MichaelPate/ToasterFlo/README.md

# ToasterFlo
 Control a toaster oven to make PCB assemblies
