MichaelPate/ToasterFlo/mainBoard/Images/review/pcb_all_layers.png

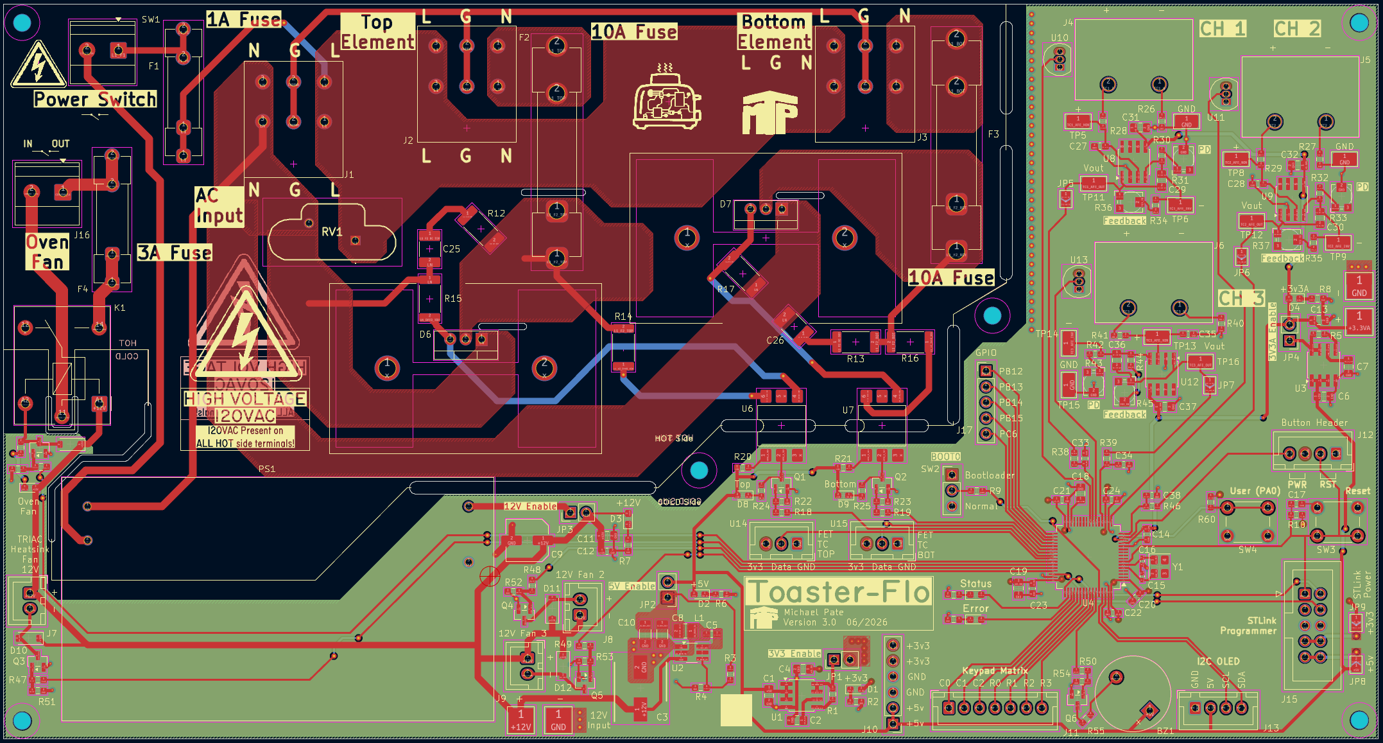
mainBoard/Images/review/pcb_all_layers.png
