MichaelPate/ToasterFlo/mainBoard/Images/review/pcb_no_silk.png

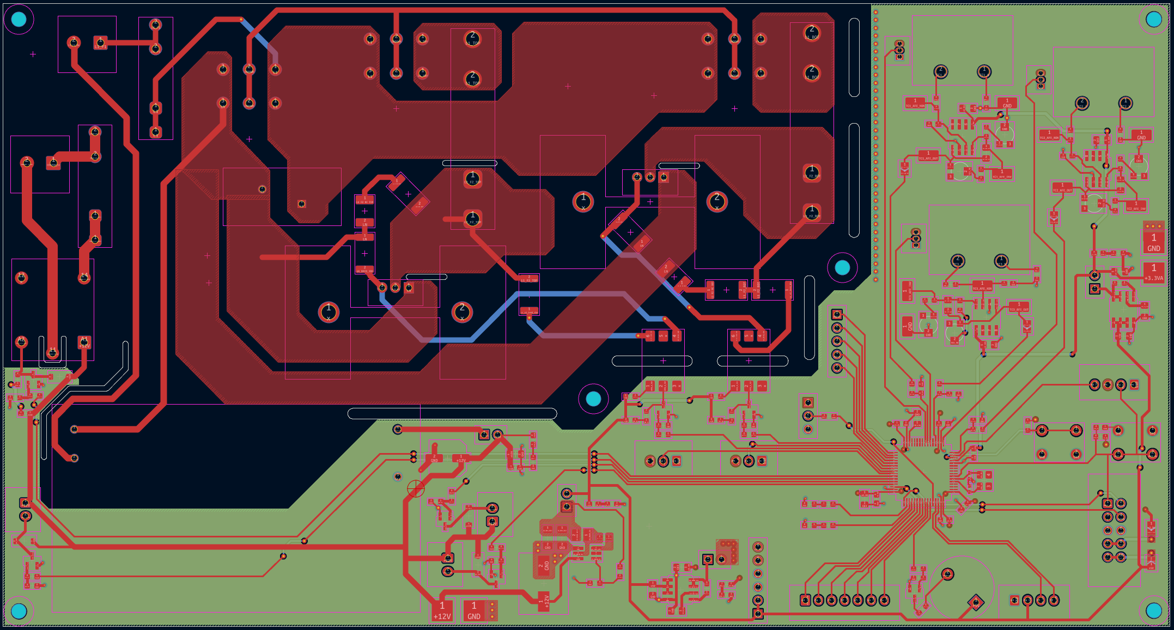
mainBoard/Images/review/pcb_no_silk.png
