MichaelPate/ToasterFlo/mainBoard/Images/review/pcb_no_zones.png

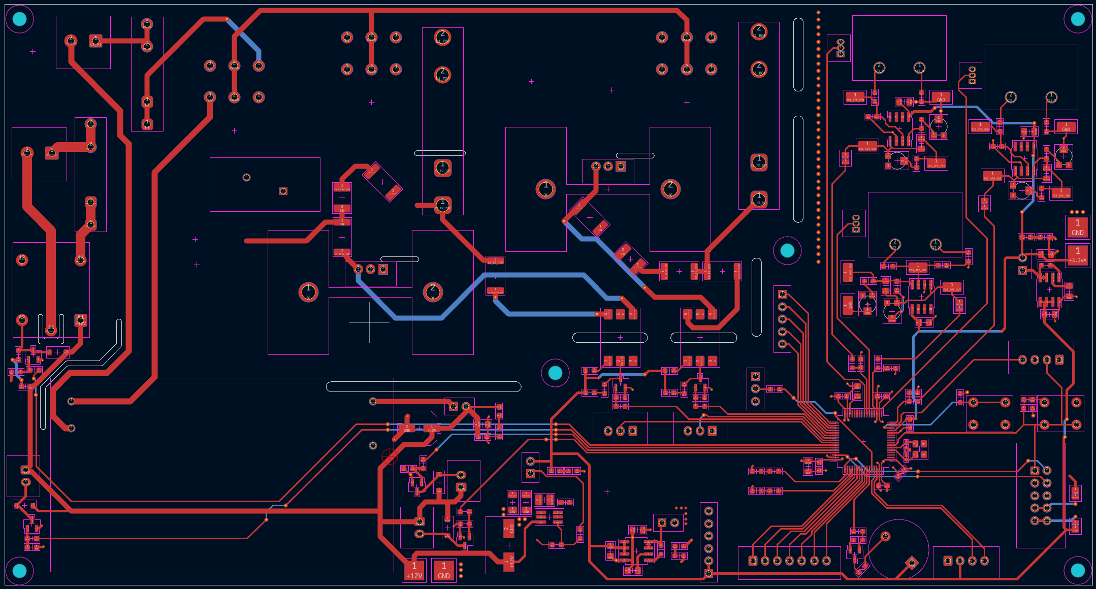
mainBoard/Images/review/pcb_no_zones.png
