MichaelPate/ToasterFlo/mainBoard/Images/review/review_07-29-2026/mainBoard-5.png

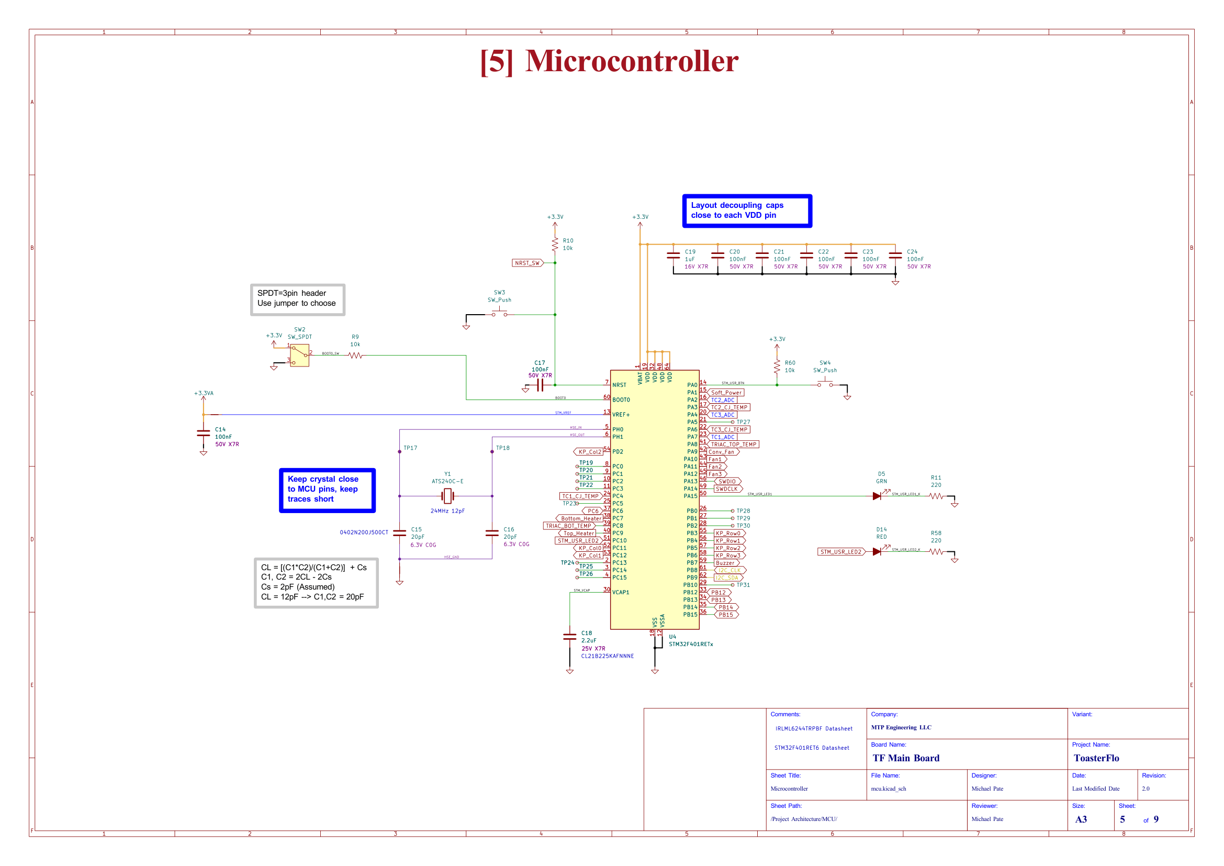
mainBoard/Images/review/review_07-29-2026/mainBoard-5.png
