MichaelPate/ToasterFlo/mainBoard/Images/review/review_07-29-2026/mainBoard-6.png

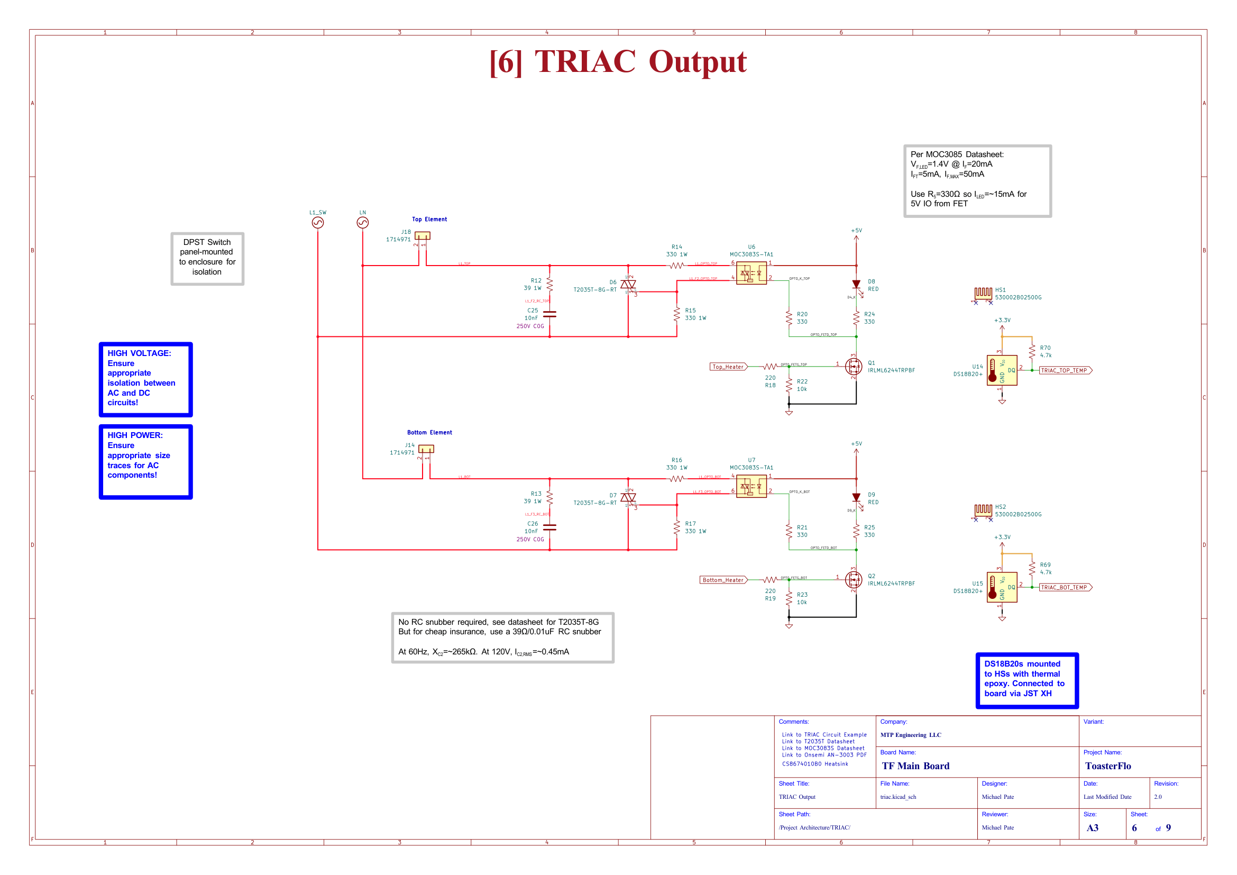
mainBoard/Images/review/review_07-29-2026/mainBoard-6.png
