MichaelPate/ToasterFlo/mainBoard/Images/review/review_07-29-2026/mainBoard-9.png

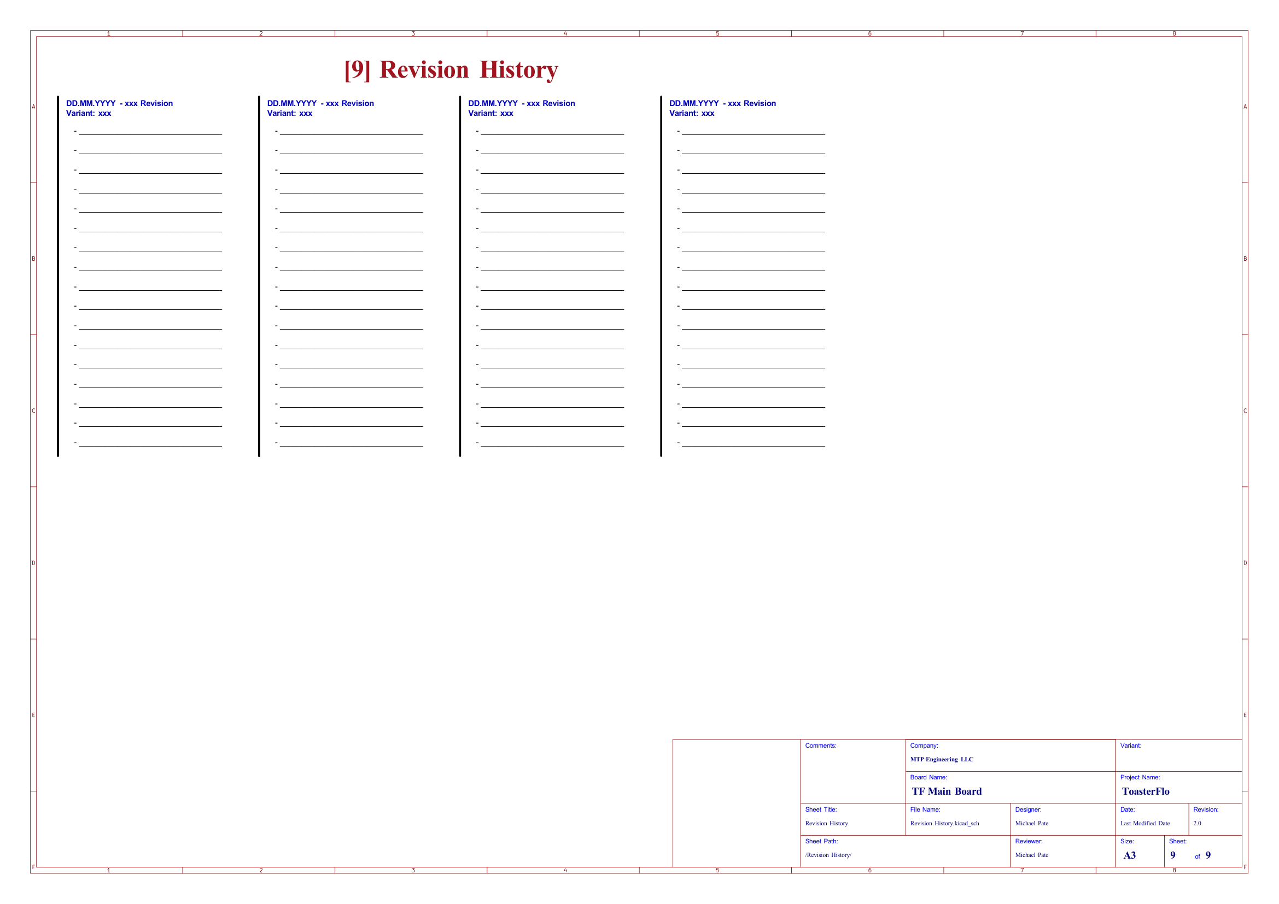
mainBoard/Images/review/review_07-29-2026/mainBoard-9.png
