MichaelPate/ToasterFlo/mainBoard/Images/review/review_07-29-2026/pcb_bottom.png

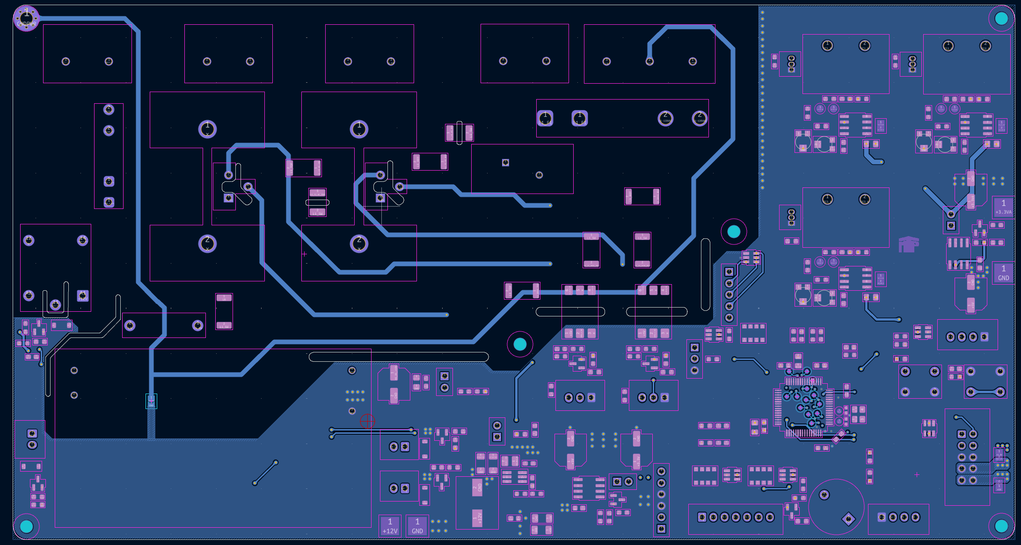
mainBoard/Images/review/review_07-29-2026/pcb_bottom.png
