MichaelPate/ToasterFlo/mainBoard/Images/review/review_07-29-2026/pcb_full.png

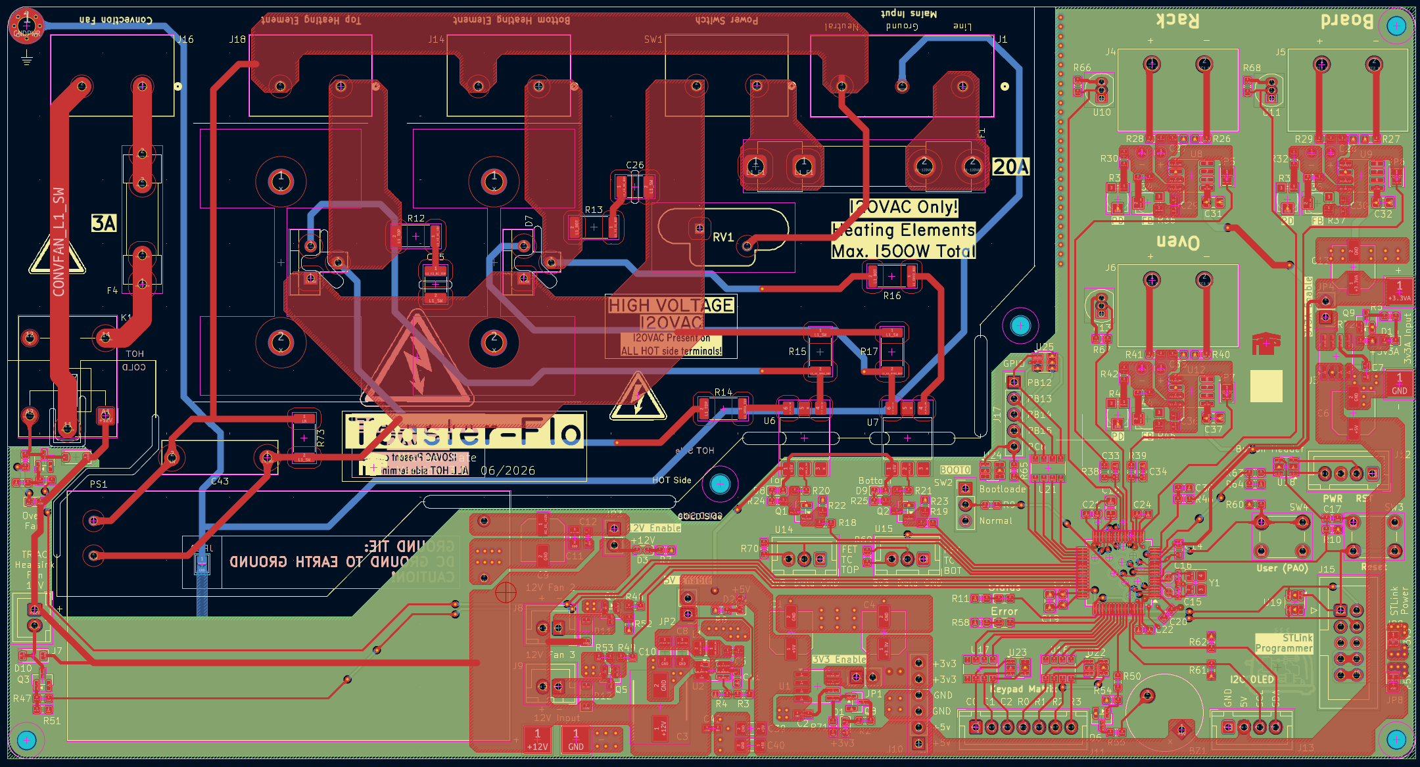
mainBoard/Images/review/review_07-29-2026/pcb_full.png
