MichaelPate/ToasterFlo/mainBoard/Images/review/review_07-29-2026/render_bottom.png

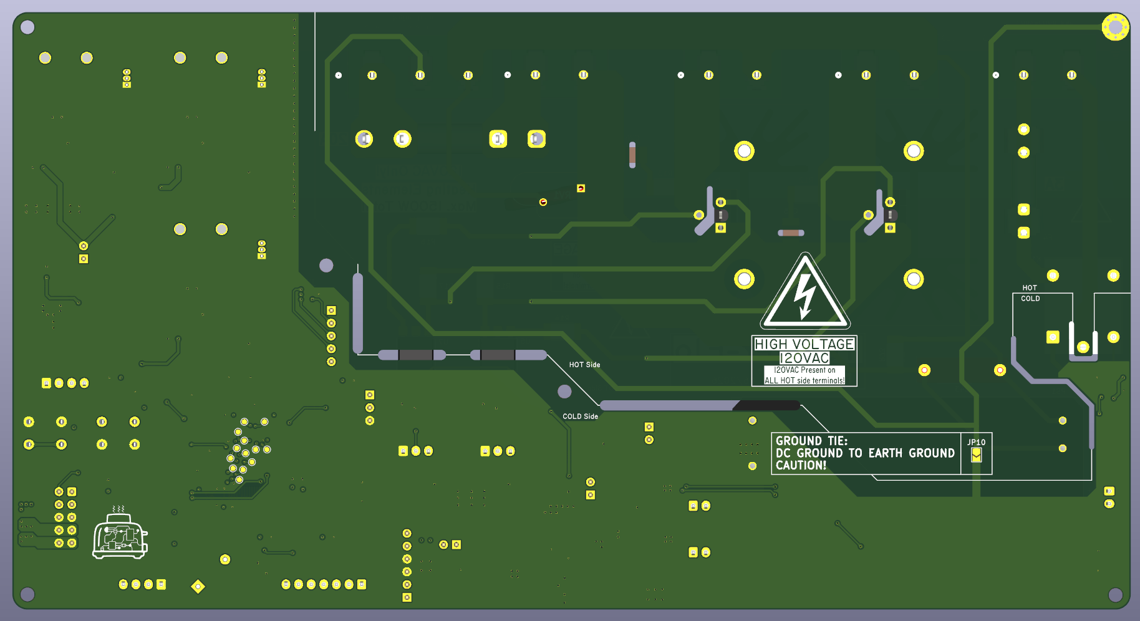
mainBoard/Images/review/review_07-29-2026/render_bottom.png
