MichaelPate/ToasterFlo/mainBoard/Images/toaster_lineart_picture.png

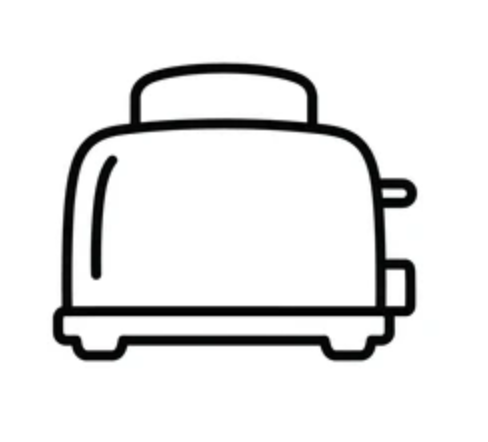
mainBoard/Images/toaster_lineart_picture.png
