MichaelPate/ToasterFlo/mainBoard/Images/toaster_lineart_picture_notoast.png

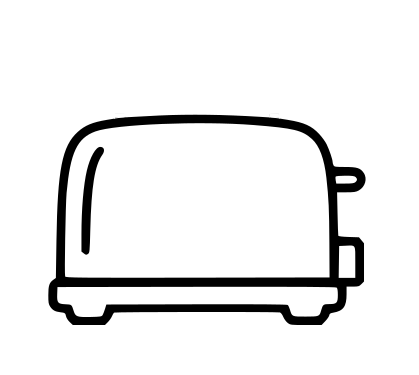
mainBoard/Images/toaster_lineart_picture_notoast.png
