MichaelPate/ToasterFlo/mainBoard/Images/toasterflo.png

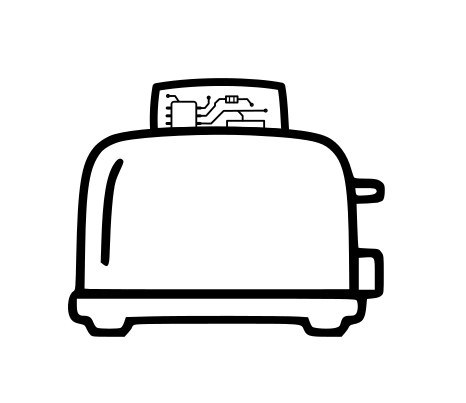
mainBoard/Images/toasterflo.png
