MichaelPate/ToasterFlo/mainBoard/Images/toasterwithcircuitsandtoast.png

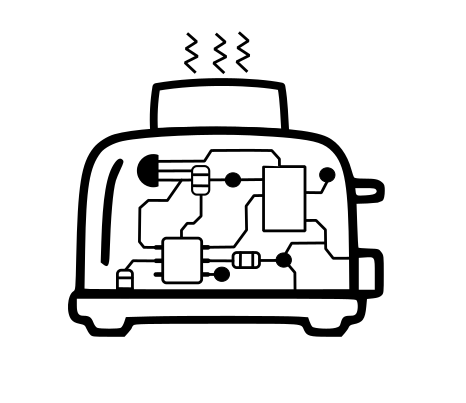
mainBoard/Images/toasterwithcircuitsandtoast.png
