MichaelPate/ToasterFlo/mainBoard/Images/yellow-triangle-warning-sign-with-black-lightning-bolt-symbol-for-high-voltage-vector.jpg

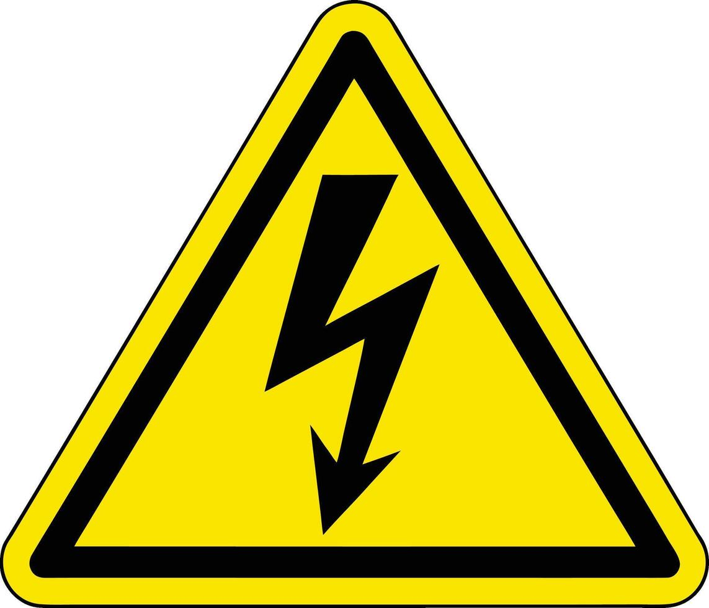
mainBoard/Images/yellow-triangle-warning-sign-with-black-lightning-bolt-symbol-for-high-voltage-vector.jpg
