MichaelPate/ToasterFlo/mainBoard/production/step export 8-12-2026/toasterflo.step

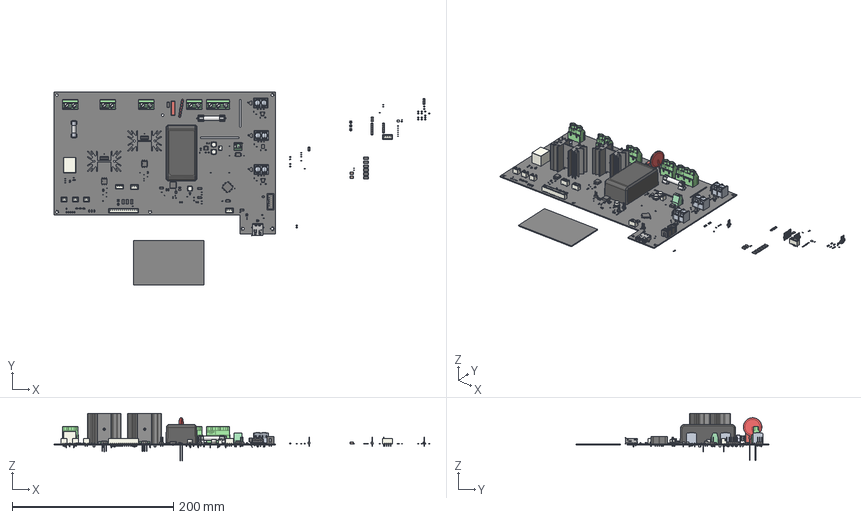
[picture p24: CAD file, 2026-08-13]
mainBoard/production/step export 8-12-2026/toasterflo.step
467.0 x 239.2 x 58.9 mm
C_0603_1608Metric x 23
SOIC-8_3.9x4.9mm_P1.27mm x 4
IRM-30
LED_0603_1608Metric x 11
C_0805_2012Metric x 18
C_0402_1005Metric x 3
SOT-23 x 6
R_0603_1608Metric x 68
TerminalBlock_Phoenix_MKDS-1,5-2-5.08_1x02_P5.08mm_Horizontal
JST_B2B_PH_K
TSSOP-8_4.4x3mm_P0.65mm
C-2-1437667-4 x 3
SOT-23-6 x 7
C_1206_3216Metric x 4
JST_B3B_XH_A x 3
R_Array_Convex_4x1206 x 4
V1000LA160BPX10
R_2512_6332Metric x 7
C_Elec_63x58 x 3
TSOT-23-8
3A Fuse
Relay_SPDT_Finder_36.11
529802B02500G x 2
C_1812_4532Metric x 2
TO-92_Inline_Narrow x 3
TO-220-3_Vertical x 2
PinHeader_1x03_P254mm_Vertical
Crystal_SMD_3225-4Pin_3.2x2.5mm
PinHeader_1x05_P254mm_Vertical
DIP-4_W7.62mm
JST_B2B_XH_A x 3
PinHeader_1x02_P254mm_Vertical x 5
C_Rect_L180mm_W50mm_P1500mm_FKS3_FKP3
D_SOD-123 x 4
JST_B14B_XH_A
PinHeader_1x06_P254mm_Vertical
L_Coilcraft_XAL7030-472
IDC_Header_2x05_P254mm_Vertical
SOT-23-5
USB_A_Molex_67643_Horizontal
JST_B4B_XH_A
LQFP-64_10x10mm_P0.5mm
SMDIP_6_W953mm x 2
REAR x 2
01020071Z Rev 1 x 2
mainBoard_PCB_1
mainBoard_PCB_2
