MichaelPate/ToasterFlo/mainBoard/Images/review/review_07-29-2026/mainBoard.pdf

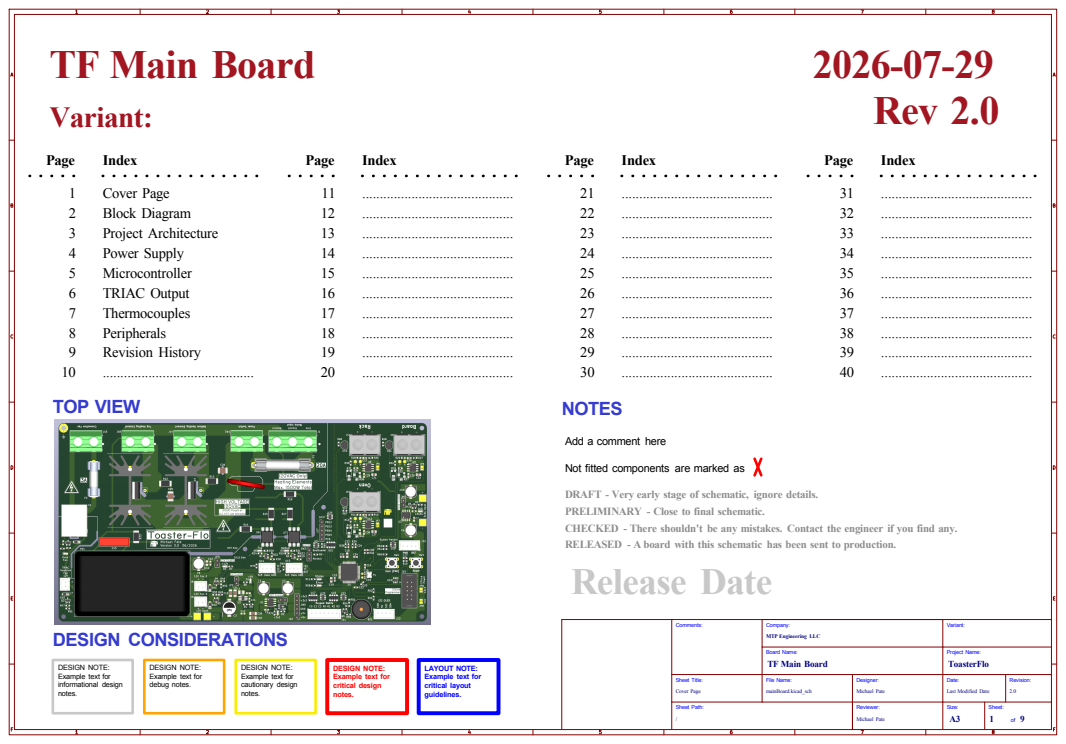
[picture p25: page 1]

........................................... CHECKED - There shouldn't be any mistakes. Contact the engineer if you find any.
NOTES

Not fitted components are marked as

DRAFT - Very early stage of schematic, ignore details.
PRELIMINARY - Close to final schematic.
Release Date

RELEASED - A board with this schematic has been sent to production.

notes. DESIGN NOTE: Example text for

File: Project Architecture.kicad_sch DESIGN NOTE: Example text for cautionary design

DESIGN NOTE: Example text for critical design

notes. Metadata can be set in File → Schematic Setup → Project → Text Variables

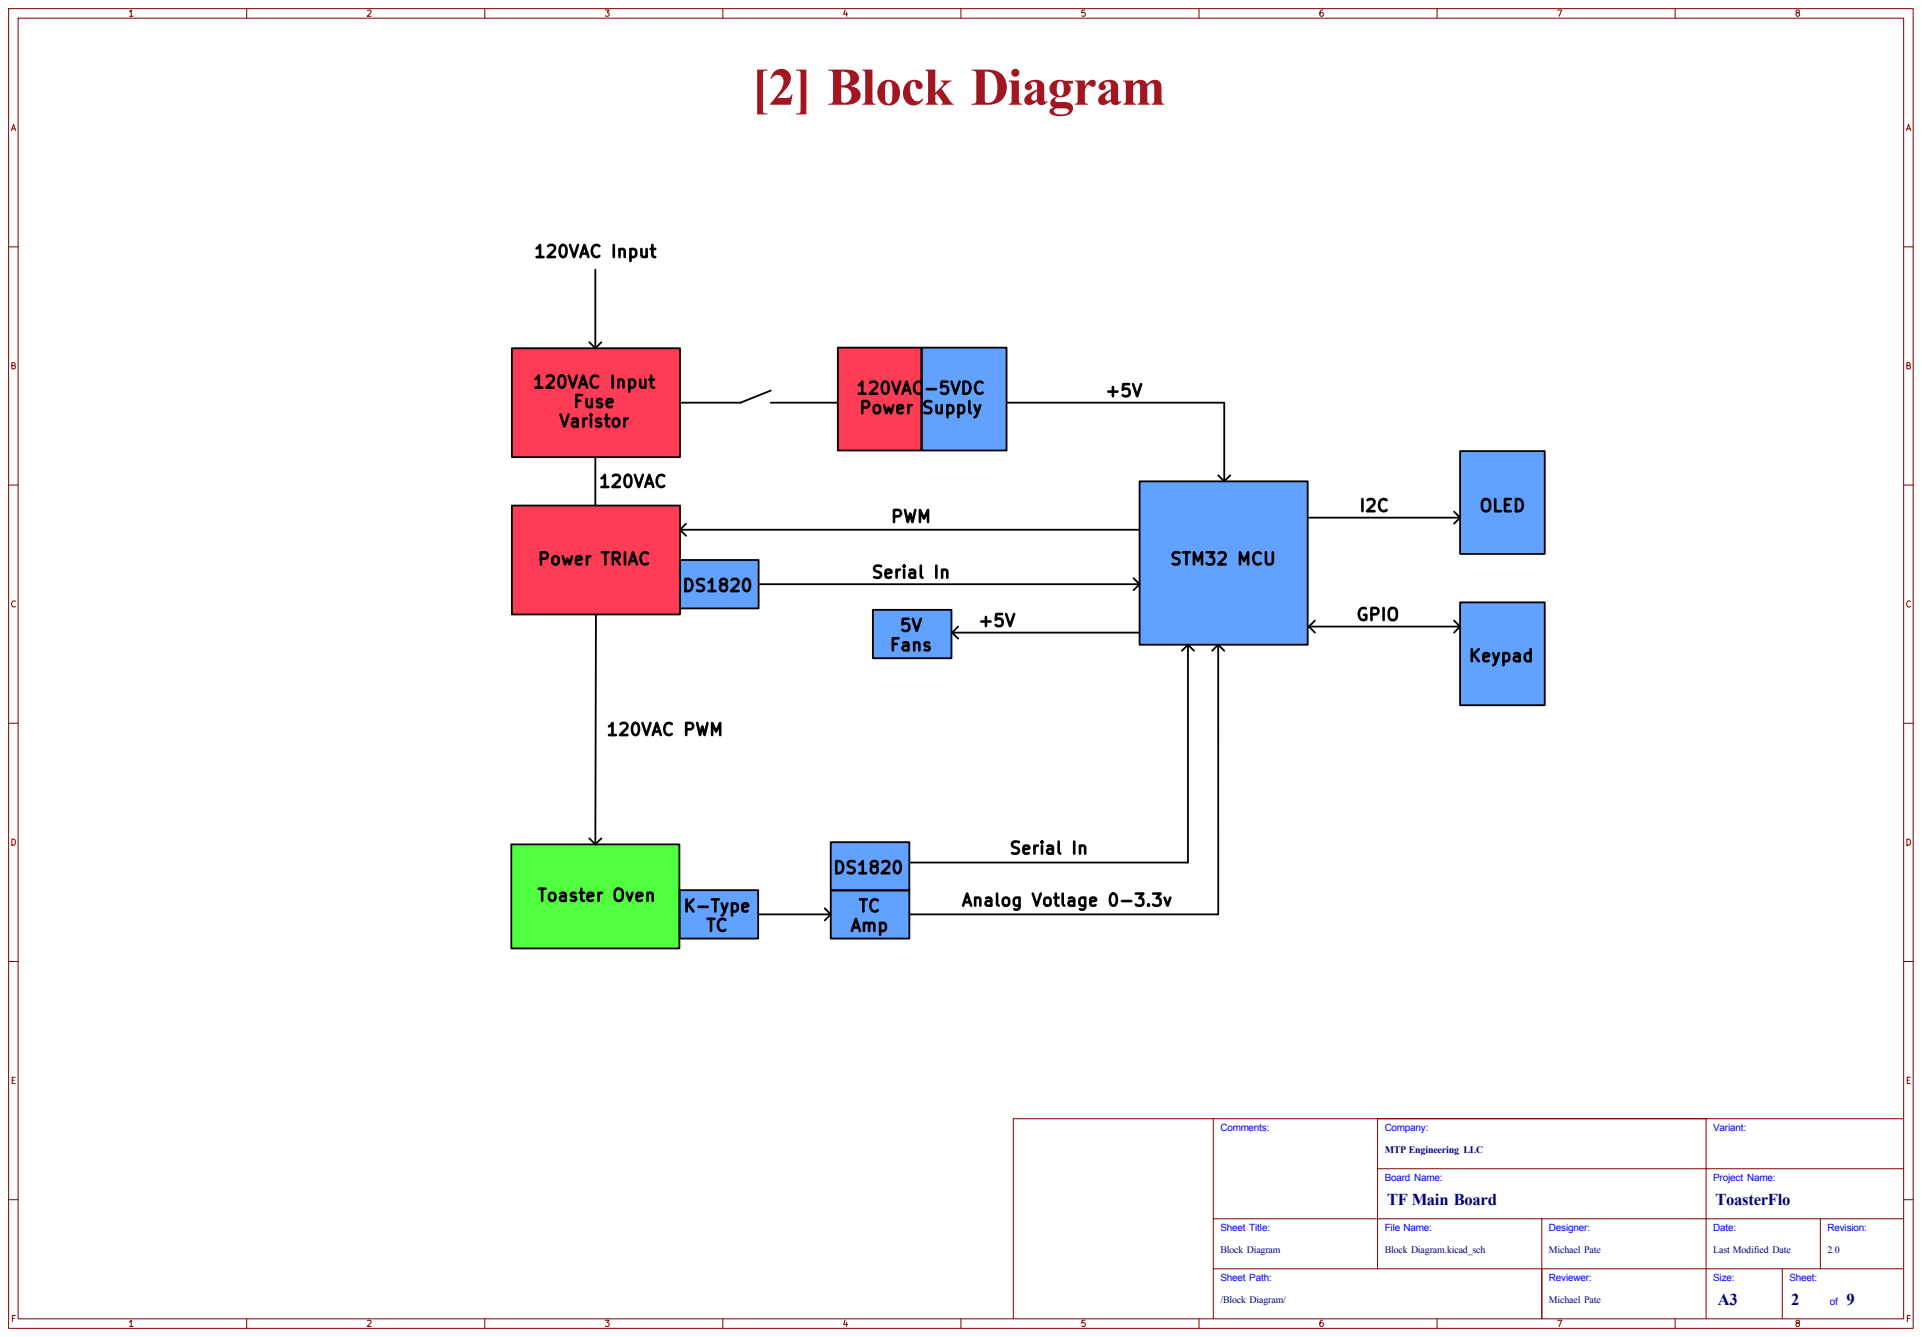
[picture p26: page 2]

/Block Diagram/ Sheet Path: Block Diagram

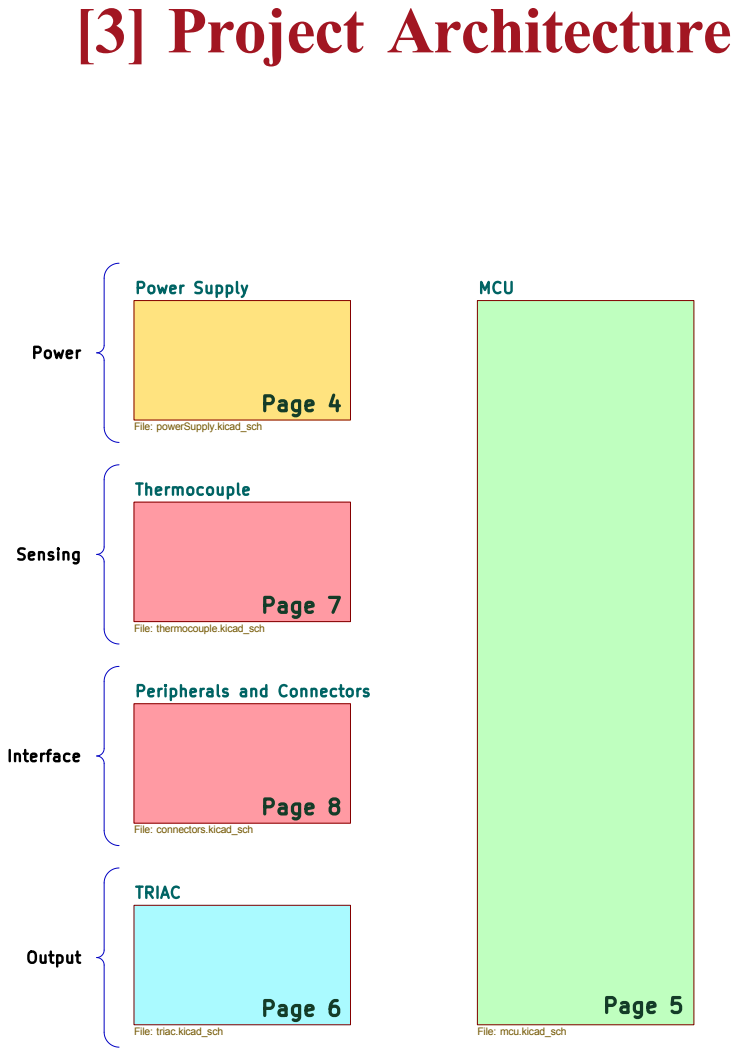
[picture p27: page 3]

File: thermocouple.kicad_sch Power Supply
File: connectors.kicad_sch Thermocouple

/Project Architecture/ Sheet Path: Project Architecture Comments: Peripherals and Connectors

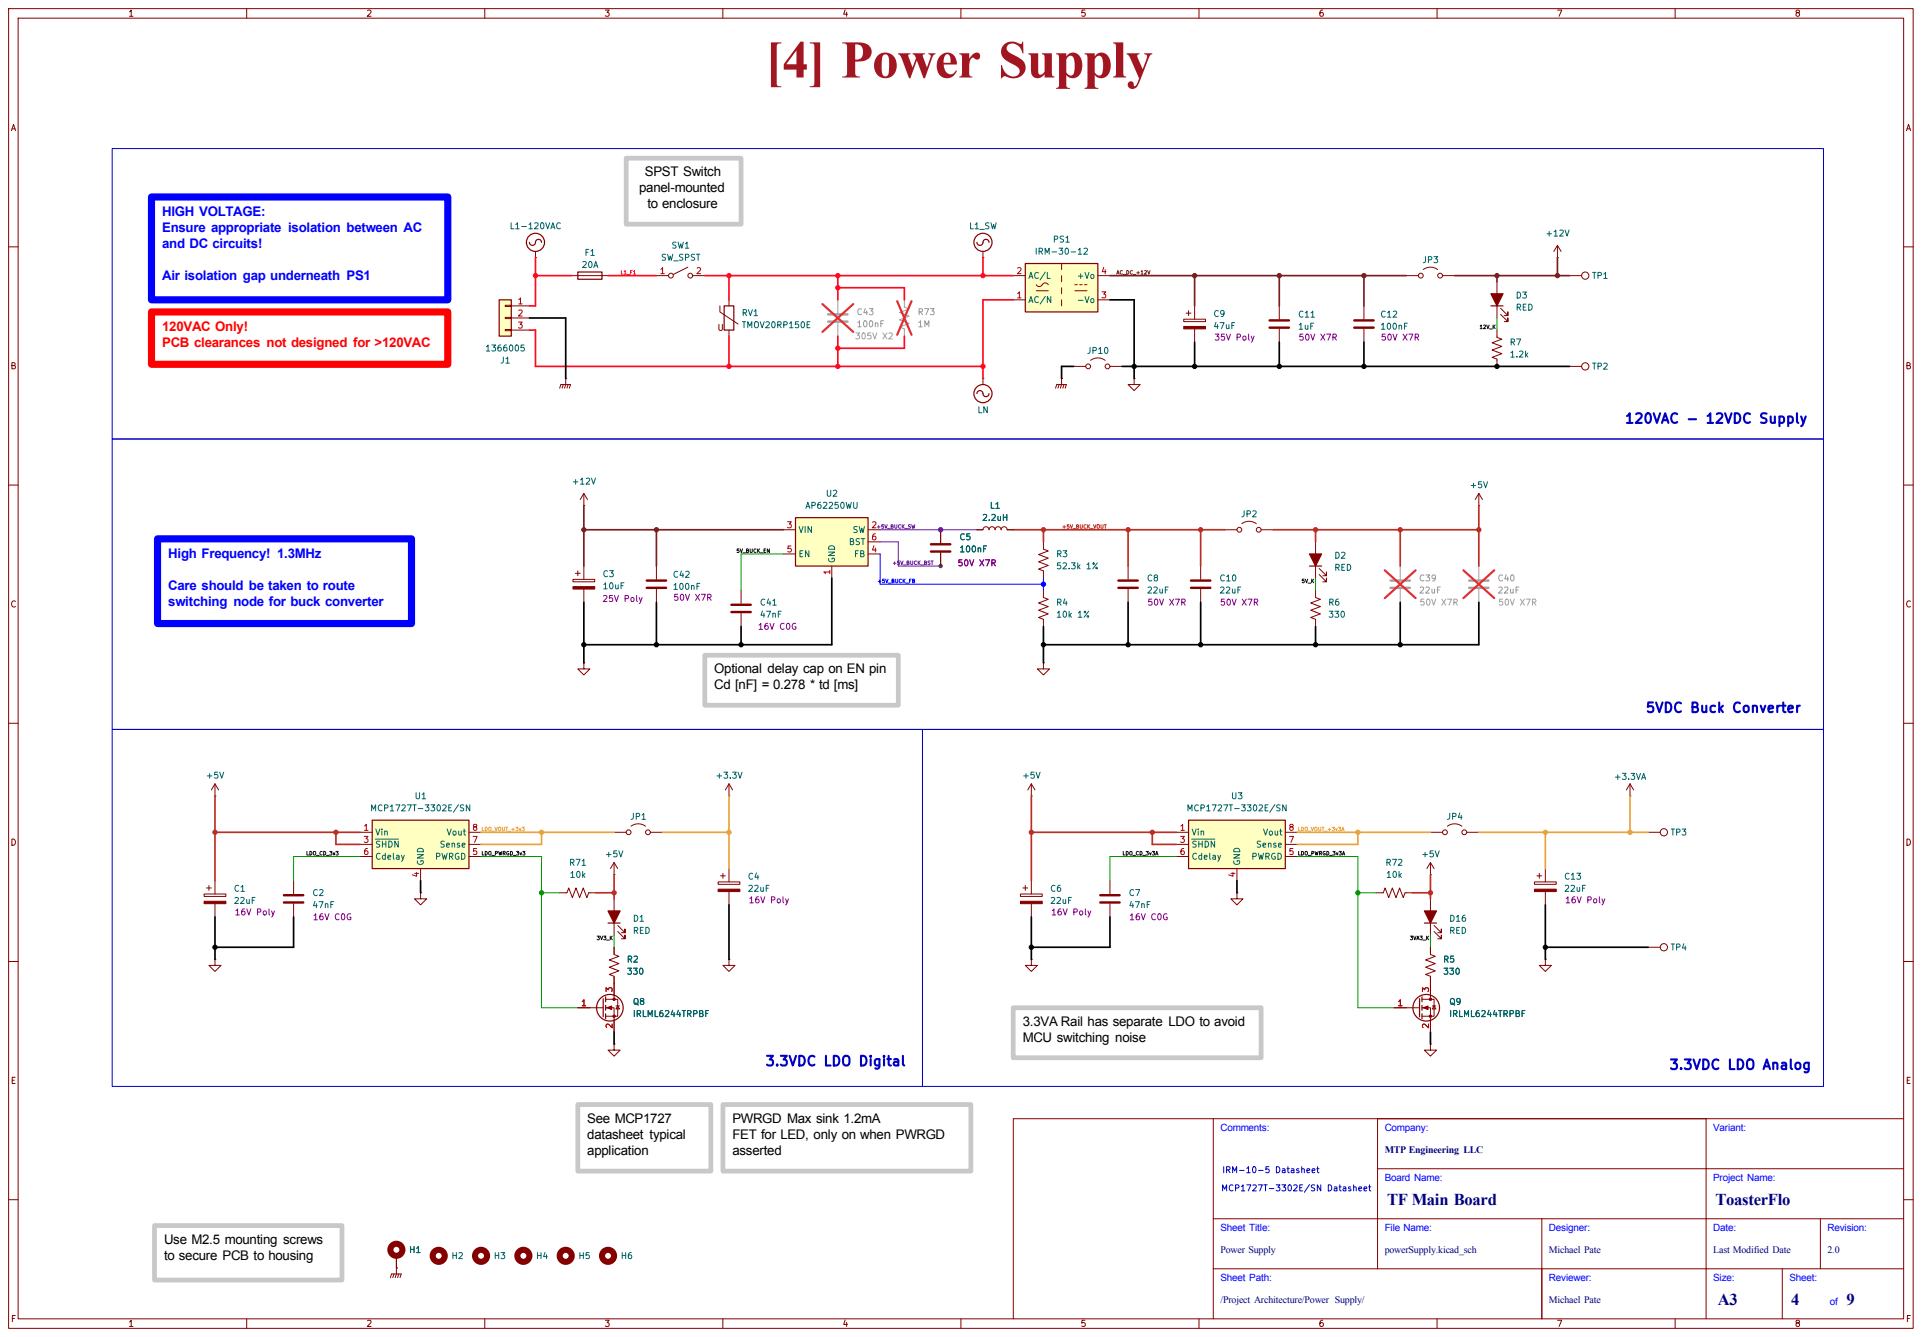
[picture p28: page 4]

to enclosure HIGH VOLTAGE: Ensure appropriate isolation between AC

and DC circuits! Air isolation gap underneath PS1

120VAC Only! PCB clearances not designed for >120VAC

asserted High Frequency! 1.3MHz Care should be taken to route

3.3VA Rail has separate LDO to avoid MCU switching noise Optional delay cap on EN pin Cd [nF] = 0.278 * td [ms] PWRGD Max sink 1.2mA

5VDC Buck Converter MCP1727T-3302E/SN Datasheet

FET for LED, only on when PWRGD

/Project Architecture/Power Supply/ Sheet Path: Power Supply Comments:

application Use M2.5 mounting screws

to secure PCB to housing

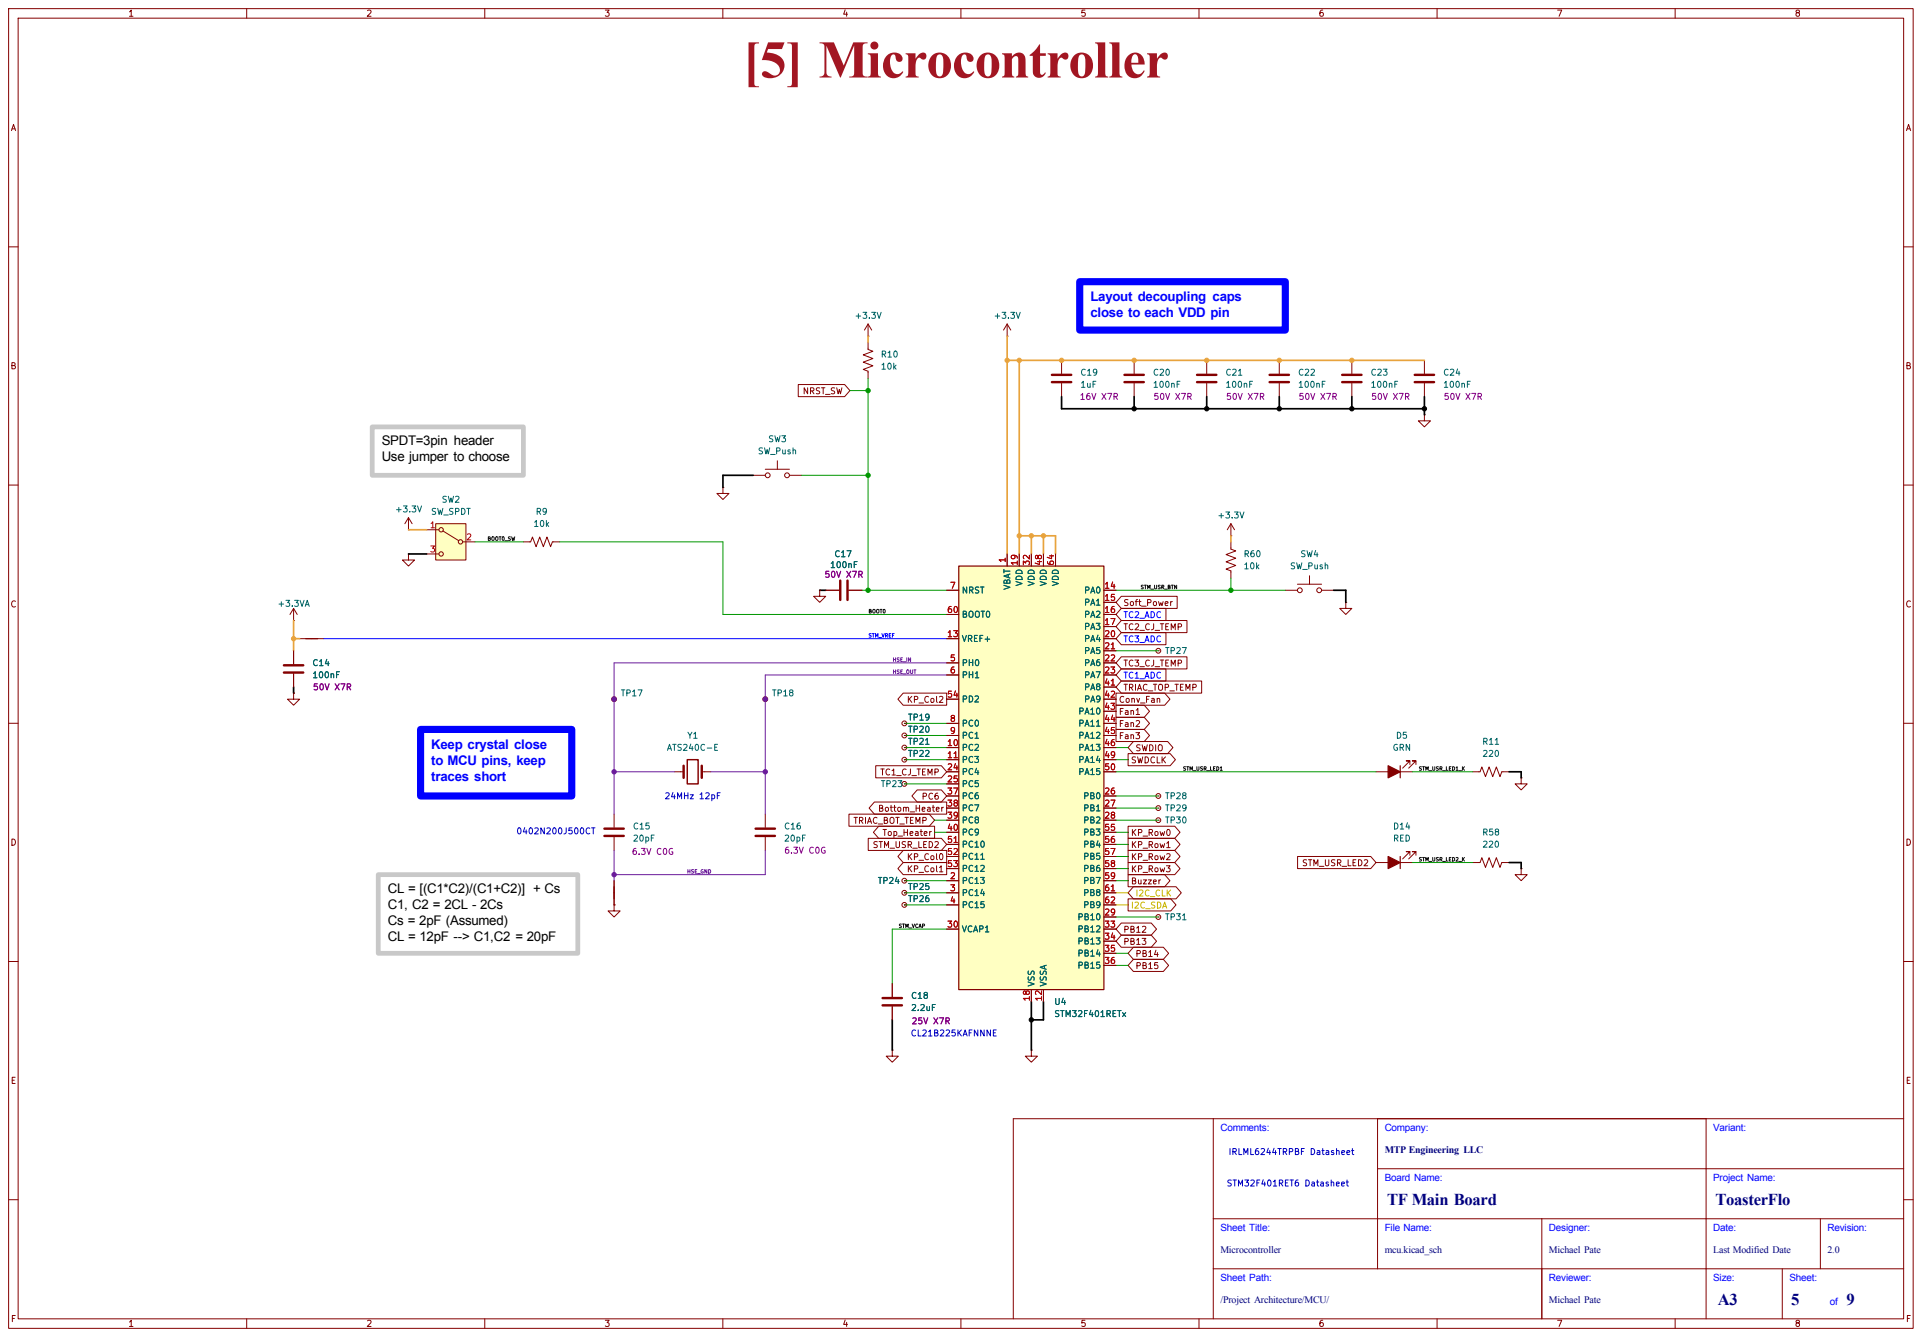
[picture p29: page 5]

close to each VDD pin

SPDT=3pin header Use jumper to choose

Keep crystal close
to MCU pins, keep

CL = [(C1*C2)/(C1+C2)] + Cs C1, C2 = 2CL - 2Cs Cs = 2pF (Assumed) CL = 12pF --> C1,C2 = 20pF

/Project Architecture/MCU/ Sheet Path: Microcontroller Comments:

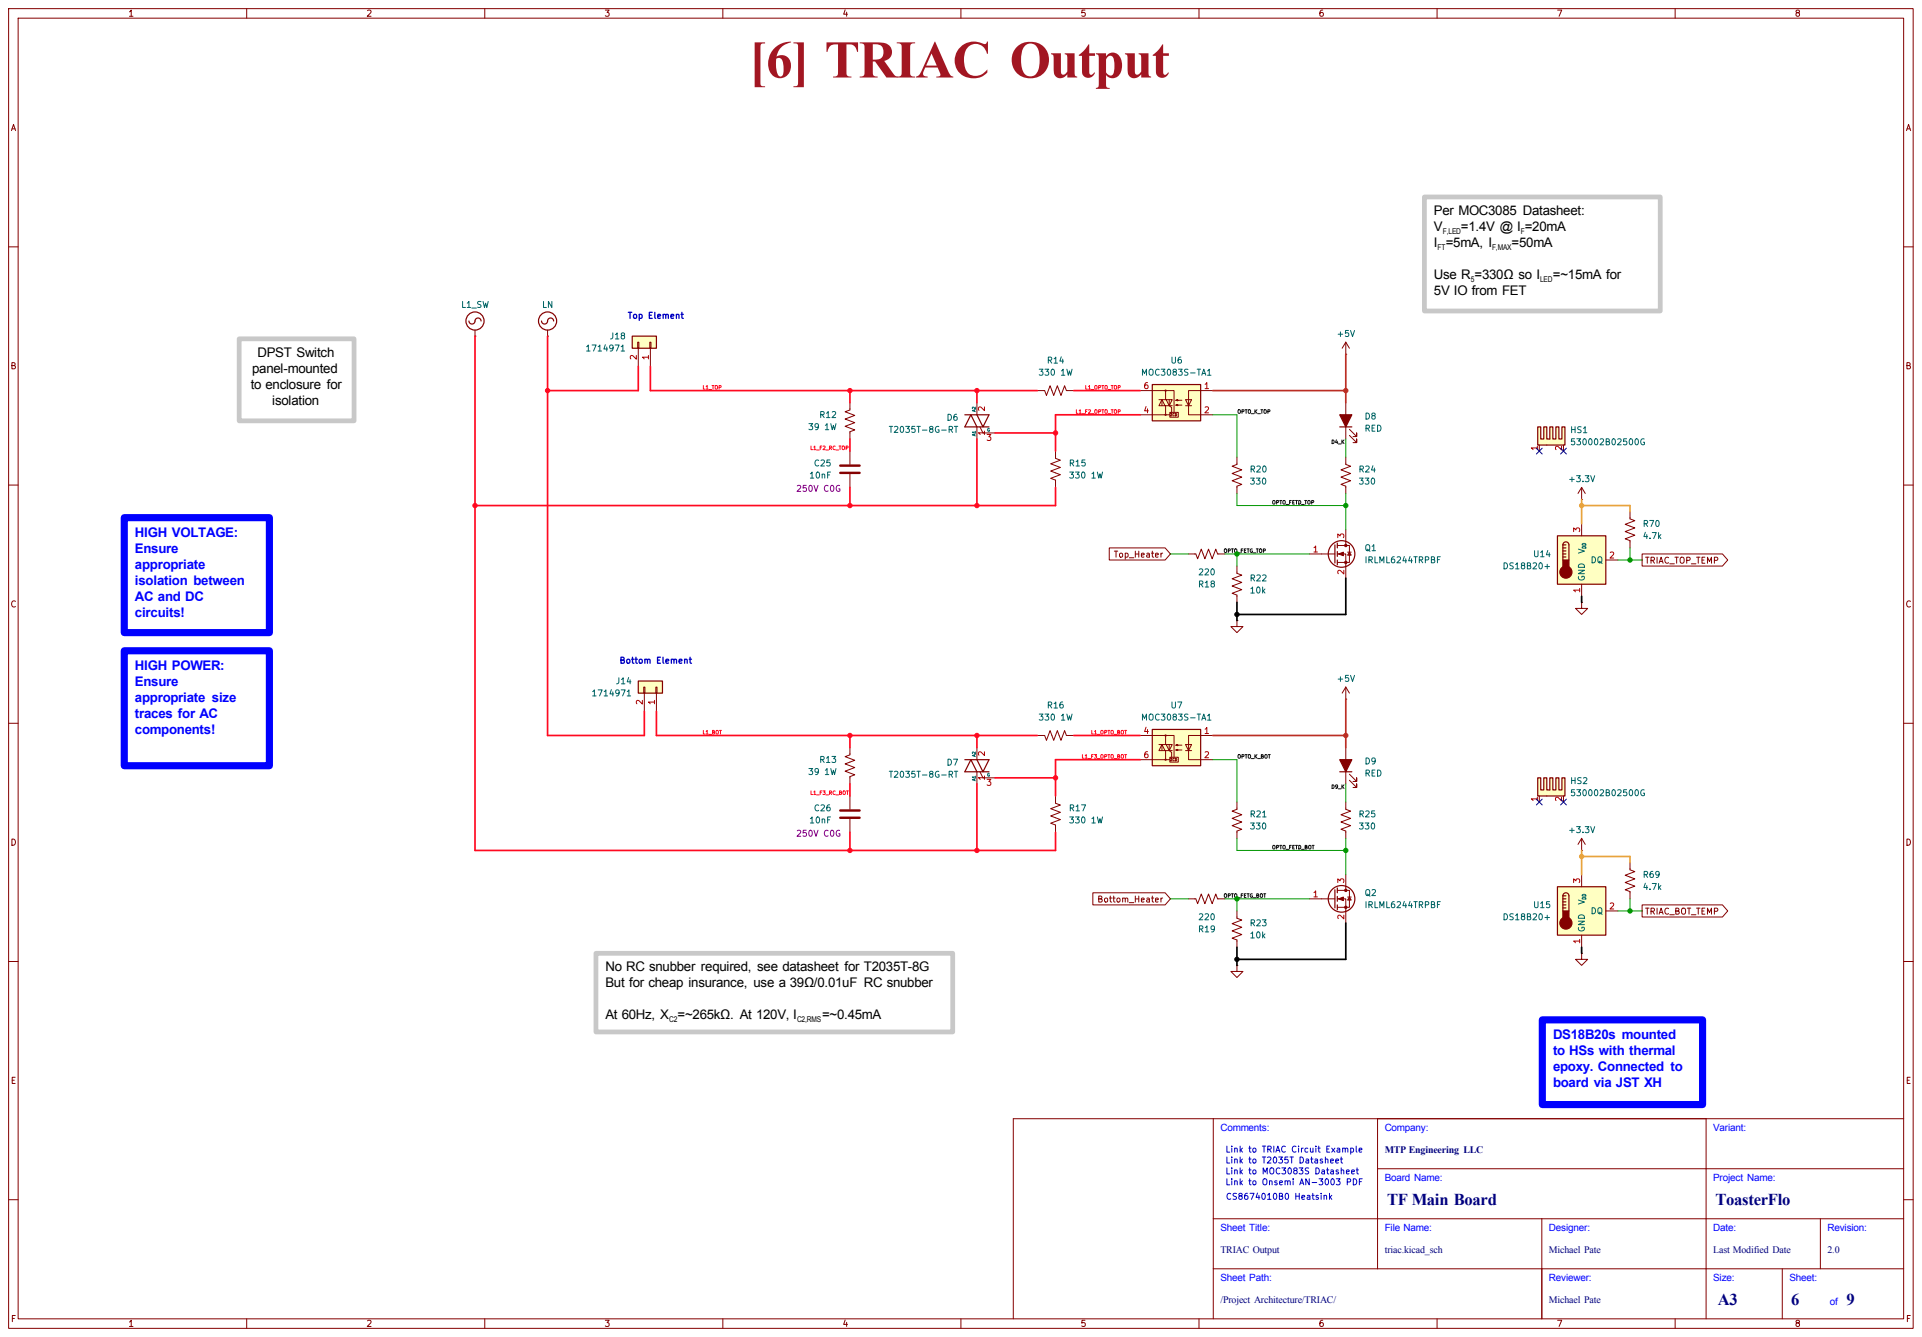
[picture p30: page 6]

IFT=5mA, IF,MAX=50mA Use R5=330Ω so ILED=~15mA for 5V IO from FET [6] TRIAC Output

Per MOC3085 Datasheet: VF,LED=1.4V @ IF=20mA

But for cheap insurance, use a 39Ω/0.01uF RC snubber At 60Hz, XC2=~265kΩ. At 120V, IC2,RMS=~0.45mA HIGH VOLTAGE: Ensure

appropriate
isolation between AC and DC

to HSs with thermal epoxy. Connected to

board via JST XH

Link to T2035T Datasheet Link to MOC3083S Datasheet Link to TRIAC Circuit Example

Link to Onsemi AN-3003 PDF CS8674010B0 Heatsink

Revision: 2.0 Date: Project Name: Last Modified Date Reviewer: Michael Pate Designer:

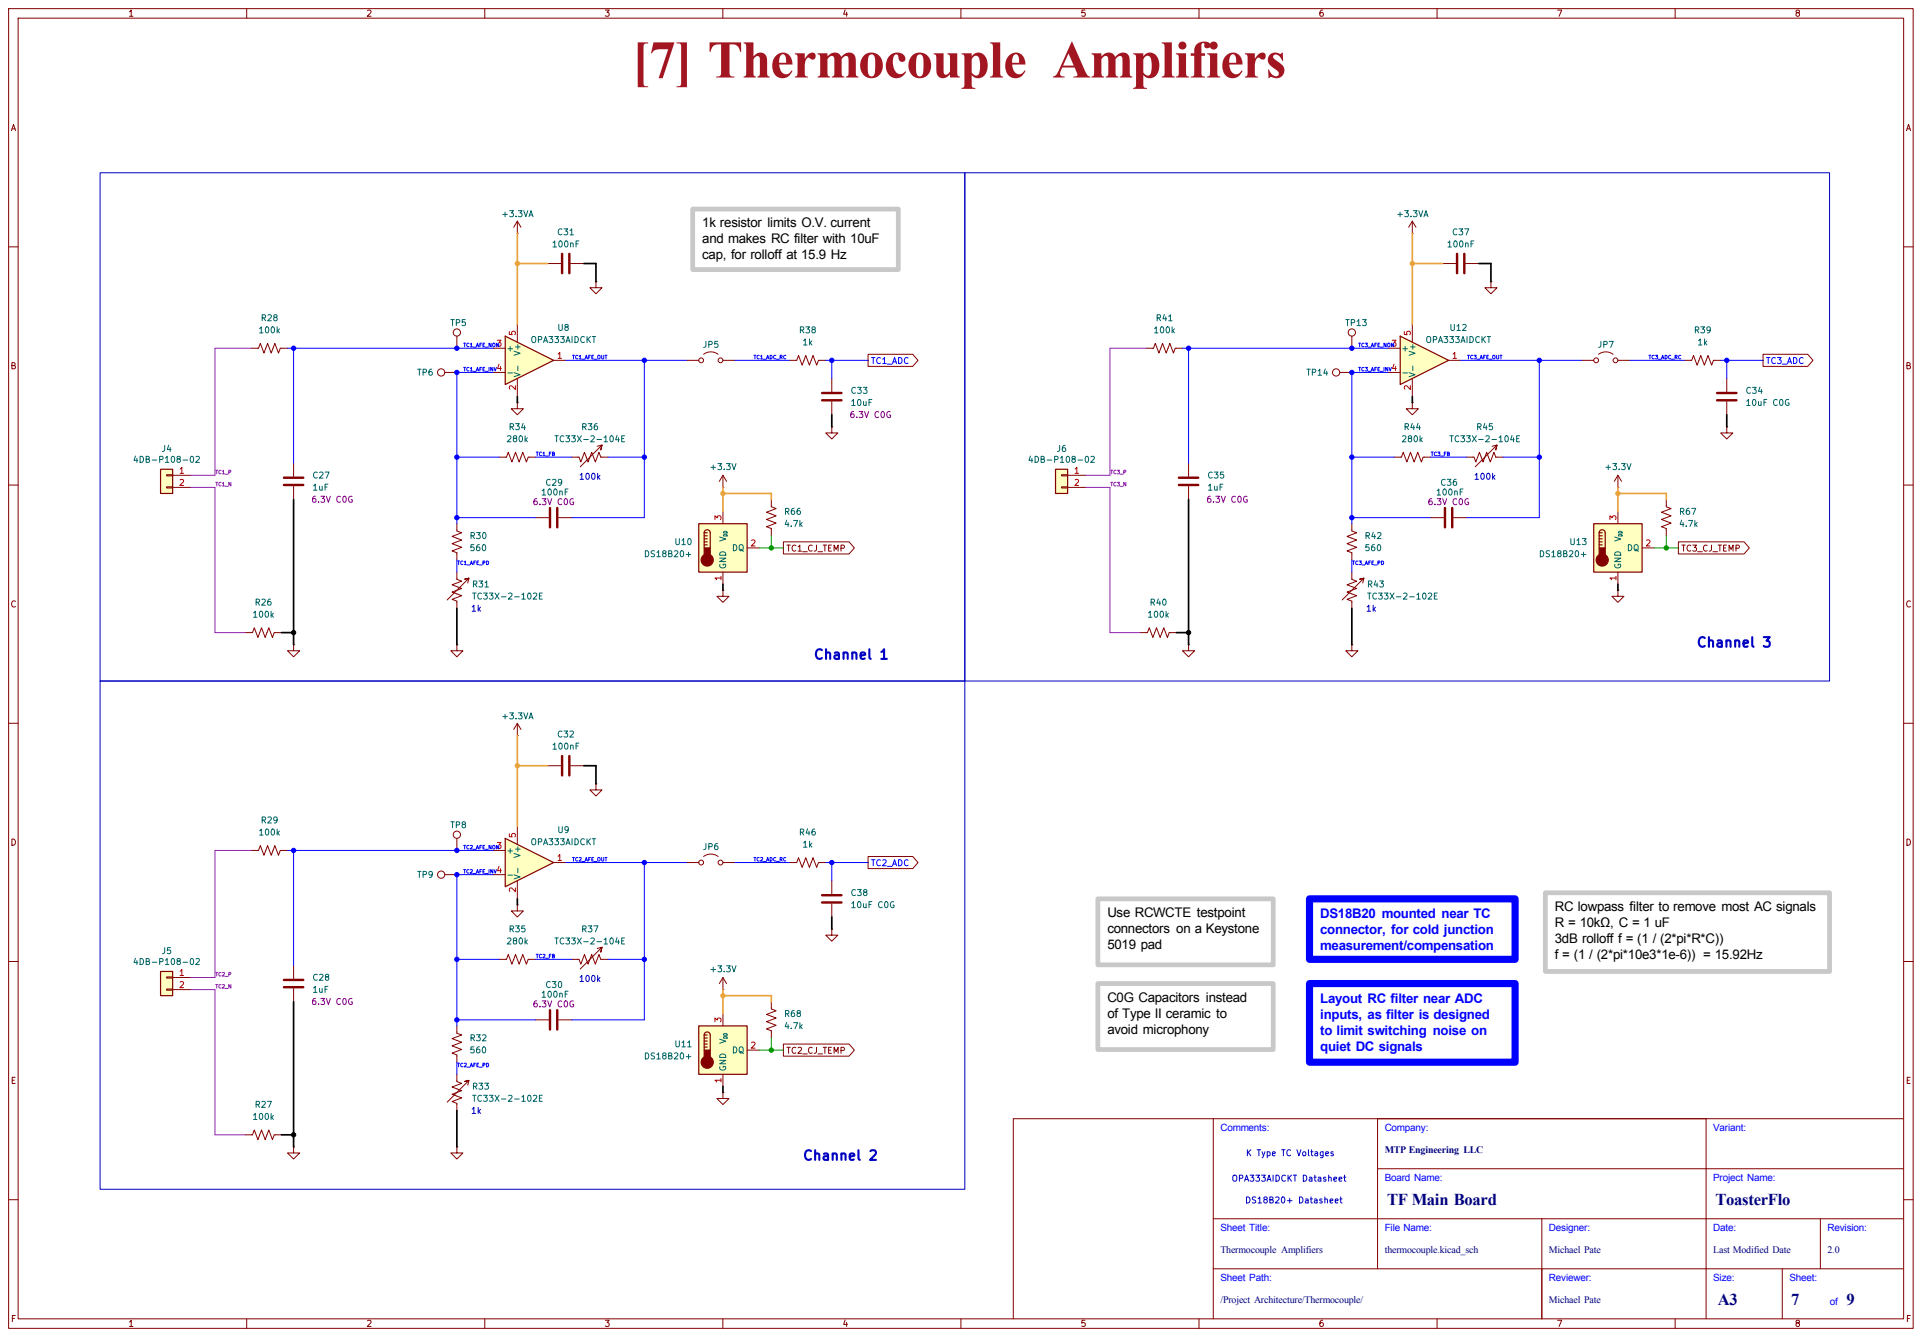
[picture p31: page 7]

TC3_N 1k resistor limits O.V. current and makes RC filter with 10uF

quiet DC signals DS18B20 mounted near TC
connector, for cold junction

Use RCWCTE testpoint connectors on a Keystone

of Type II ceramic to
avoid microphony

inputs, as filter is designed
to limit switching noise on

/Project Architecture/Thermocouple/ Sheet Path: Thermocouple Amplifiers Comments:

Revision: 2.0 Date: Project Name: Last Modified Date Reviewer: Michael Pate Designer:

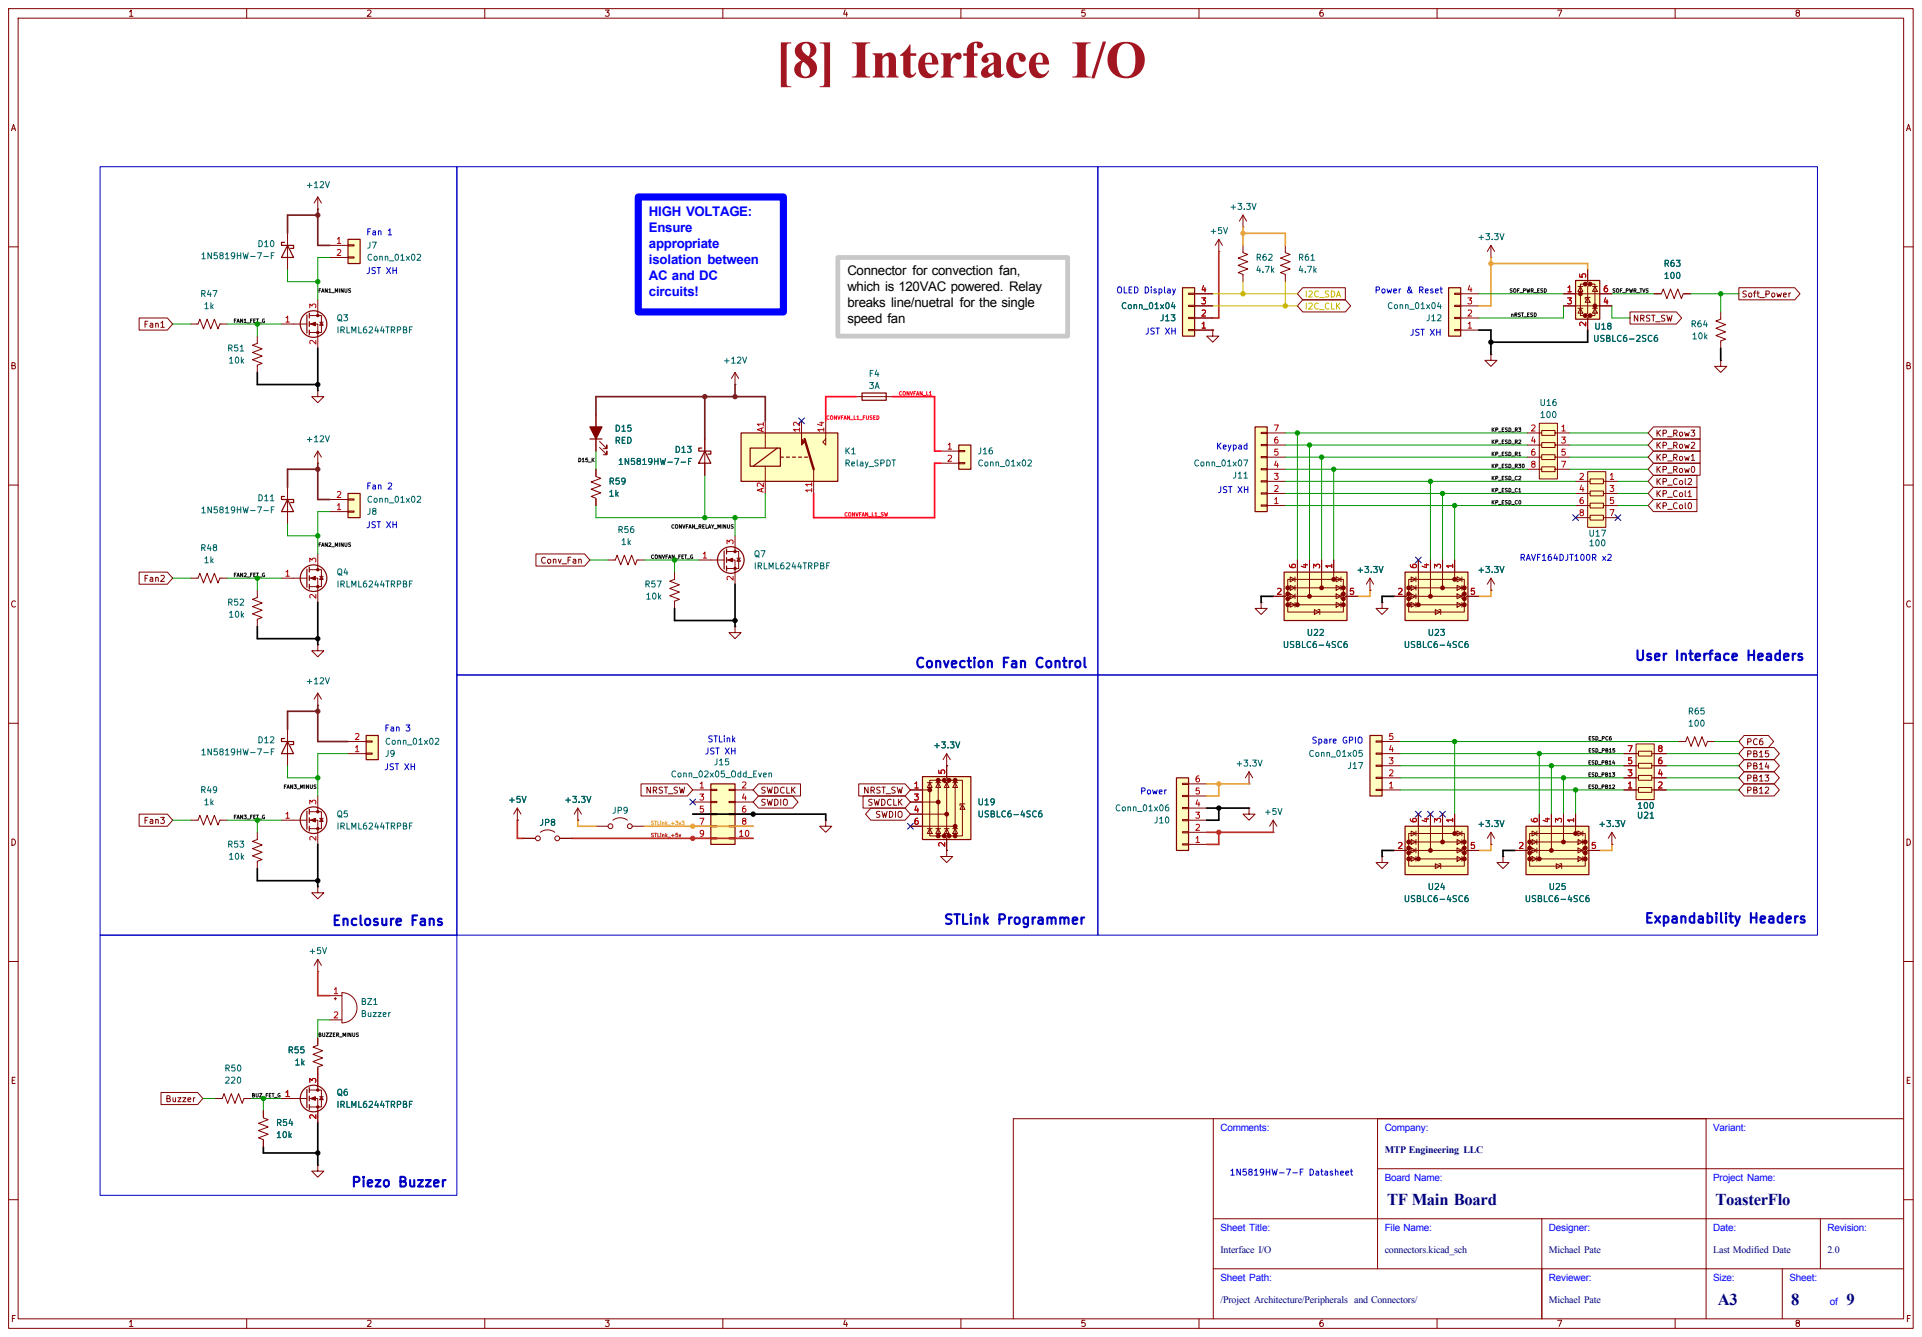
[picture p32: page 8]

speed fan HIGH VOLTAGE: Ensure

appropriate
isolation between AC and DC

Connector for convection fan, which is 120VAC powered. Relay breaks line/nuetral for the single

JST XH Convection Fan Control

4 | ESD_PB15
3 | | ESD_PB14
2 | | | ESD_PB13

/Project Architecture/Peripherals and Connectors/ Sheet Path: Interface I/O

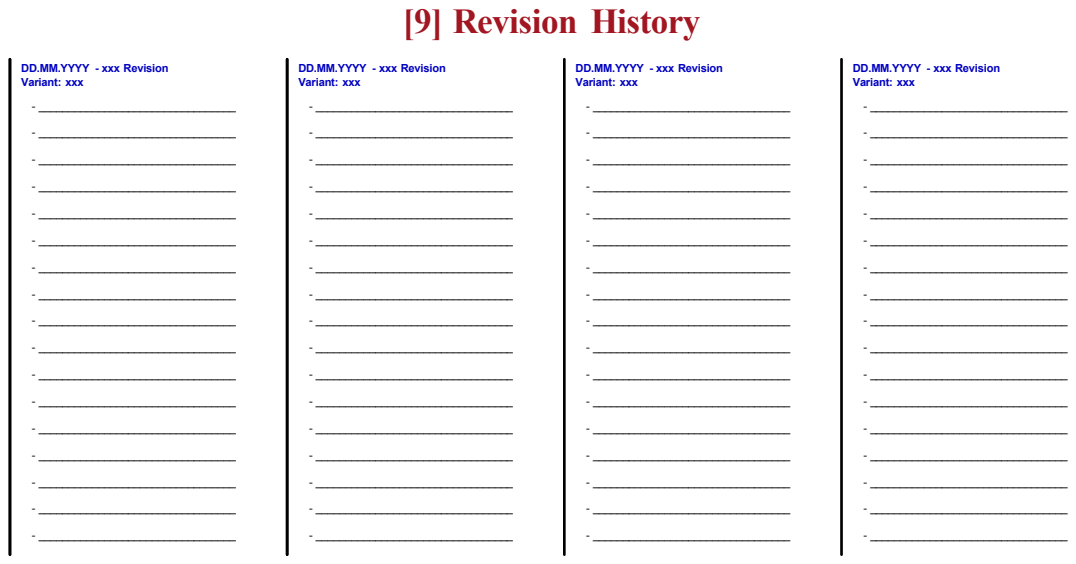
[picture p33: page 9]

/Revision History/ Sheet Path: Revision History Comments:
