MichaelPate/ToasterFlo/mainBoard/Images/review/mainBoard.pdf

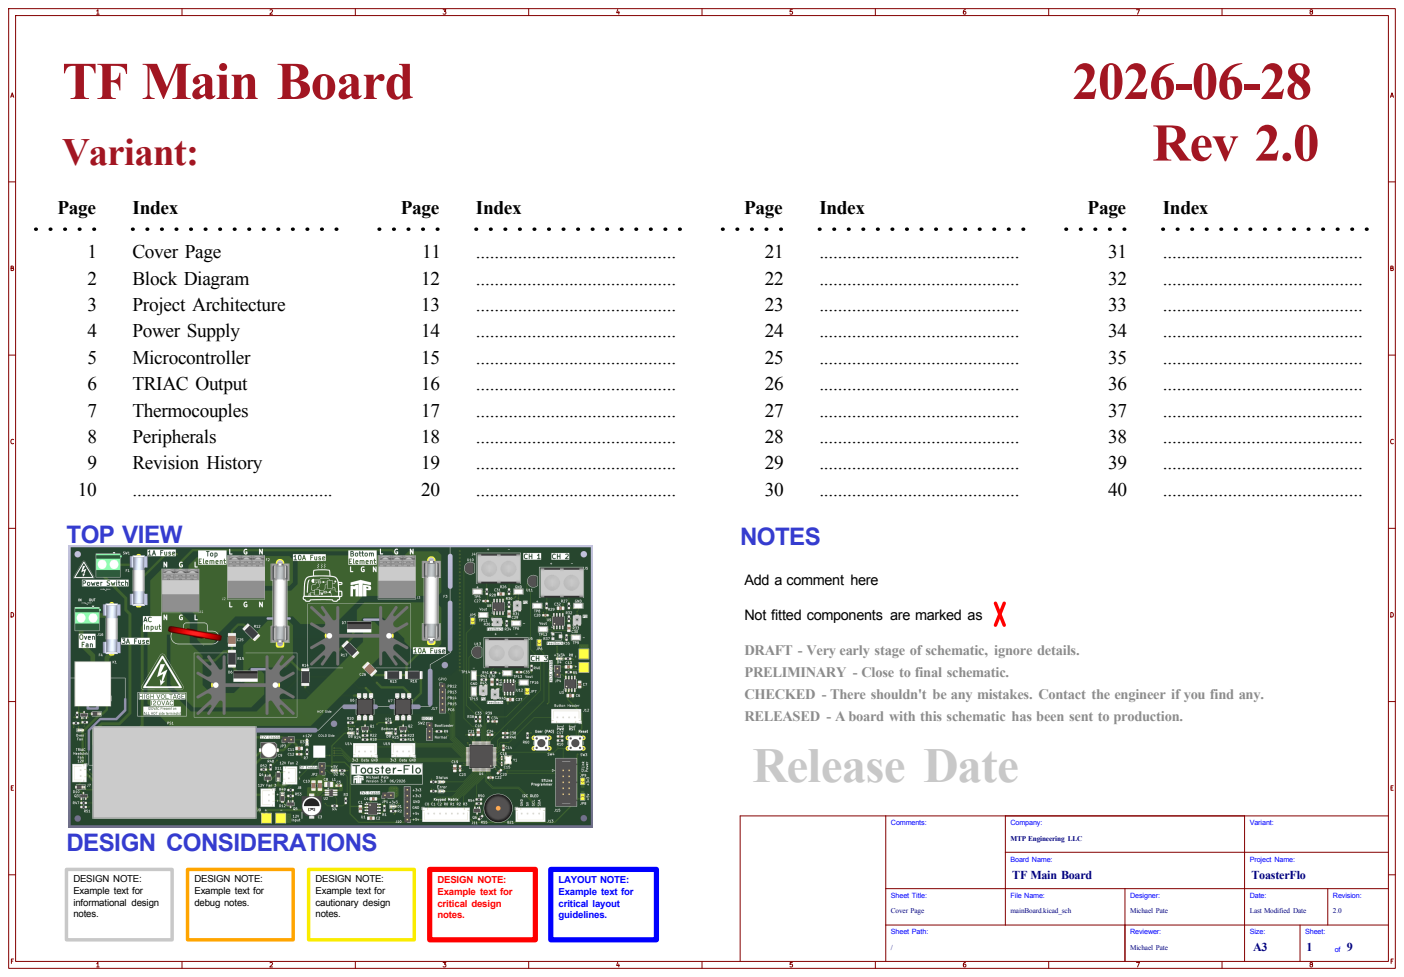
[picture p34: page 1]

CHECKED - There shouldn't be any mistakes. Contact the engineer if you find any. ...........................................

Not fitted components are marked as

DRAFT - Very early stage of schematic, ignore details.
PRELIMINARY - Close to final schematic.

RELEASED - A board with this schematic has been sent to production.

Revision: 2.0 Date: Project Name: Last Modified Date Reviewer: Michael Pate Designer:

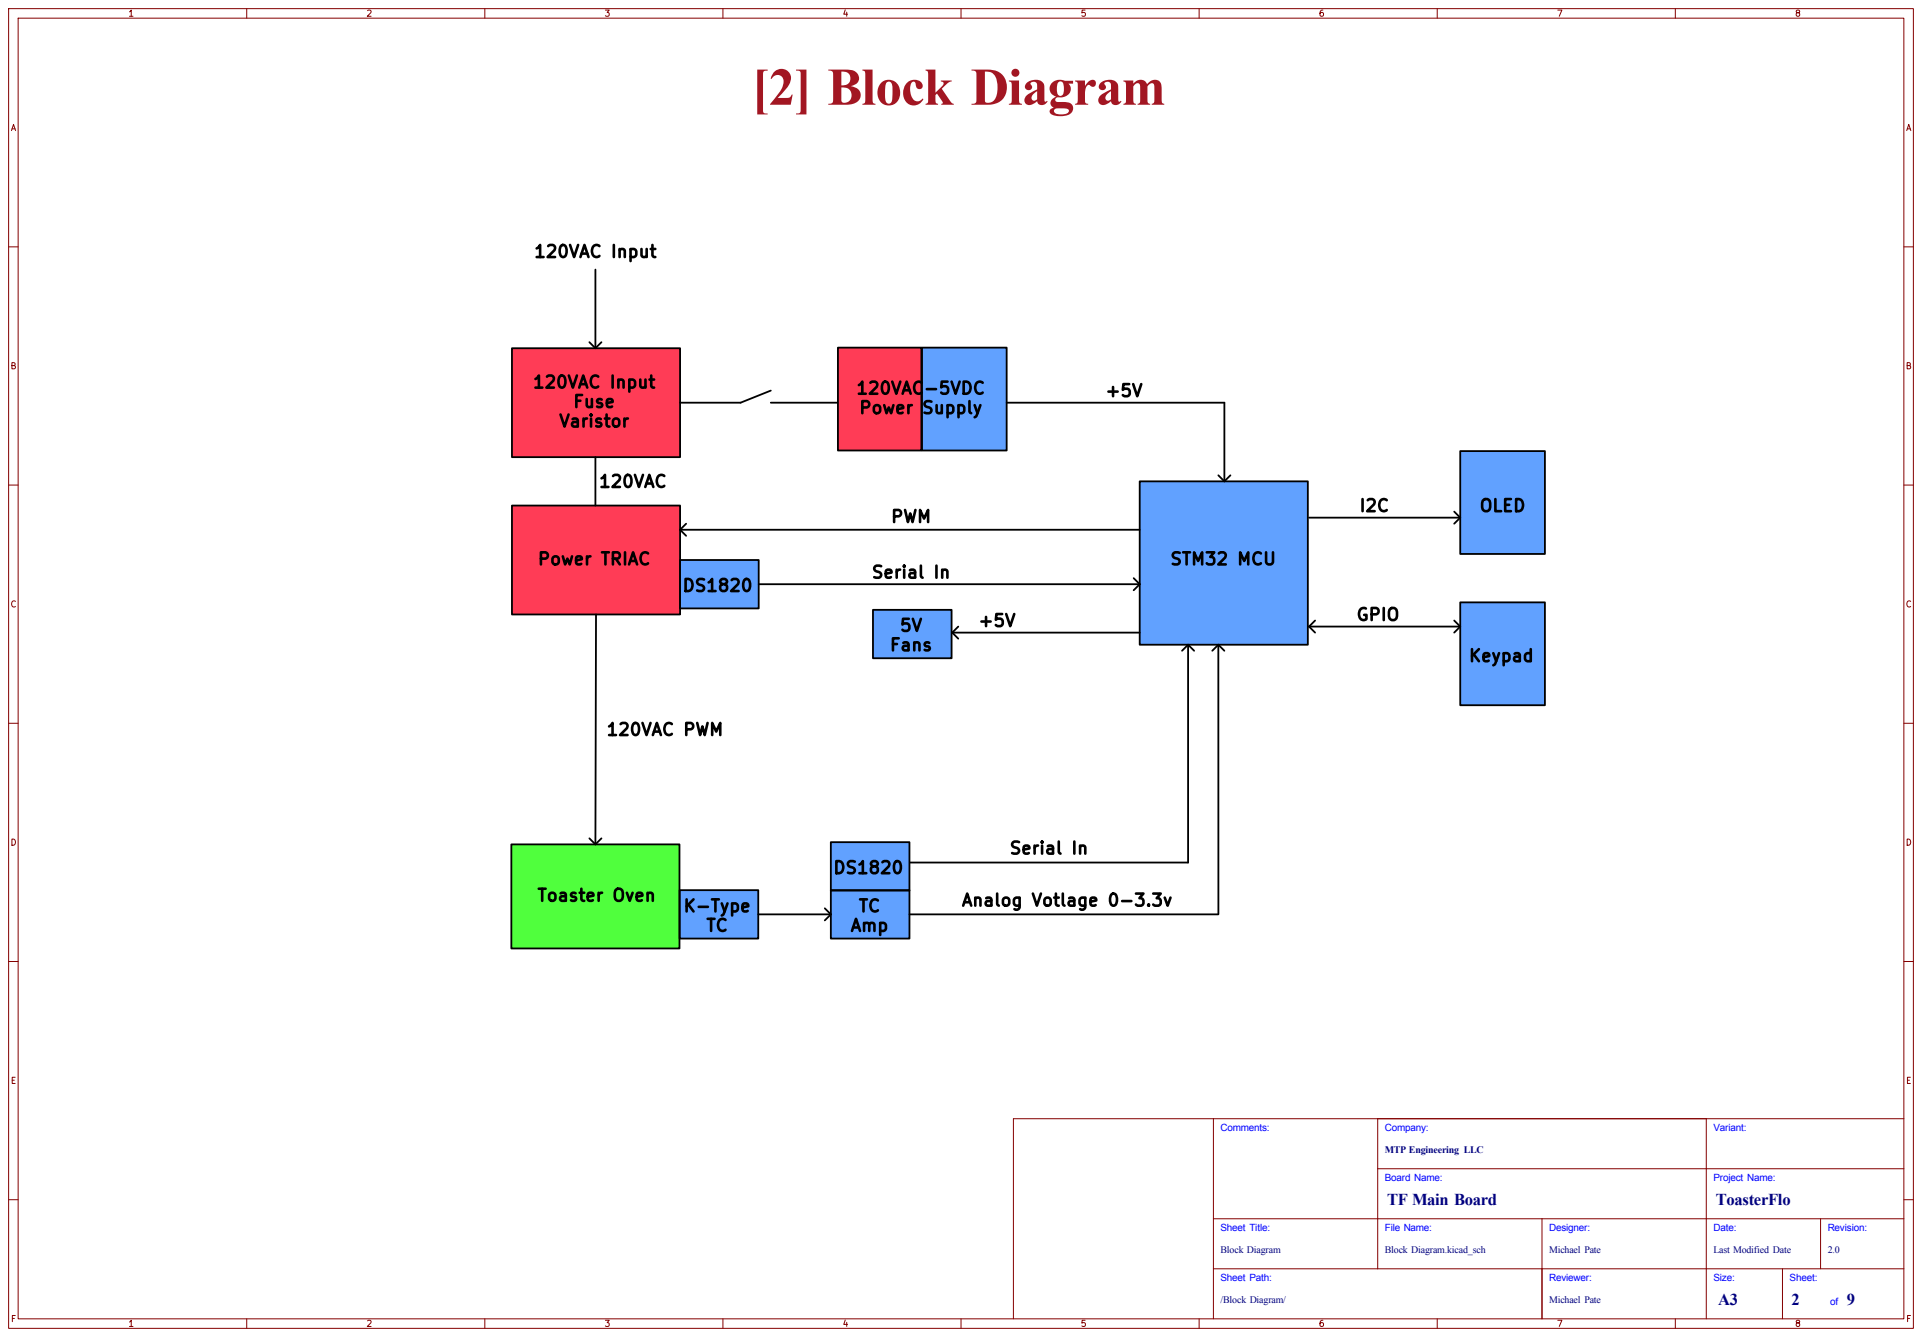
[picture p35: page 2]

/Block Diagram/ Sheet Path: Block Diagram

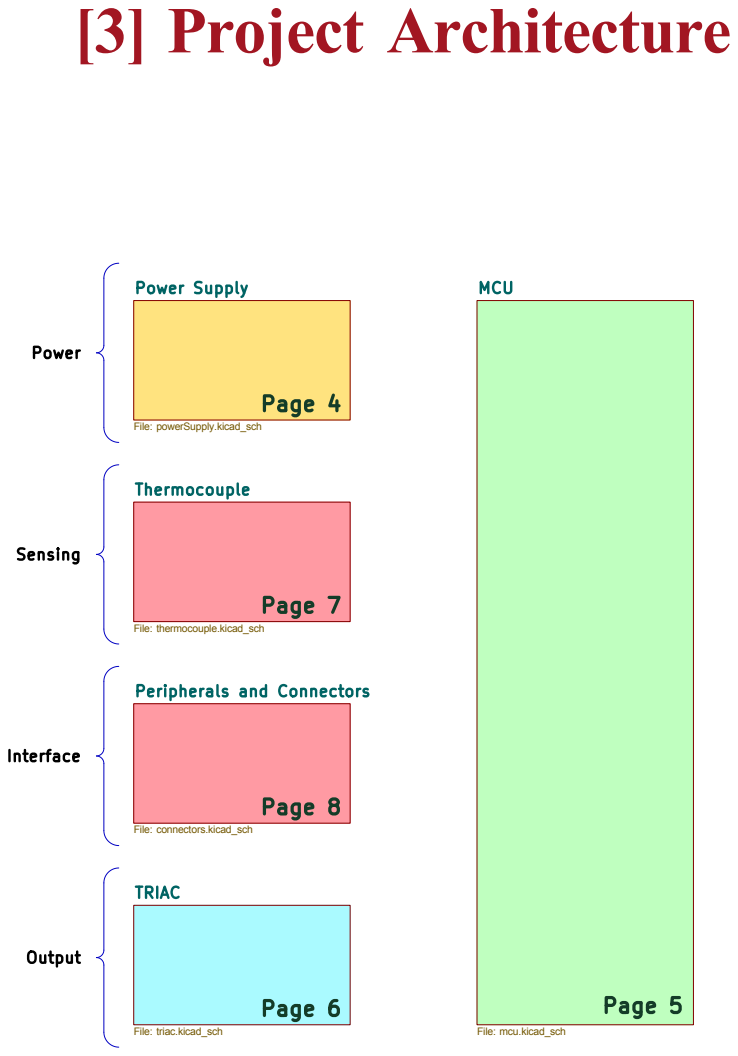
[picture p36: page 3]

/Project Architecture/ Sheet Path: Project Architecture Comments: Peripherals and Connectors

Revision: 2.0 Date: Project Name: Last Modified Date Reviewer: Michael Pate Designer:

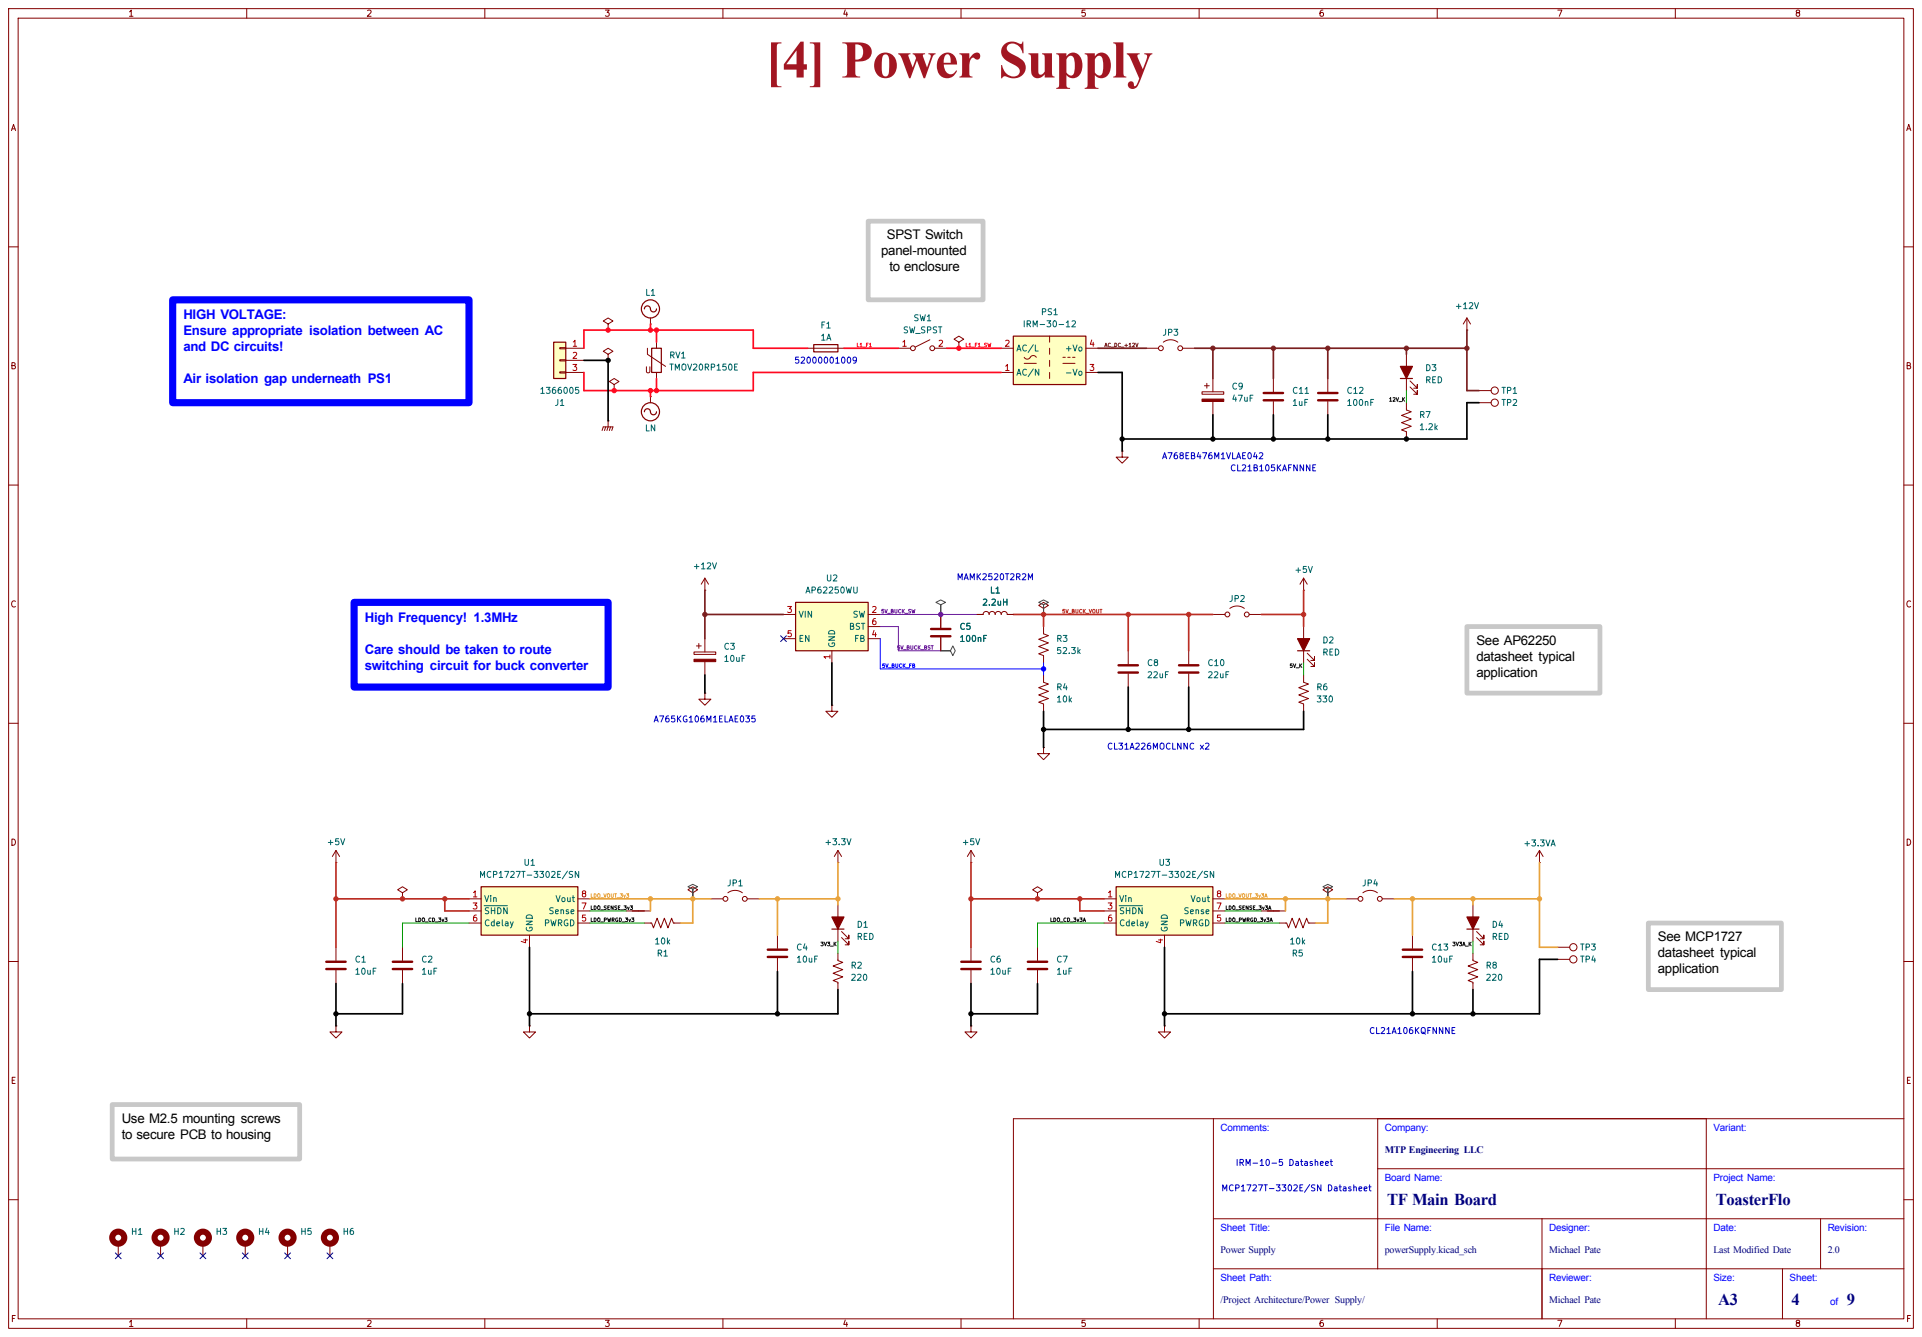
[picture p37: page 4]

HIGH VOLTAGE:
Ensure appropriate isolation between AC
and DC circuits!

Air isolation gap underneath PS1

Care should be taken to route
switching circuit for buck converter

Use M2.5 mounting screws
to secure PCB to housing

IRM-10-5 Datasheet (https://www.meanwellusa.com/upload/pdf/IRM-10/IRM-10-spec.pdf) MCP1727T-3302E/SN Datasheet

Revision: 2.0 Date: Project Name: Last Modified Date Reviewer: Michael Pate Designer:

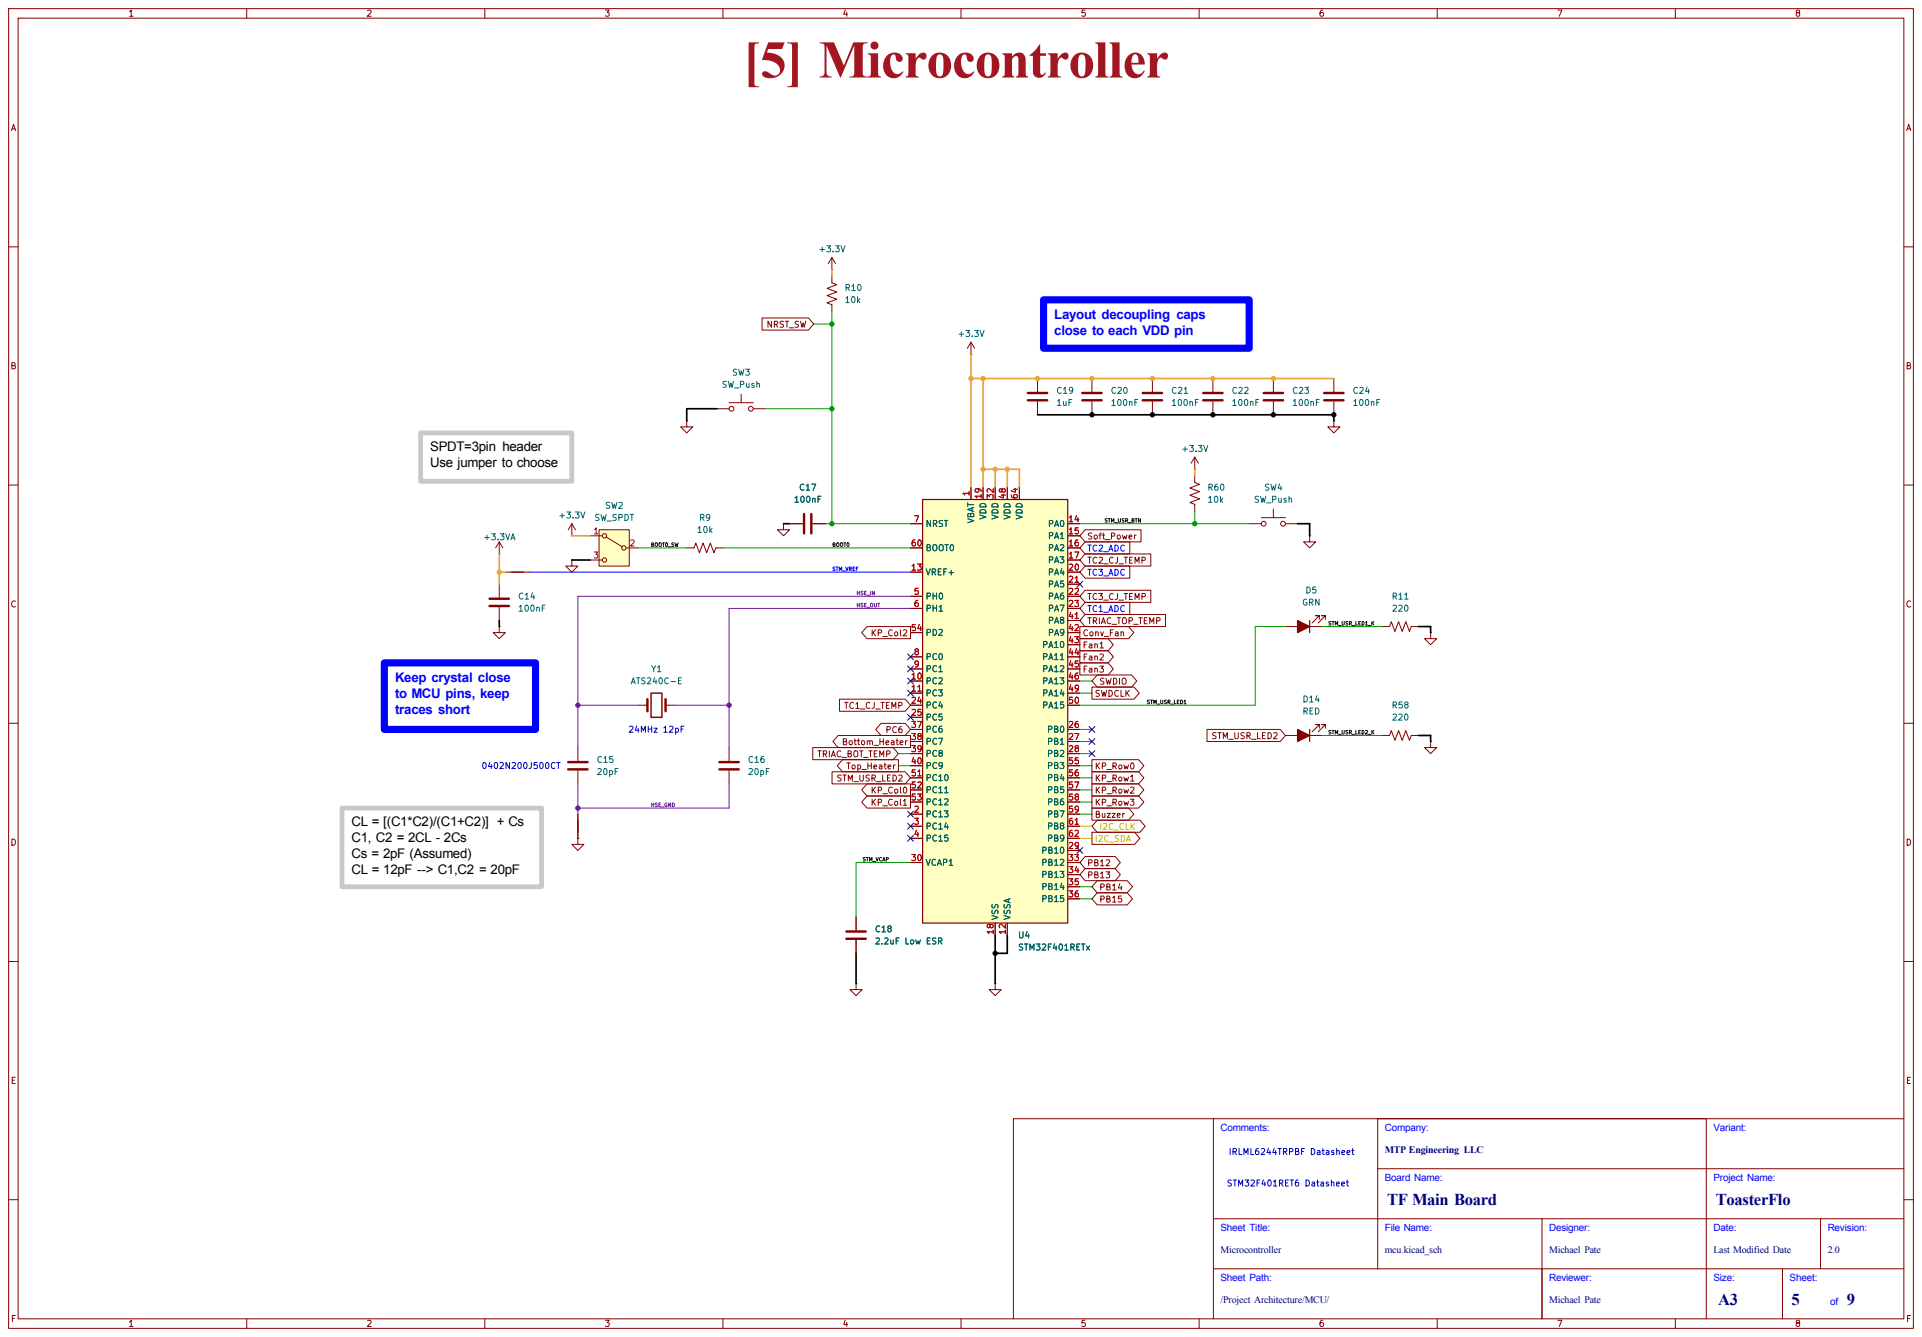
[picture p38: page 5]

Layout decoupling caps
close to each VDD pin

SPDT=3pin header
Use jumper to choose

Keep crystal close
to MCU pins, keep
traces short
STM_USR_LED2_K CL = [(C1*C2)/(C1+C2)] + Cs

/Project Architecture/MCU/ Sheet Path: Microcontroller Comments:

Revision: 2.0 Date: Project Name: Last Modified Date Reviewer: Michael Pate Designer:

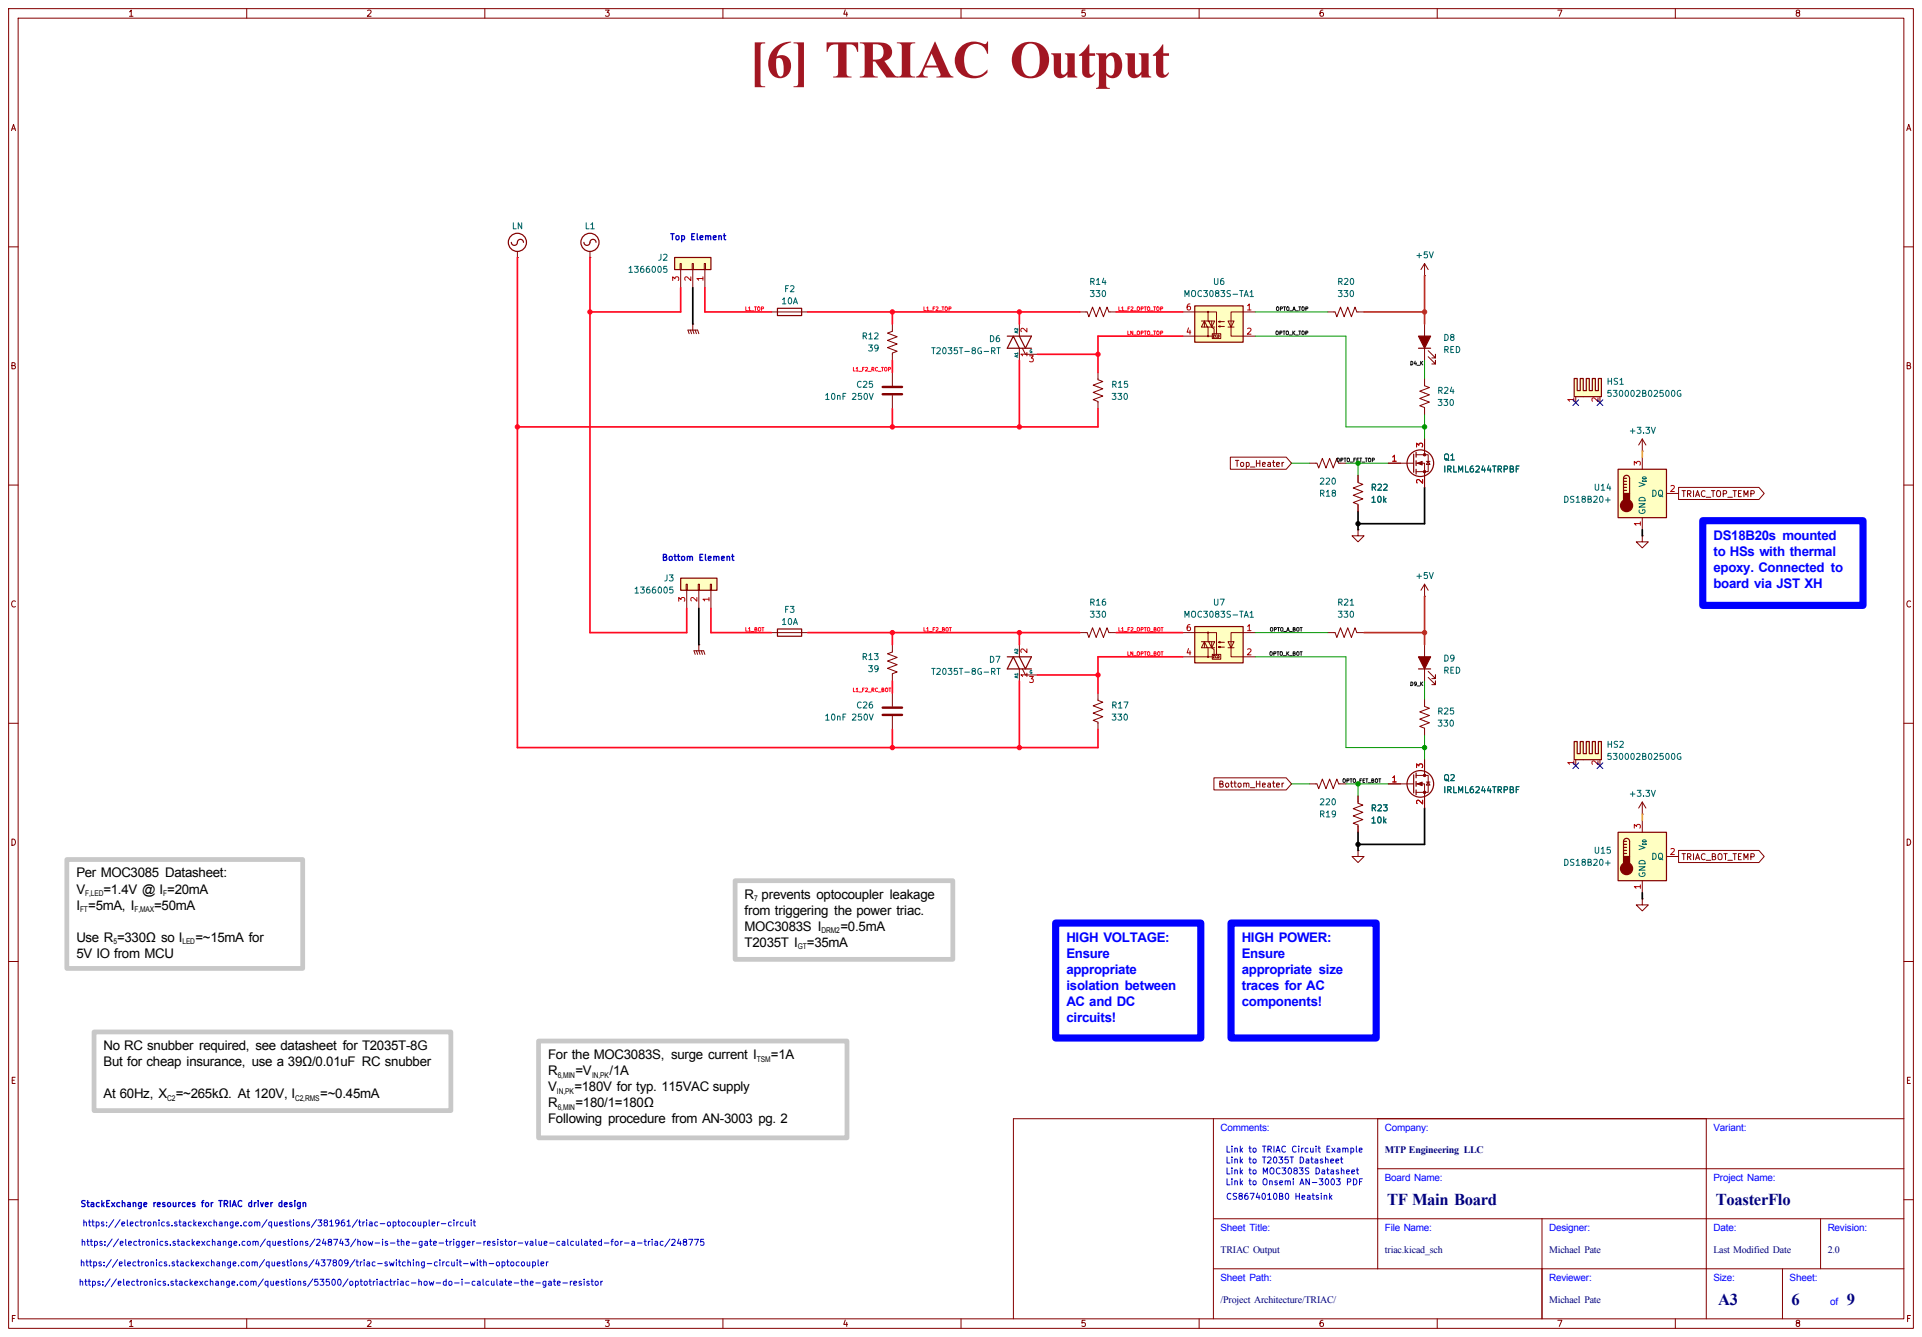
[picture p39: page 6]

DS18B20s mounted
to HSs with thermal
epoxy. Connected to
board via JST XH

R7 prevents optocoupler leakage
from triggering the power triac.
MOC3083S IDRM2=0.5mA
T2035T IGT=35mA

Use R5=330Ω so ILED=~15mA for
5V IO from MCU

No RC snubber required, see datasheet for T2035T-8G
But for cheap insurance, use a 39Ω/0.01uF RC snubber

For the MOC3083S, surge current ITSM=1A
R6,MIN=VIN,PK/1A
VIN,PK=180V for typ. 115VAC supply
R6,MIN=180/1=180Ω
Following procedure from AN-3003 pg. 2

Link to TRIAC Circuit Example (http://www.kerrywong.com/2010/09/11/a-high-current-triac-controller-using-arduino/)
Link to T2035T Datasheet (https://www.st.com/resource/en/datasheet/t2035t-8g.pdf)
Link to MOC3083S Datasheet (https://www.mouser.com/datasheet/2/239/lite_s_a0002782333_1-2272340.pdf)
Link to Onsemi AN-3003 PDF (https://www.onsemi.jp/pub/Collateral/AN-3003.pdf) CS8674010B0 Heatsink

Revision: 2.0 Date: Project Name: Last Modified Date Reviewer: Michael Pate Designer:

StackExchange resources for TRIAC driver design

https://electronics.stackexchange.com/questions/381961/triac-optocoupler-circuit

https://electronics.stackexchange.com/questions/248743/how-is-the-gate-trigger-resistor-value-calculated-for-a-triac/248775

https://electronics.stackexchange.com/questions/437809/triac-switching-circuit-with-optocoupler

https://electronics.stackexchange.com/questions/53500/optotriactriac-how-do-i-calculate-the-gate-resistor

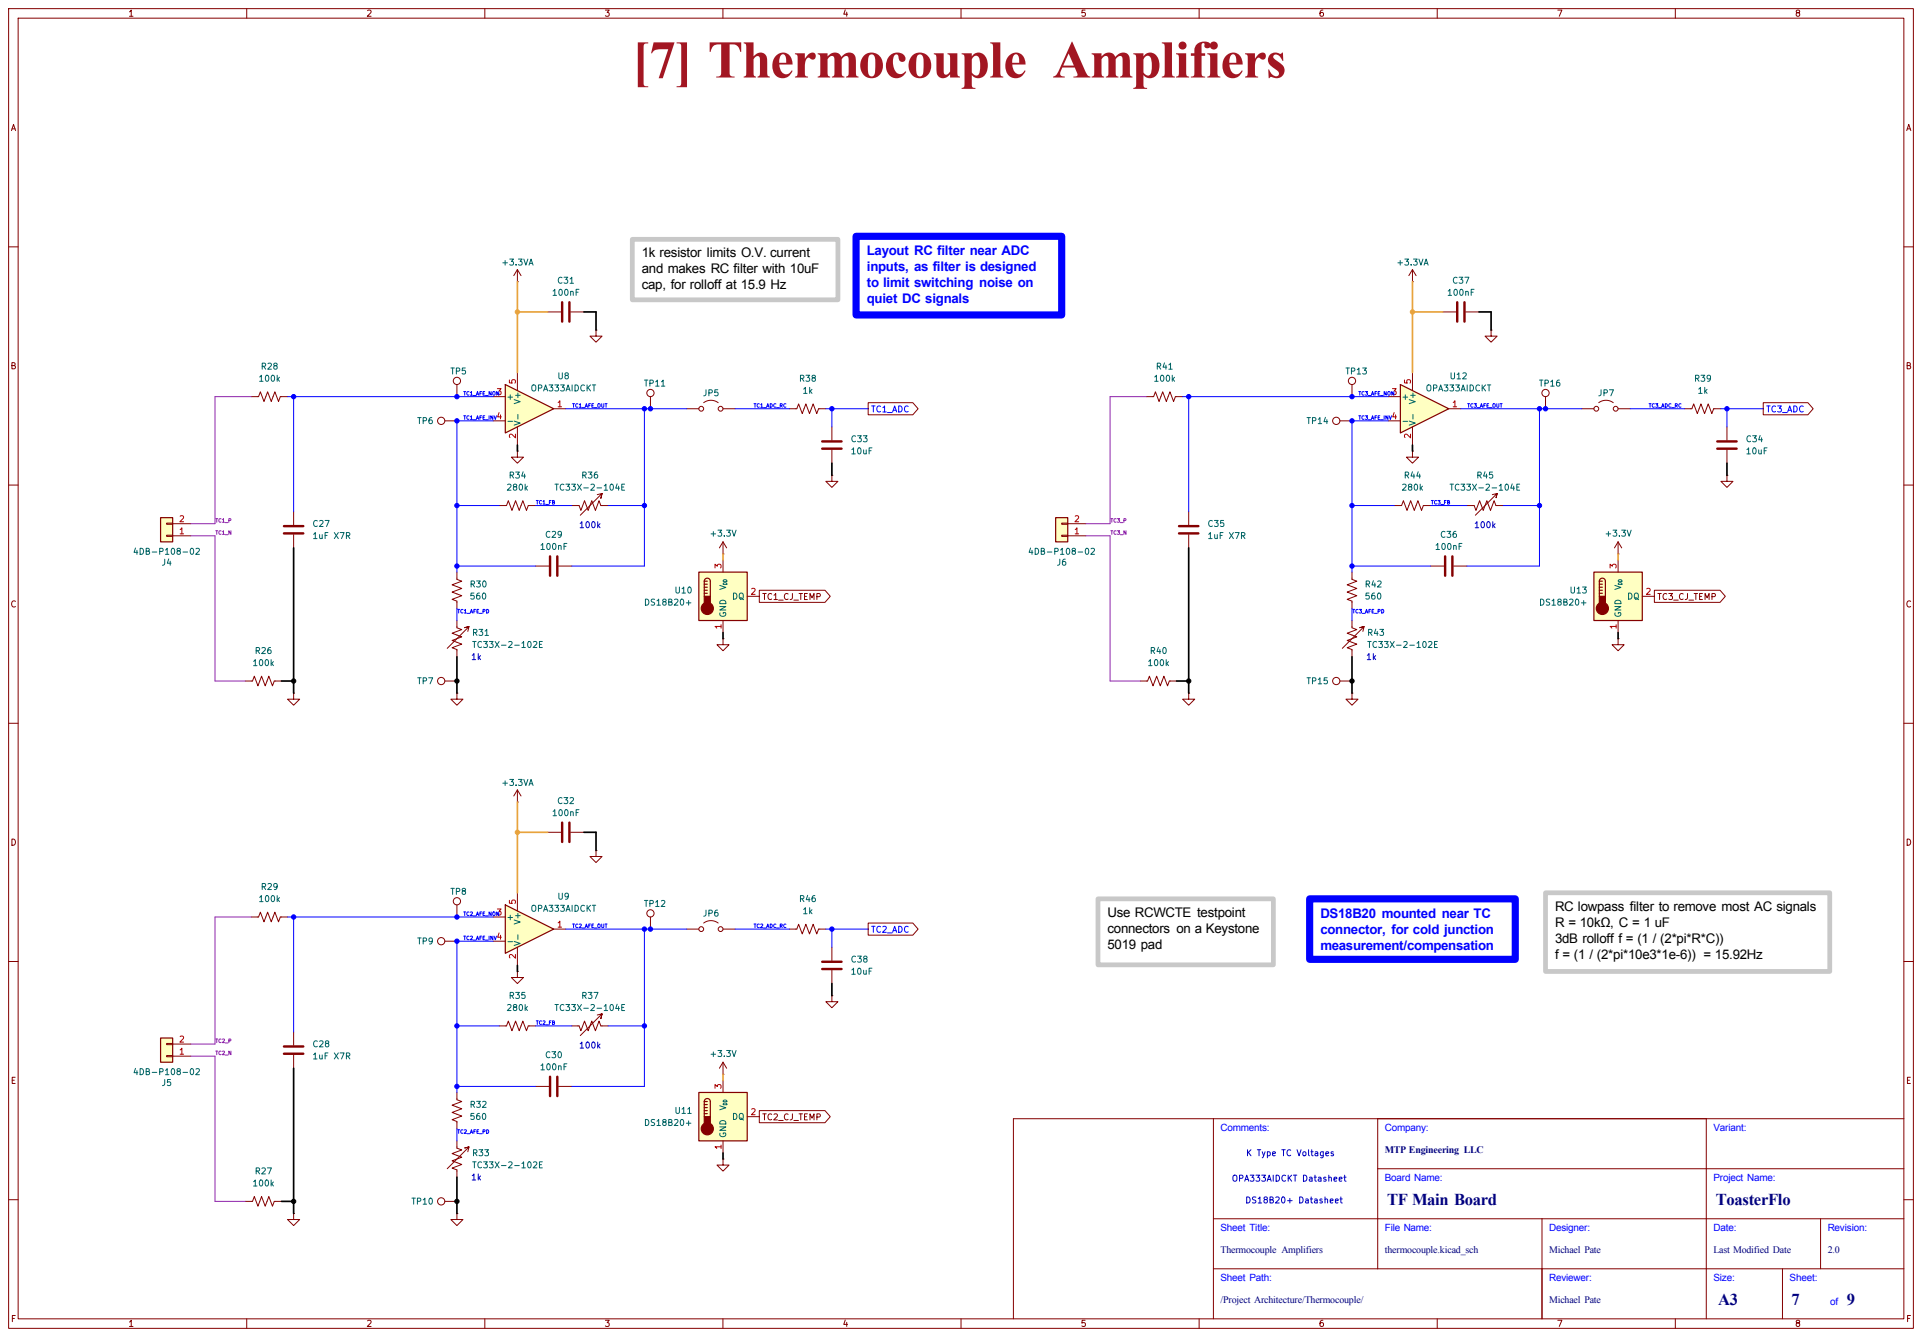
[picture p40: page 7]

1k resistor limits O.V. current
and makes RC filter with 10uF
cap, for rolloff at 15.9 Hz

Layout RC filter near ADC
inputs, as filter is designed
to limit switching noise on
quiet DC signals

/Project Architecture/Thermocouple/ Sheet Path: Thermocouple Amplifiers Comments: +3.3VA

DS18B20 mounted near TC
connector, for cold junction
measurement/compensation

Revision: 2.0 Date: Project Name: Last Modified Date Reviewer: Michael Pate Designer:

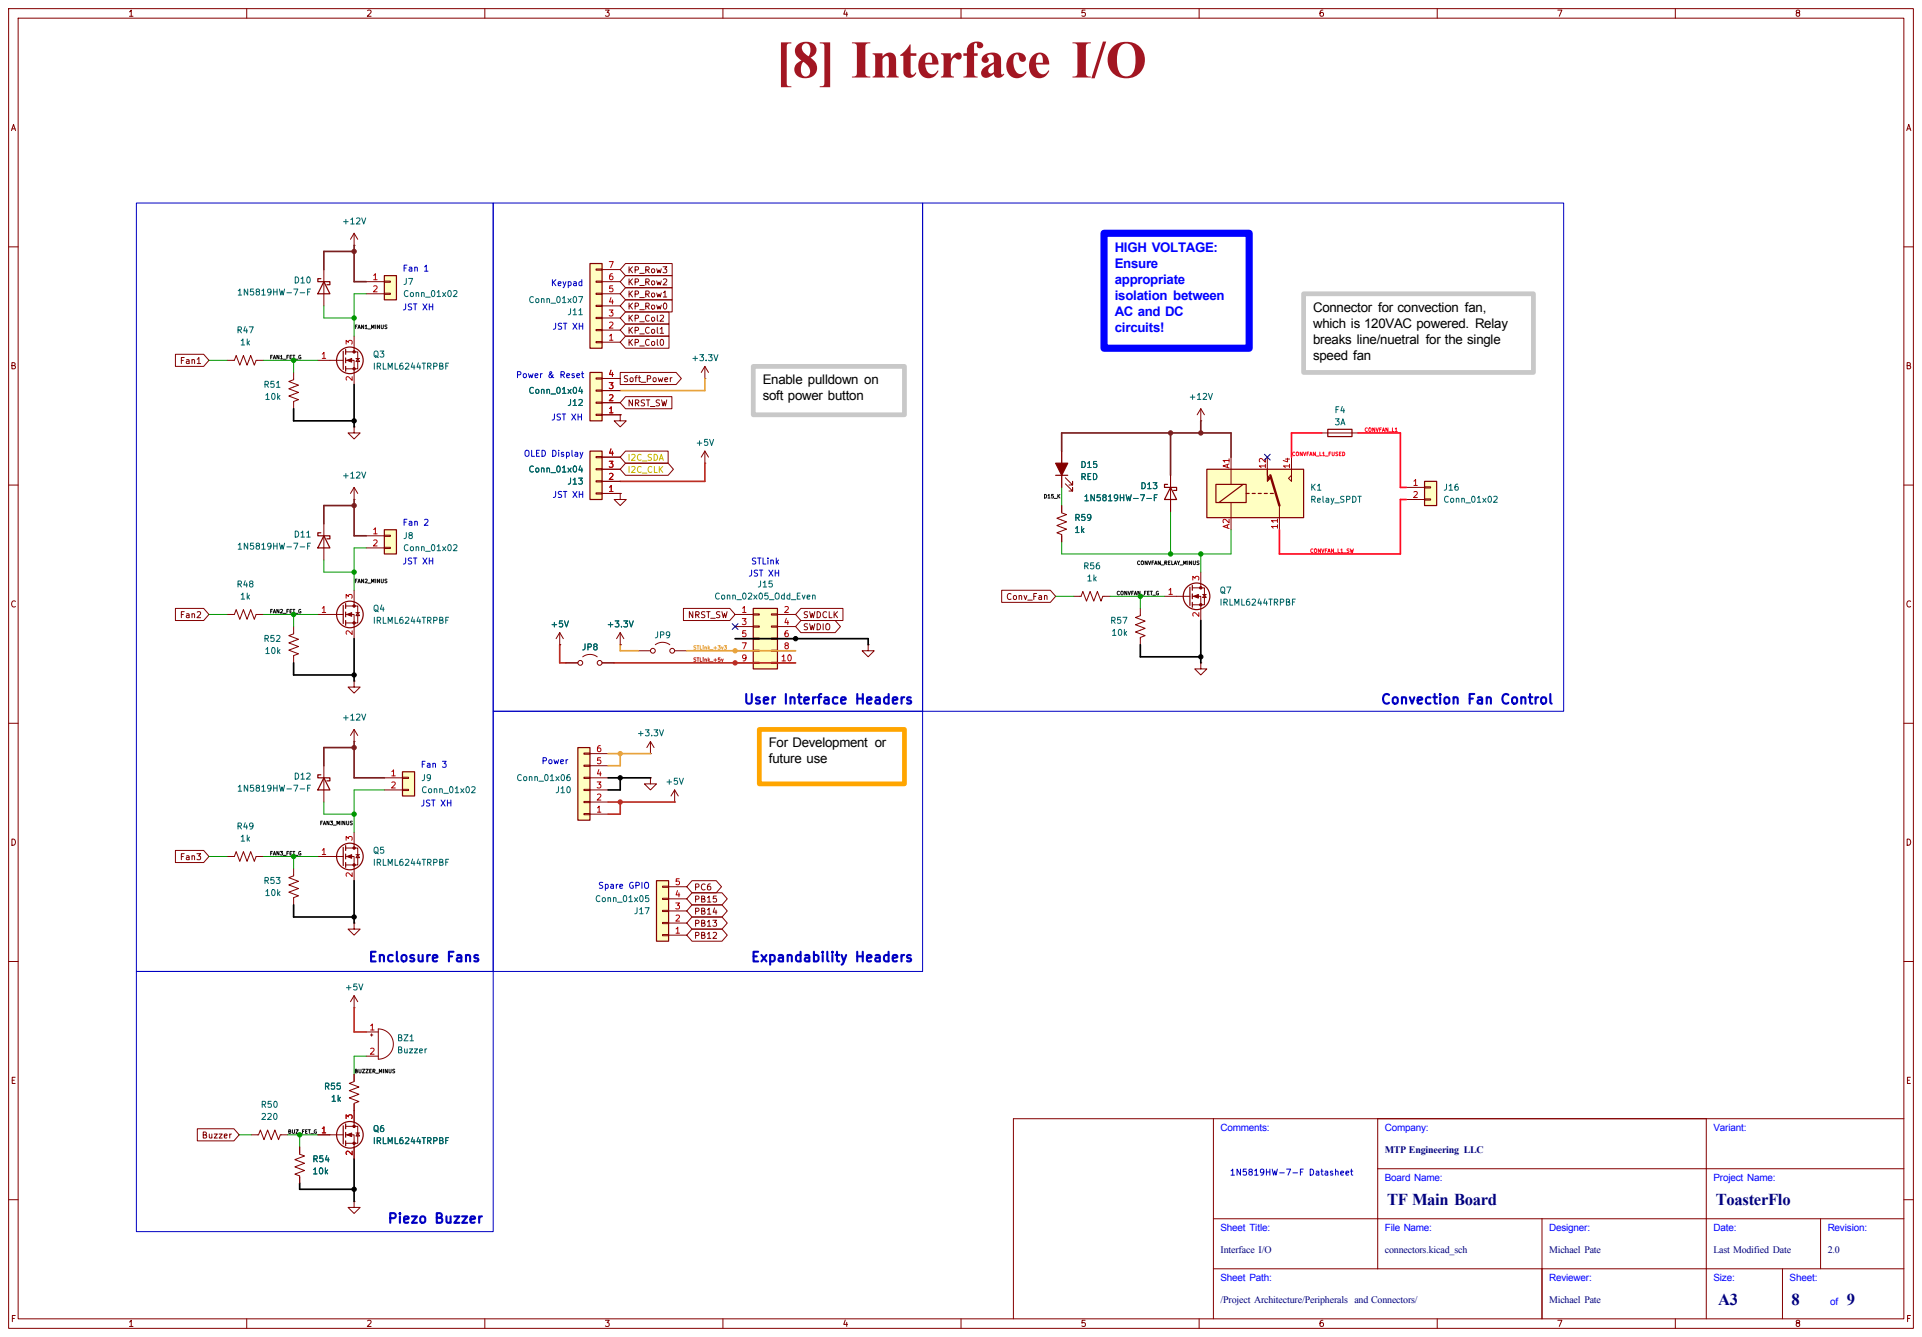
[picture p41: page 8]

Connector for convection fan,
which is 120VAC powered. Relay
breaks line/nuetral for the single
speed fan

Revision: 2.0 Date: Project Name: Last Modified Date Reviewer: Michael Pate Designer:

/Project Architecture/Peripherals and Connectors/ Sheet Path: Interface I/O

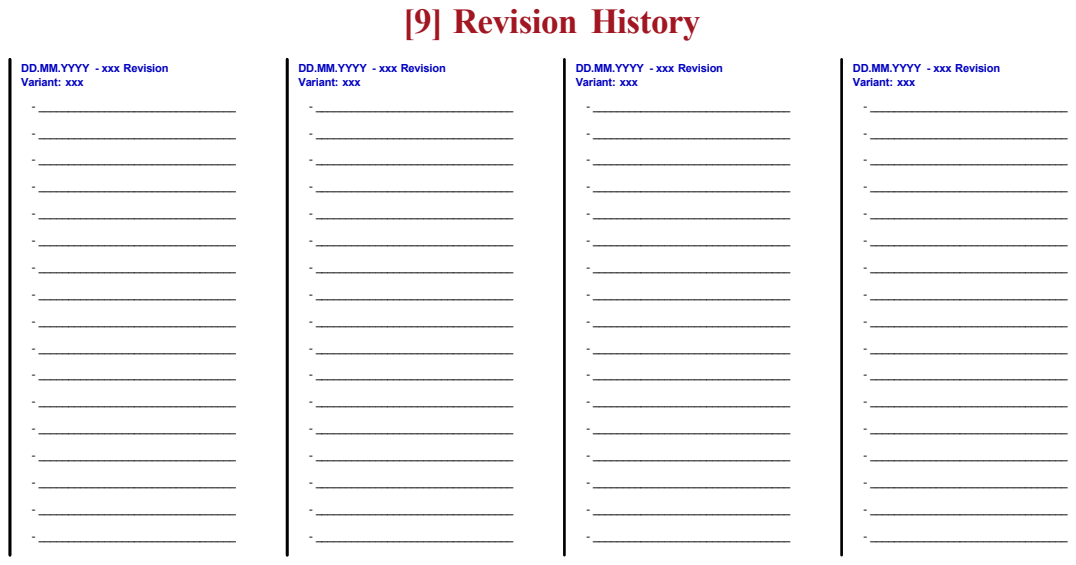
[picture p42: page 9]

- _________________________________ DD.MM.YYYY - xxx Revision

Variant: xxx DD.MM.YYYY - xxx Revision

/Revision History/ Sheet Path: Revision History Comments:
