MichaelPate/ToasterFlo/mainBoard/mainBoard.kicad_pcb

## KiCad design mainBoard/mainBoard.kicad_pcb (2026-08-24)

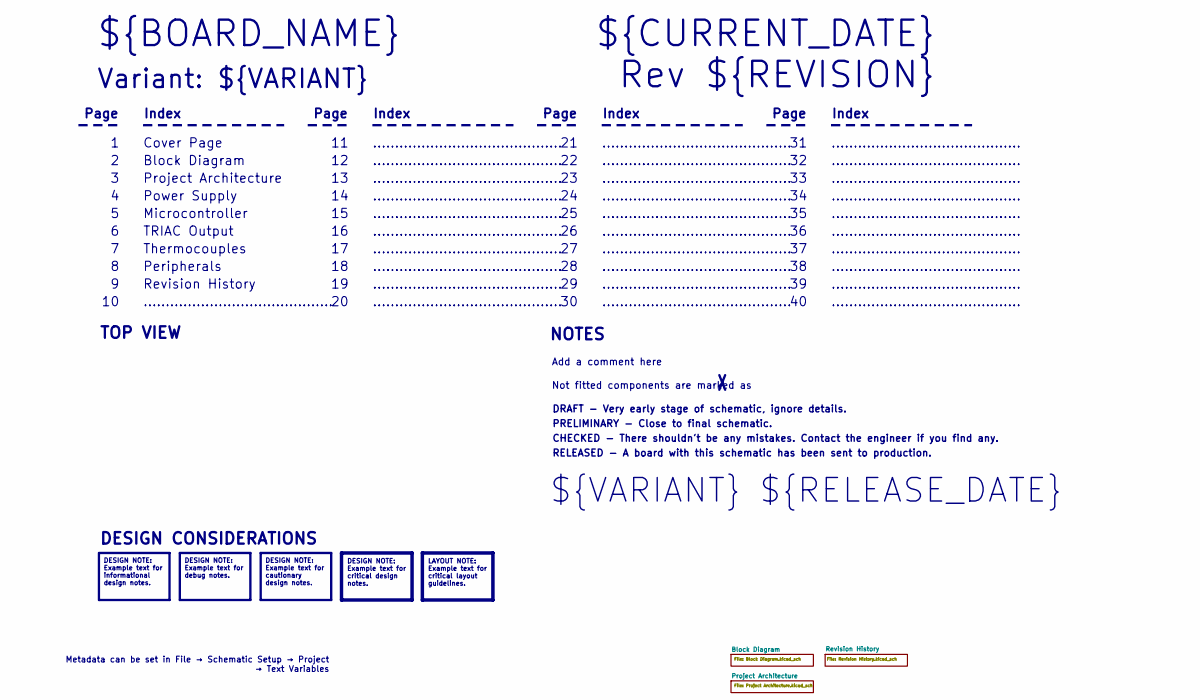
[picture p43: schematic mainBoard.kicad_sch, Cover Page]

Notes on the sheet:
...........................................
RELEASED - A board with this schematic has been sent to production.
Page
TOP VIEW
Revision History
Peripherals
Not fitted components are marked as
Index
PRELIMINARY - Close to final schematic.
${VARIANT} ${RELEASE_DATE}
Power Supply
${CURRENT_DATE}
Variant: ${VARIANT}
Rev ${REVISION}
Microcontroller
${BOARD_NAME}
DRAFT - Very early stage of schematic, ignore details.
TRIAC Output
Block Diagram
Add a comment here
Cover Page
NOTES
Project Architecture
CHECKED - There shouldn't be any mistakes. Contact the engineer if you find any.
DESIGN CONSIDERATIONS
Thermocouples
Metadata can be set in File → Schematic Setup → Project → Text Variables
DESIGN NOTE: Example text for informational design notes.
LAYOUT NOTE: Example text for critical layout guidelines.
DESIGN NOTE: Example text for cautionary design notes.
DESIGN NOTE: Example text for debug notes.
DESIGN NOTE: Example text for critical design notes.

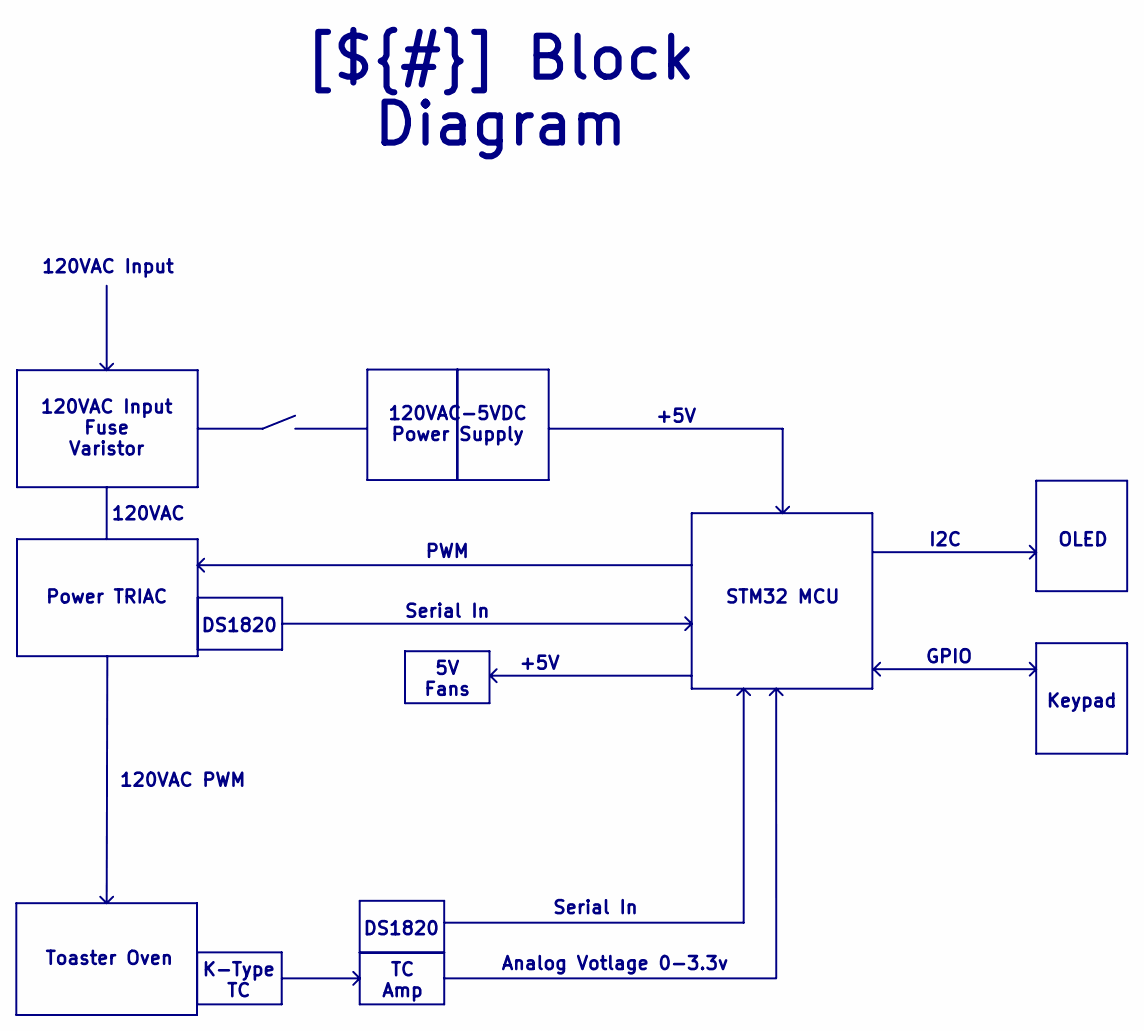
[picture p44: schematic Block Diagram.kicad_sch]

Notes on the sheet:
5V Fans
OLED
+5V
Serial In
GPIO
120VAC Input
TC Amp
K-Type TC
Toaster Oven
120VAC-5VDC Power Supply
120VAC Input Fuse Varistor
DS1820
Analog Votlage 0-3.3v
I2C
Power TRIAC
STM32 MCU
PWM
Keypad
120VAC PWM
120VAC
[${#}] ${TITLE}


Notes on the sheet:
- _________________________________ - _________________________________ - _________________________________ - _________________________________ - _________________________________ - _________________________________ - _________________________________ - _________________________________ - _________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
DD.MM.YYYY - xxx Revision Variant: xxx
[${#}] ${TITLE}

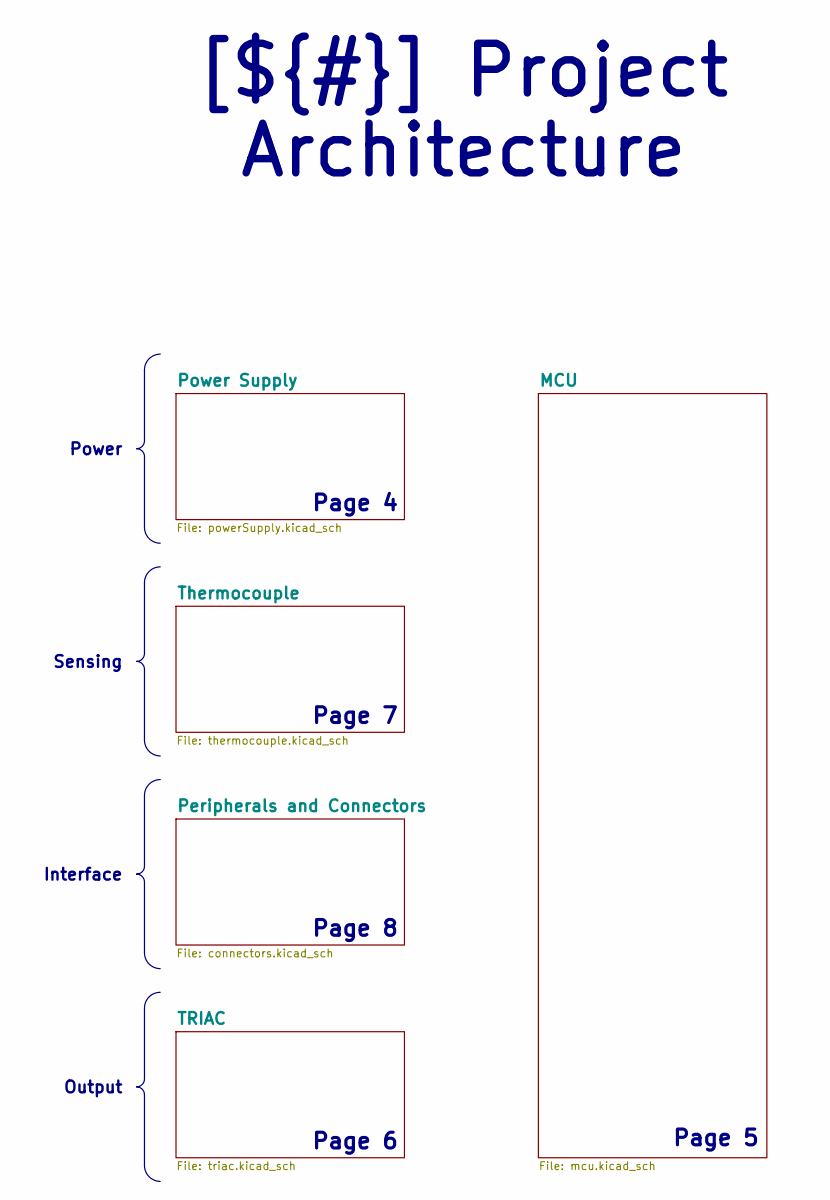
[picture p46: schematic Project Architecture.kicad_sch]

Notes on the sheet:
Page 7
Page 8
Page 6
Page 5
Page 4
Power
Sensing
[${#}] ${TITLE}
Interface
Output

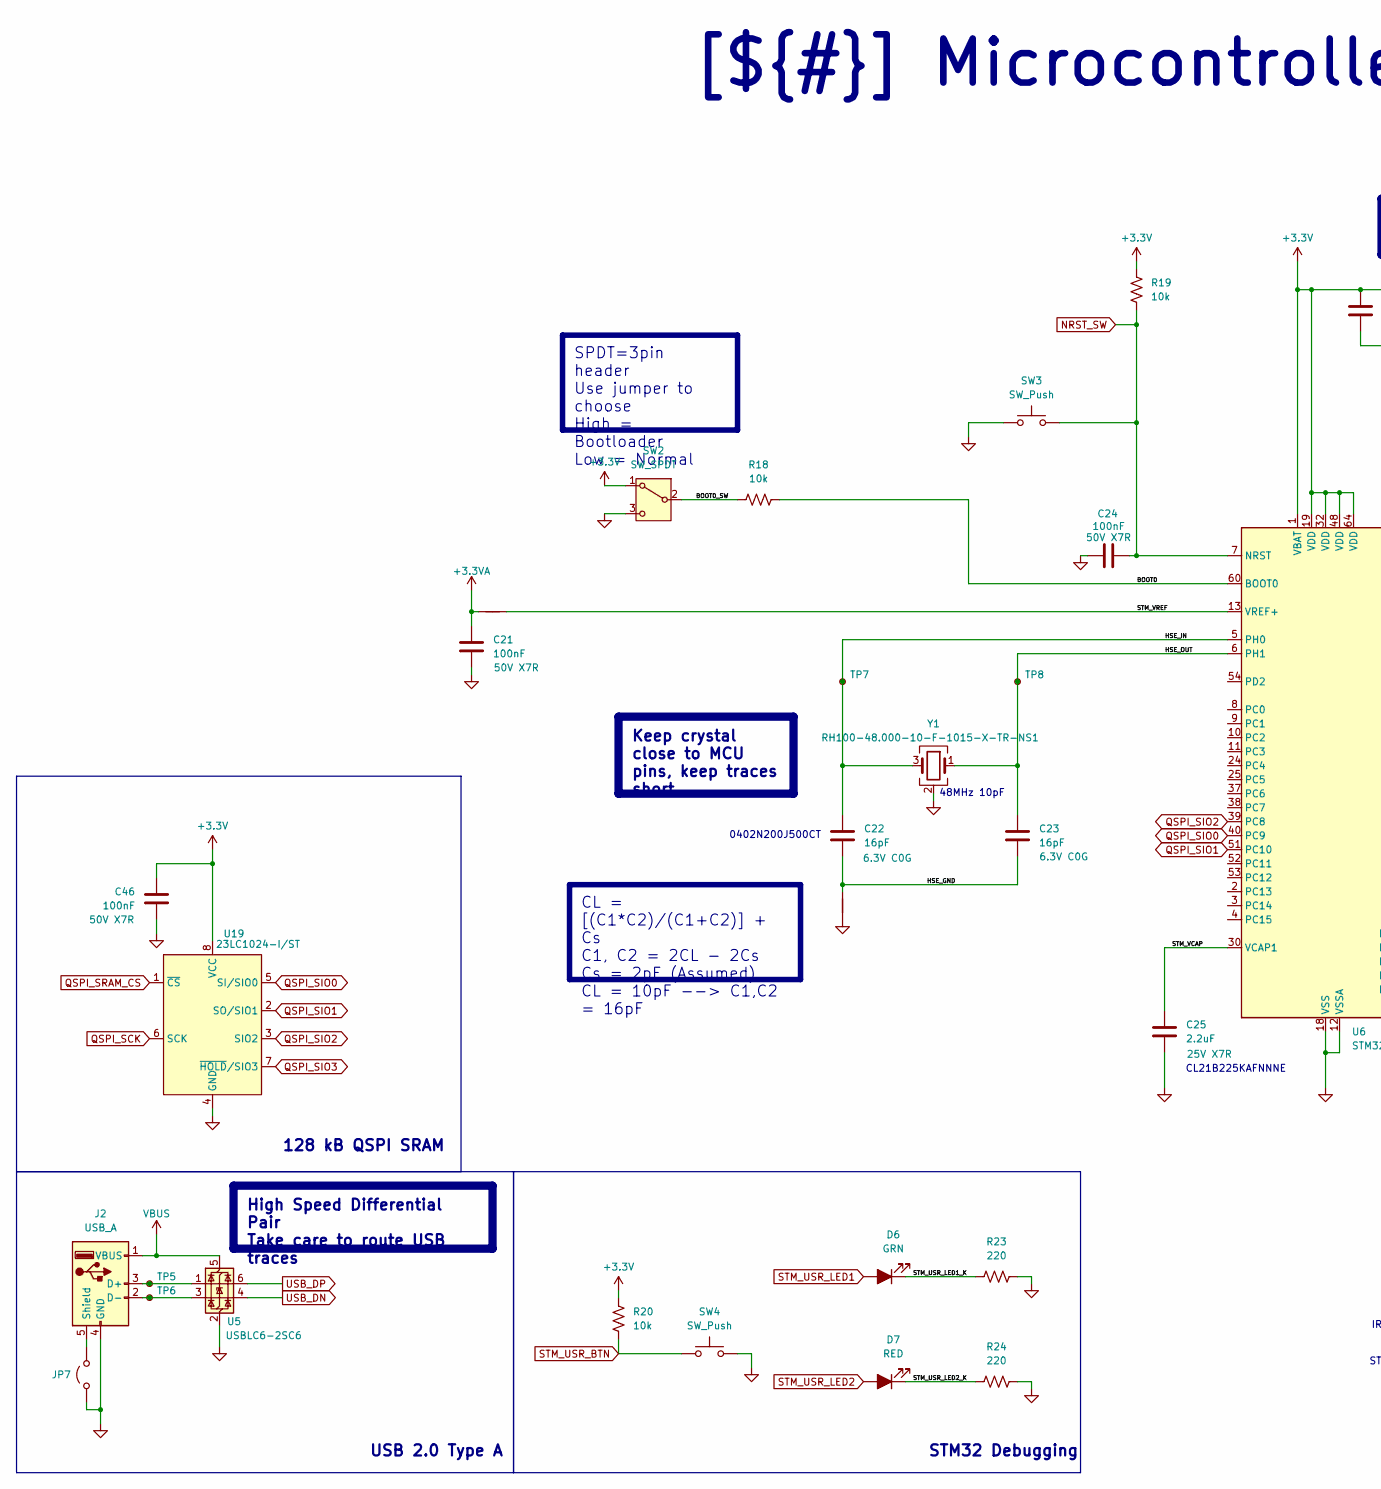
[picture p47: schematic mcu.kicad_sch, Microcontroller, part in row 1, column 1]

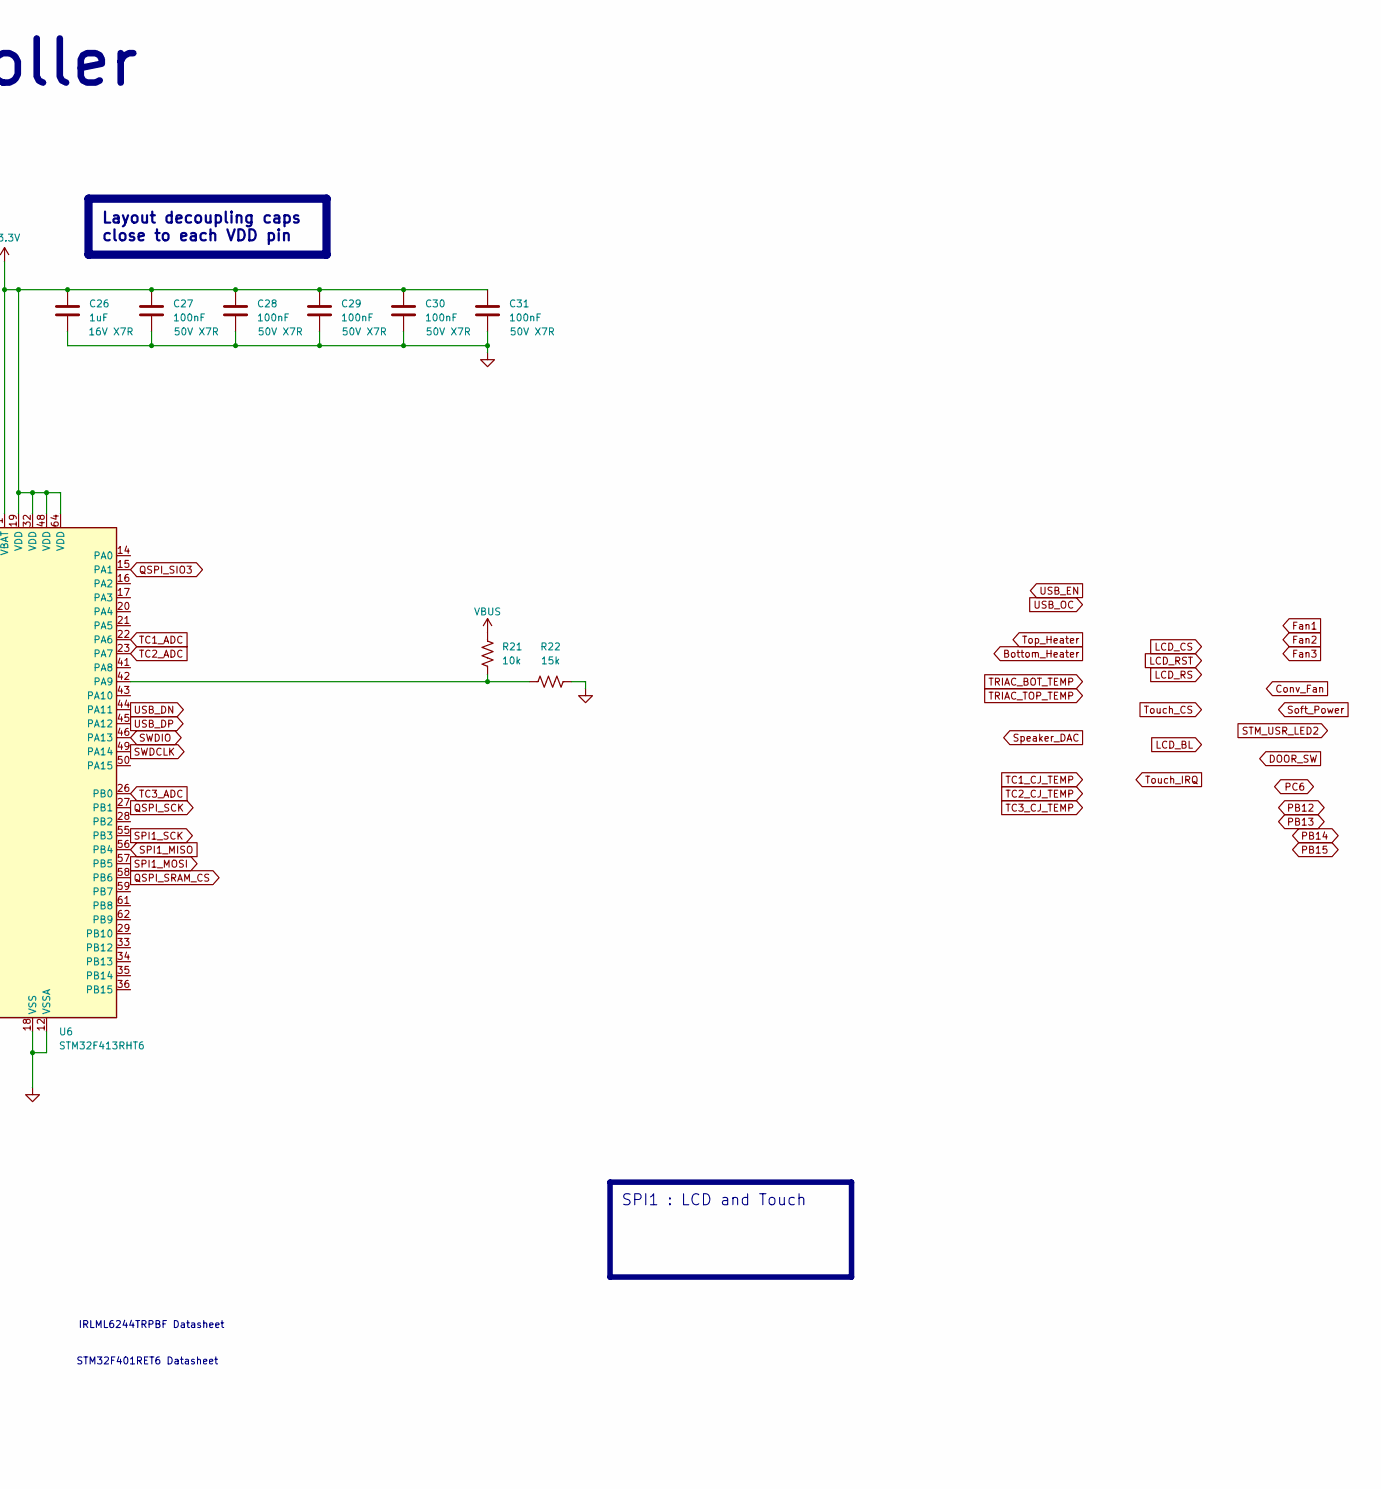
[picture p48: schematic mcu.kicad_sch, Microcontroller, part in row 1, column 2]

Parts:
C21, C24, C27, C28, C29, C30, C31, C46: 100nF; C_0603_1608Metric_Pad1.08x0.95mm_HandSolder
C22, C23: 16pF; C_0402_1005Metric_Pad0.74x0.62mm_HandSolder; part number 0402N200J500CT
C25: 2.2uF; C_0805_2012Metric_Pad1.18x1.45mm_HandSolder; part number CL21B225KAFNNNE
C26: 1uF; C_0805_2012Metric_Pad1.18x1.45mm_HandSolder
D6: GRN; LED_0603_1608Metric_Pad1.05x0.95mm_HandSolder
D7: RED; LED_0603_1608Metric_Pad1.05x0.95mm_HandSolder
J2: USB_A; USB_A_Connfly_DS1095
JP7: Jumper_2_Open; SolderJumper-2_P1.3mm_Open_TrianglePad1.0x1.5mm
NT1, NT2: NetTie_2; NetTie-2_SMD_Pad0.5mm
R18, R19, R20, R21: 10k; R_0603_1608Metric_Pad0.98x0.95mm_HandSolder
R22: 15k; R_0603_1608Metric_Pad0.98x0.95mm_HandSolder
R23, R24: 220; R_0603_1608Metric_Pad0.98x0.95mm_HandSolder
SW2: SW_SPDT; PinHeader_1x03_P2.54mm_Vertical
SW3, SW4: SW_Push; SW_PUSH_6mm_H8.5mm
TP5, TP6, TP7, TP8: TestPoint_Small; TestPoint_Pad_D1.0mm
U5: USBLC6-2SC6; SOT-23-6
U6: STM32F413RHT6; LQFP-64_10x10mm_P0.5mm
U19: 23LC1024-I/ST; TSSOP-8_4.4x3mm_P0.65mm
Y1: RH100-48.000-10-F-1015-X-TR-NS1; Crystal_SMD_3225-4Pin_3.2x2.5mm

Connections:
+3.3V: C26.1, C27.1, C28.1, C29.1, C30.1, C31.1, C46.1, R19.1, R20.1, SW2.1 (A), U6.1 (VBAT), U6.19 (VDD), U6.32 (VDD), U6.48 (VDD), U6.64 (VDD), U19.8 (VCC); also elsewhere on the board
+3.3VA: C21.1, NT1.2; also elsewhere on the board
/Project Architecture/MCU/BOOT0: R18.2, U6.60 (BOOT0)
/Project Architecture/MCU/BOOT0_SW: R18.1, SW2.2 (B)
/Project Architecture/MCU/HSE_GND: C22.2, C23.2, NT2.2
/Project Architecture/MCU/HSE_IN: C22.1, TP7.1 (1_1), U6.5 (PH0), Y1.3
/Project Architecture/MCU/HSE_OUT: C23.1, TP8.1 (1_1), U6.6 (PH1), Y1.1
/Project Architecture/MCU/STM_USR_LED1_K: D6.1 (K), R23.1
/Project Architecture/MCU/STM_USR_LED2_K: D7.1 (K), R24.1
/Project Architecture/MCU/STM_VCAP: C25.1, U6.30 (VCAP1)
/Project Architecture/MCU/STM_VREF: NT1.1, U6.13 (VREF+)
GND: C21.2, C24.1, C25.2, C26.2, C27.2, C28.2, C29.2, C30.2, C31.2, C46.2, J2.4 (GND), JP7.1 (A), NT2.1, R22.2, R23.2, R24.2, SW2.3 (C), SW3.1, SW4.2, U5.2 (GND), U6.12 (VSSA), U6.18 (VSS), U6.31 (VSS), U6.47 (VSS), U6.63 (VSS), U19.4 (GND), Y1.2 (G), Y1.4 (G); also elsewhere on the board
NRST_SW: C24.2, R19.2, SW3.2, U6.7 (NRST); also elsewhere on the board
unnamed: J2.5 (Shield), JP7.2 (B)
unnamed: R21.1, R22.1, U6.42 (PA9)
QSPI_SCK: U6.27 (PB1), U19.6 (SCK)
QSPI_SIO0: U6.40 (PC9), U19.5 (SI/SIO0)
QSPI_SIO1: U6.51 (PC10), U19.2 (SO/SIO1)
QSPI_SIO2: U6.39 (PC8), U19.3 (SIO2)
QSPI_SIO3: U6.15 (PA1), U19.7 (~HOLD/SIO3)
QSPI_SRAM_CS: U6.58 (PB6), U19.1 (~CS)
SPI1_MISO: U6.56 (PB4); also elsewhere on the board
SPI1_MOSI: U6.57 (PB5); also elsewhere on the board
SPI1_SCK: U6.55 (PB3); also elsewhere on the board
STM_USR_BTN: R20.2, SW4.1
STM_USR_LED1: D6.2 (A)
STM_USR_LED2: D7.2 (A)
SWDCLK: U6.49 (PA14); also elsewhere on the board
SWDIO: U6.46 (PA13); also elsewhere on the board
TC1_ADC: U6.22 (PA6); also elsewhere on the board
TC2_ADC: U6.23 (PA7); also elsewhere on the board
TC3_ADC: U6.26 (PB0); also elsewhere on the board
VBUS: J2.1 (VBUS), R21.2, U5.5 (VBUS); also elsewhere on the board

Notes on the sheet:
STM32 Debugging
CL21B225KAFNNNE
USB 2.0 Type A
STM32F401RET6 Datasheet
0402N200J500CT
128 kB QSPI SRAM
48MHz 10pF
IRLML6244TRPBF Datasheet
High Speed Differential Pair Take care to route USB traces
Layout decoupling caps close to each VDD pin
Keep crystal close to MCU pins, keep traces short
SPI1 : LCD and Touch
CL = [(C1*C2)/(C1+C2)] + Cs C1, C2 = 2CL - 2Cs Cs = 2pF (Assumed) CL = 10pF --> C1,C2 = 16pF
[${#}] ${TITLE}
SPDT=3pin header Use jumper to choose High = Bootloader Low = Normal

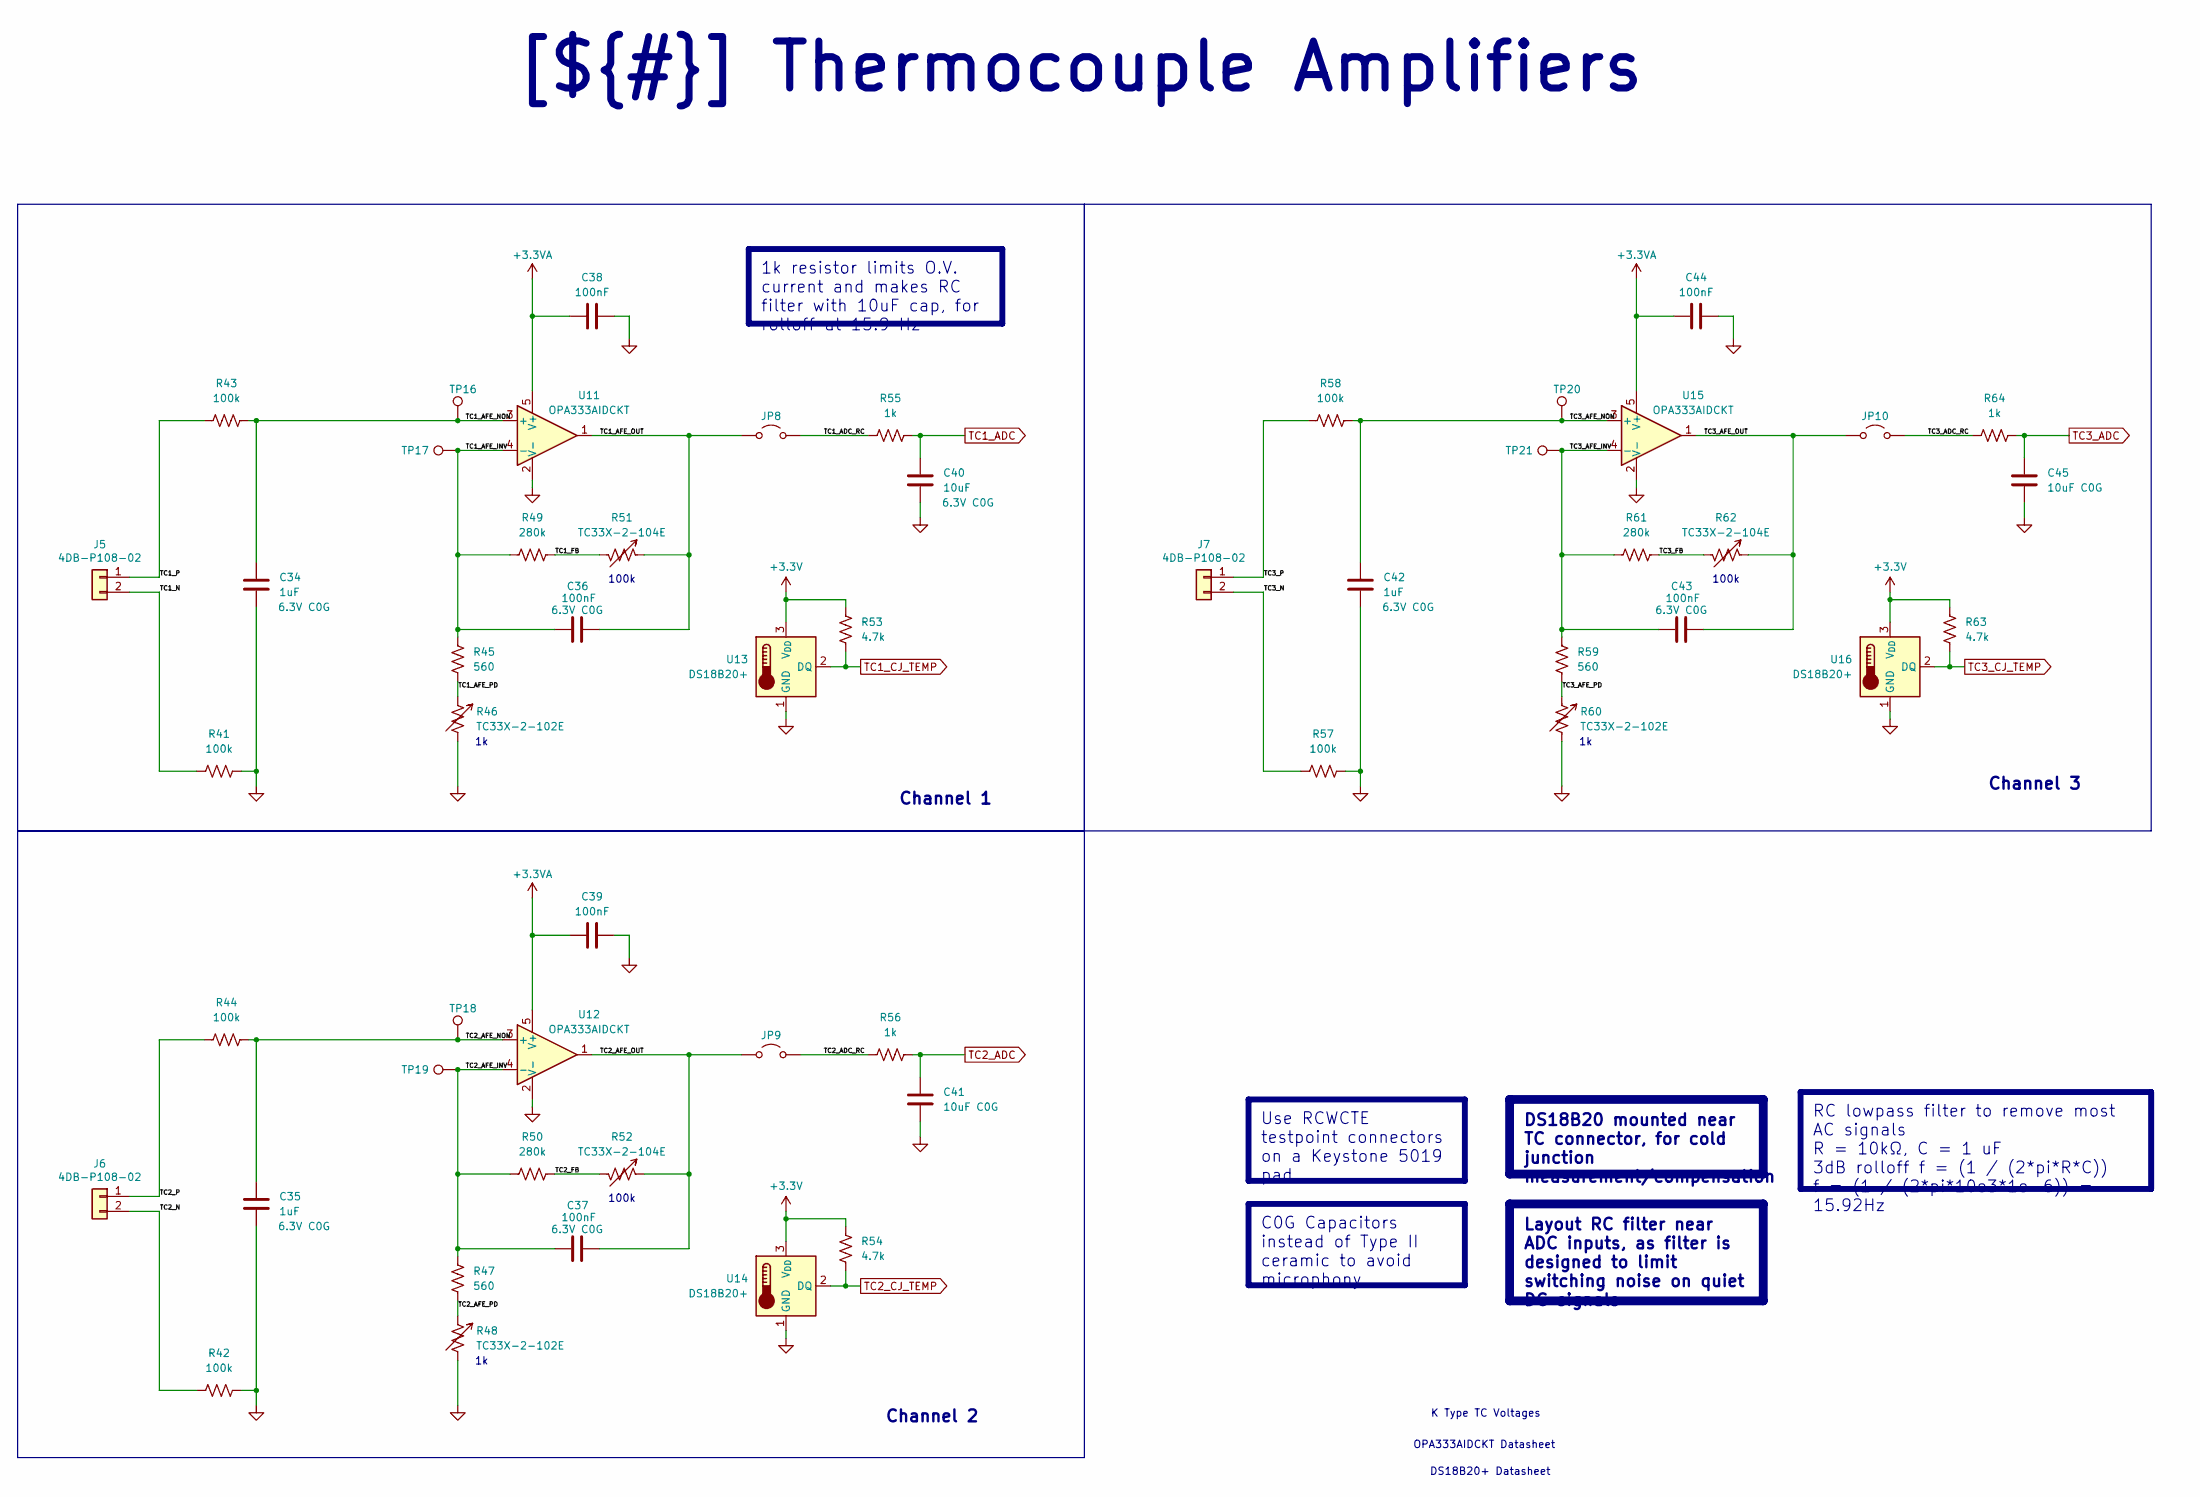
[picture p49: schematic thermocouple.kicad_sch, Thermocouple Amplifiers]

Parts:
C34, C35, C42: 1uF; C_0603_1608Metric_Pad1.08x0.95mm_HandSolder
C36, C37, C43: 100nF; C_0603_1608Metric_Pad1.08x0.95mm_HandSolder
C38, C39, C44: 100nF; C_0805_2012Metric_Pad1.18x1.45mm_HandSolder
C40: 10uF; C_0603_1608Metric_Pad1.08x0.95mm_HandSolder
C41, C45: 10uF C0G; C_0603_1608Metric_Pad1.08x0.95mm_HandSolder
J5, J6, J7: 4DB-P108-02; CONN_4DB-P108-02_TEC
JP8, JP9, JP10: Jumper_2_Open; SolderJumper-2_P1.3mm_Open_TrianglePad1.0x1.5mm
R41, R42, R43, R44, R57, R58: 100k; R_0603_1608Metric_Pad0.98x0.95mm_HandSolder
R45, R47, R59: 560; R_0603_1608Metric_Pad0.98x0.95mm_HandSolder
R46, R48, R60: TC33X-2-102E; Potentiometer_Bourns_TC33X_Vertical
R49, R50, R61: 280k; R_0603_1608Metric_Pad0.98x0.95mm_HandSolder
R51, R52, R62: TC33X-2-104E; Potentiometer_Bourns_TC33X_Vertical
R53, R54, R63: 4.7k; R_0603_1608Metric_Pad0.98x0.95mm_HandSolder
R55, R56, R64: 1k; R_0603_1608Metric_Pad0.98x0.95mm_HandSolder
TP16, TP17, TP18, TP19, TP20, TP21: TestPoint; TestPoint_Pad_D1.5mm
U11, U12, U15: OPA333AIDCKT; SOIC-8_3.9x4.9mm_P1.27mm
U13, U14, U16: DS18B20+; TO-92_Inline

Connections:
+3.3V: R53.1, R54.1, R63.1, U13.3 (V_{DD}), U14.3 (V_{DD}), U16.3 (V_{DD}); also elsewhere on the board
+3.3VA: C38.1, C39.1, C44.1, U11.5 (V+), U12.5 (V+), U15.5 (V+); also elsewhere on the board
/Project Architecture/Thermocouple/TC1_ADC_RC: JP8.2 (B), R55.1
/Project Architecture/Thermocouple/TC1_AFE_INV: C36.1, R45.1, R49.1, TP17.1 (1_1), U11.4 (-)
/Project Architecture/Thermocouple/TC1_AFE_NON: C34.1, R43.2, TP16.1 (1_1), U11.3 (+)
/Project Architecture/Thermocouple/TC1_AFE_OUT: C36.2, JP8.1 (A), R51.1, U11.1
/Project Architecture/Thermocouple/TC1_AFE_PD: R45.2, R46.1
/Project Architecture/Thermocouple/TC1_FB: R49.2, R51.2
/Project Architecture/Thermocouple/TC1_N: J5.2, R41.1
/Project Architecture/Thermocouple/TC1_P: J5.1, R43.1
/Project Architecture/Thermocouple/TC2_ADC_RC: JP9.2 (B), R56.1
/Project Architecture/Thermocouple/TC2_AFE_INV: C37.1, R47.1, R50.1, TP19.1 (1_1), U12.4 (-)
/Project Architecture/Thermocouple/TC2_AFE_NON: C35.1, R44.2, TP18.1 (1_1), U12.3 (+)
/Project Architecture/Thermocouple/TC2_AFE_OUT: C37.2, JP9.1 (A), R52.1, U12.1
/Project Architecture/Thermocouple/TC2_AFE_PD: R47.2, R48.1
/Project Architecture/Thermocouple/TC2_FB: R50.2, R52.2
/Project Architecture/Thermocouple/TC2_N: J6.2, R42.1
/Project Architecture/Thermocouple/TC2_P: J6.1, R44.1
/Project Architecture/Thermocouple/TC3_ADC_RC: JP10.2 (B), R64.1
/Project Architecture/Thermocouple/TC3_AFE_INV: C43.1, R59.1, R61.1, TP21.1 (1_1), U15.4 (-)
/Project Architecture/Thermocouple/TC3_AFE_NON: C42.1, R58.2, TP20.1 (1_1), U15.3 (+)
/Project Architecture/Thermocouple/TC3_AFE_OUT: C43.2, JP10.1 (A), R62.1, U15.1
/Project Architecture/Thermocouple/TC3_AFE_PD: R59.2, R60.1
/Project Architecture/Thermocouple/TC3_FB: R61.2, R62.2
/Project Architecture/Thermocouple/TC3_N: J7.2, R57.1
/Project Architecture/Thermocouple/TC3_P: J7.1, R58.1
GND: C34.2, C35.2, C38.2, C39.2, C40.2, C41.2, C42.2, C44.2, C45.2, R41.2, R42.2, R46.2, R48.2, R57.2, R60.2, U11.2 (V-), U12.2 (V-), U13.1 (GND), U14.1 (GND), U15.2 (V-), U16.1 (GND); also elsewhere on the board
TC1_ADC: C40.1, R55.2; also elsewhere on the board
TC1_CJ_TEMP: R53.2, U13.2 (DQ)
TC2_ADC: C41.1, R56.2; also elsewhere on the board
TC2_CJ_TEMP: R54.2, U14.2 (DQ)
TC3_ADC: C45.1, R64.2; also elsewhere on the board
TC3_CJ_TEMP: R63.2, U16.2 (DQ)

Notes on the sheet:
DS18B20+ Datasheet
Channel 1
100k
Channel 3
Channel 2
K Type TC Voltages
OPA333AIDCKT Datasheet
Layout RC filter near ADC inputs, as filter is designed to limit switching noise on quiet DC signals
1k resistor limits O.V. current and makes RC filter with 10uF cap, for rolloff at 15.9 Hz
DS18B20 mounted near TC connector, for cold junction measurement/compensation
RC lowpass filter to remove most AC signals R = 10kΩ, C = 1 uF 3dB rolloff f = (1 / (2*pi*R*C)) f = (1 / (2*pi*10e3*1e-6)) = 15.92Hz
Use RCWCTE testpoint connectors on a Keystone 5019 pad
[${#}] ${TITLE}
C0G Capacitors instead of Type II ceramic to avoid microphony
