MichaelPate/ToasterFlo/mainBoard/mainBoard.kicad_pcb

## KiCad design mainBoard/mainBoard.kicad_pcb (continued)

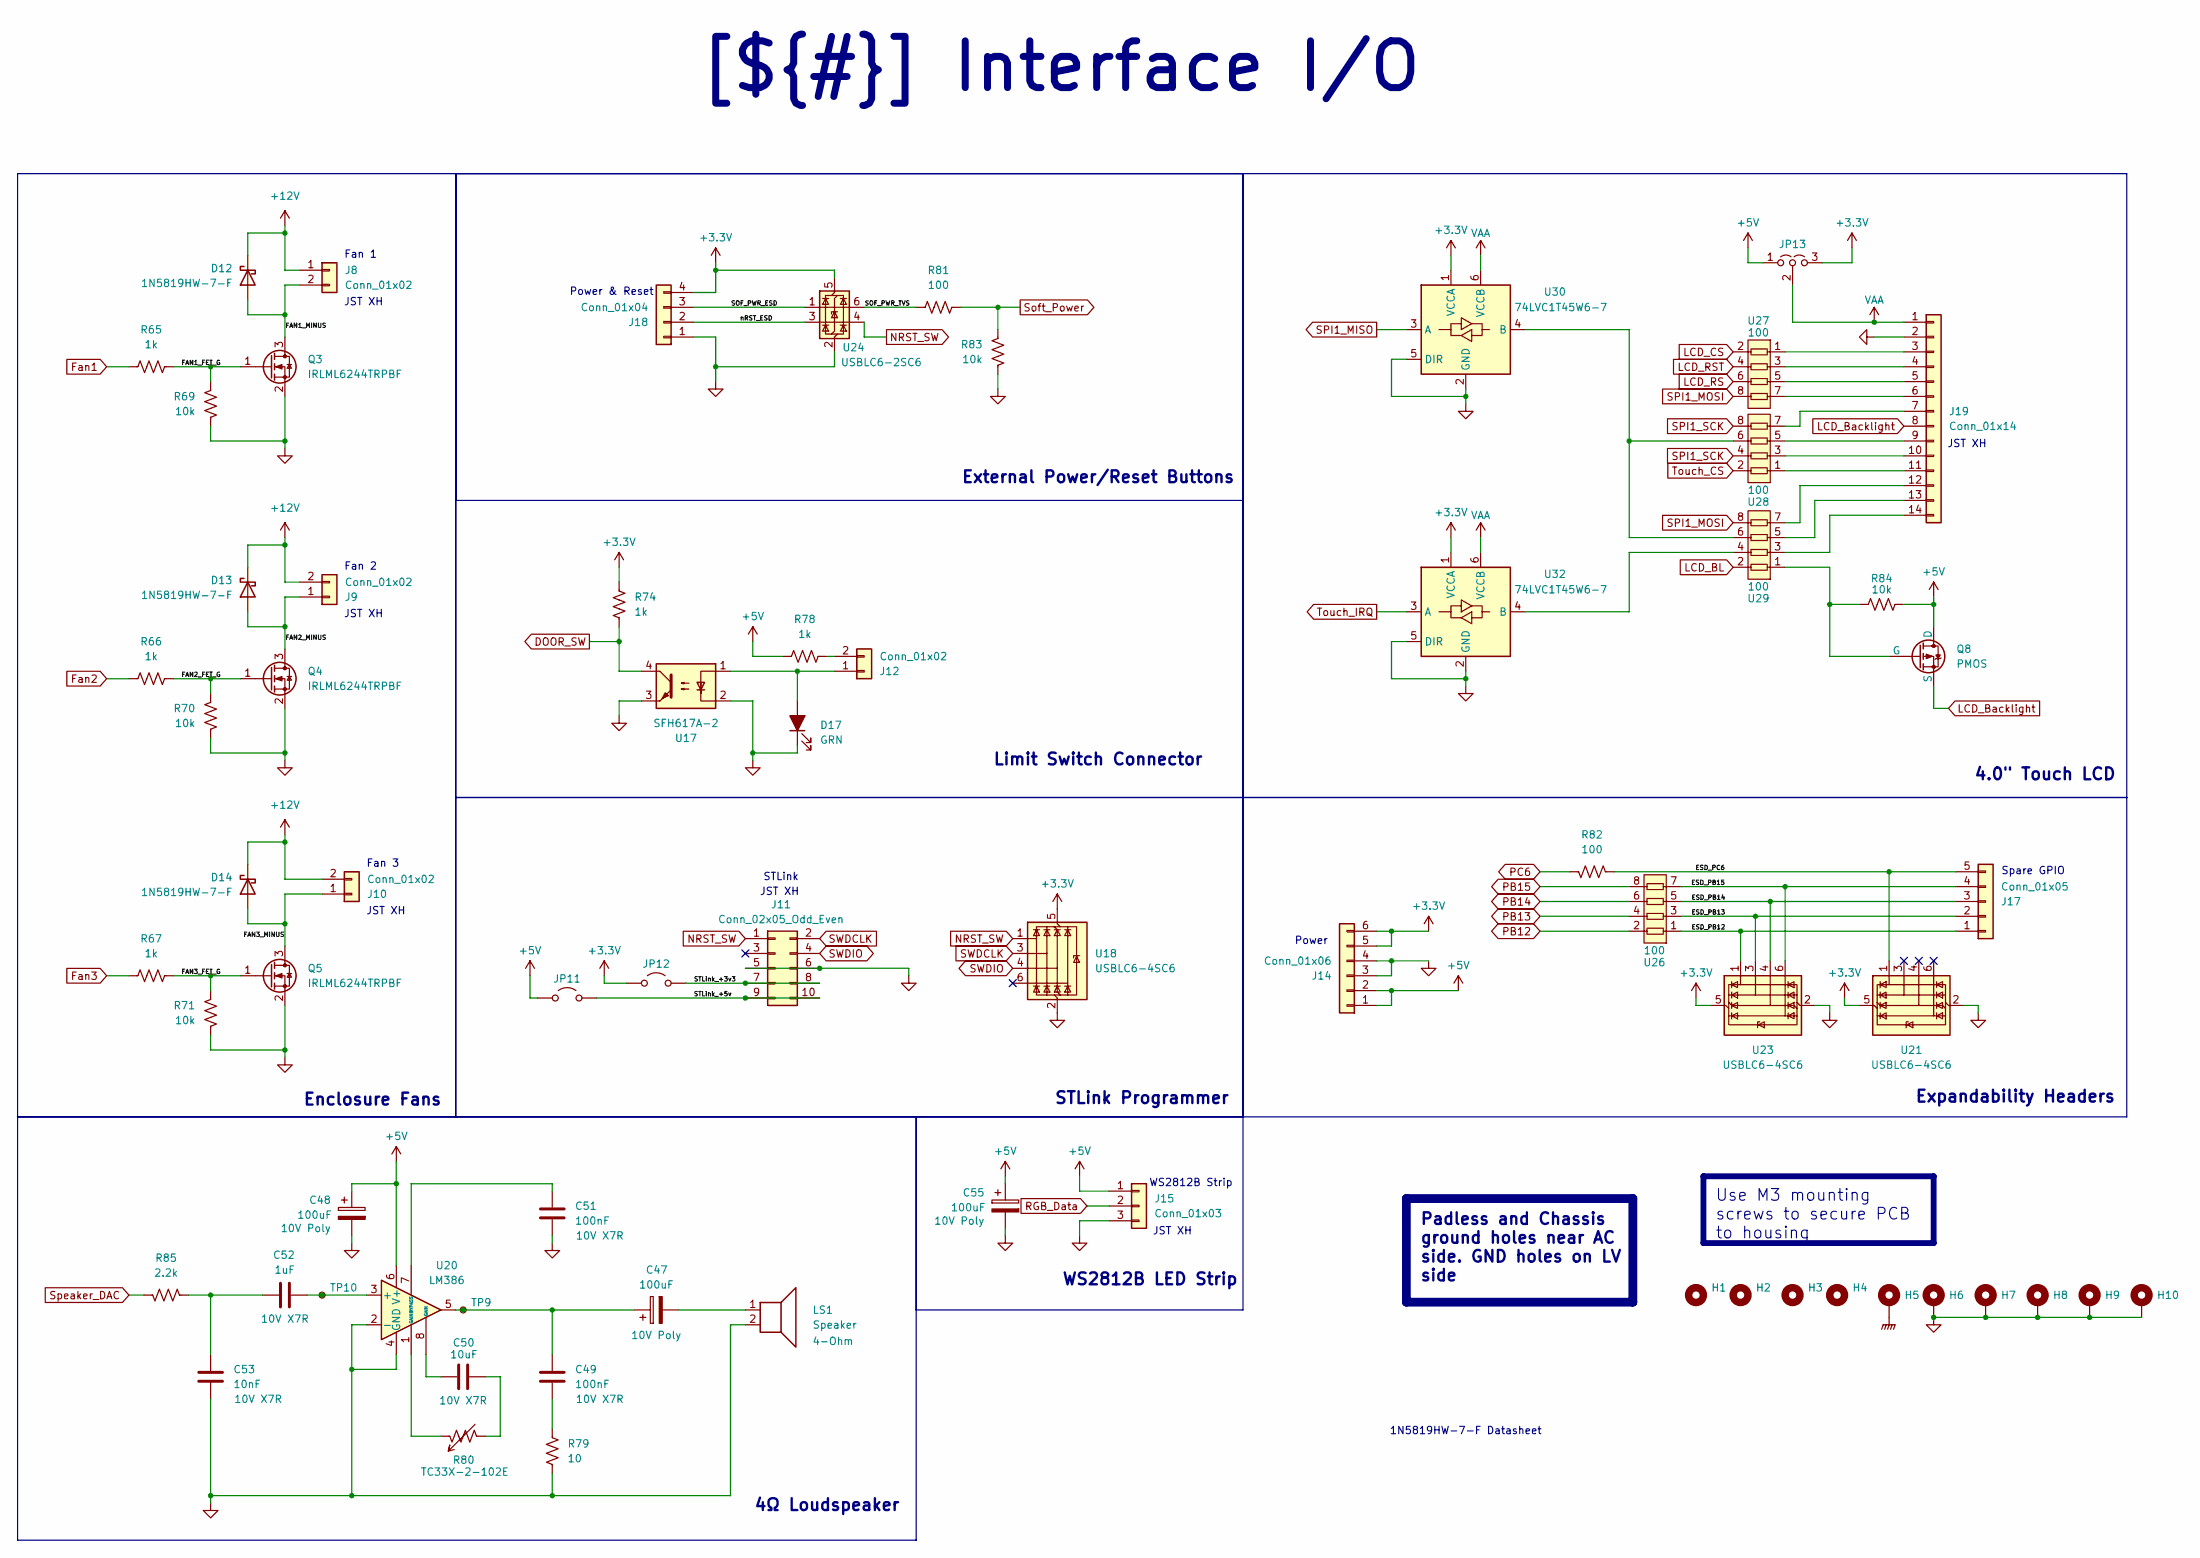
[picture p50: schematic connectors.kicad_sch, Interface I/O]

Parts:
C47, C48, C55: 100uF; C_Elec_6.3x5.8; part number A768EB476M1VLAE042
C49, C51: 100nF; C_0805_2012Metric_Pad1.18x1.45mm_HandSolder; part number CL31A226MOCLNNC
C50: 10uF; C_0805_2012Metric_Pad1.18x1.45mm_HandSolder; part number CL31A226MOCLNNC
C52: 1uF; C_0805_2012Metric_Pad1.18x1.45mm_HandSolder; part number CL31A226MOCLNNC
C53: 10nF; C_0603_1608Metric_Pad1.08x0.95mm_HandSolder; part number CL31A226MOCLNNC
D12, D13, D14: 1N5819HW-7-F; D_SOD-123
D17: GRN; LED_0603_1608Metric_Pad1.05x0.95mm_HandSolder
H1, H2, H3, H4: MountingHole; MountingHole_3.2mm_M3
H5, H6, H7, H8, H9, H10: MountingHole_Pad; MountingHole_3.2mm_M3_Pad_Via
J8, J9, J10: Conn_01x02; JST_XH_B2B-XH-A_1x02_P2.50mm_Vertical
J11: Conn_02x05_Odd_Even; IDC-Header_2x05_P2.54mm_Vertical
J12: Conn_01x02; TerminalBlock_Phoenix_MKDS-1,5-2-5.08_1x02_P5.08mm_Horizont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
J14: Conn_01x06; PinHeader_1x06_P2.54mm_Vertical
J15: Conn_01x03; JST_XH_B3B-XH-A_1x03_P2.50mm_Vertical
J17: Conn_01x05; PinHeader_1x05_P2.54mm_Vertical
J18: Conn_01x04; JST_XH_B4B-XH-A_1x04_P2.50mm_Vertical
J19: Conn_01x14; JST_XH_B14B-XH-A_1x14_P2.50mm_Vertical
JP11, JP12: Jumper_2_Open; SolderJumper-2_P1.3mm_Open_TrianglePad1.0x1.5mm
JP13: Jumper_3_Open; SolderJumper-3_P1.3mm_Open_RoundedPad1.0x1.5mm
LS1: Speaker; JST_PH_B2B-PH-K_1x02_P2.00mm_Vertical
Q3, Q4, Q5: IRLML6244TRPBF; SOT-23
Q8: PMOS
R65, R66, R67, R74, R78: 1k; R_0603_1608Metric_Pad0.98x0.95mm_HandSolder
R69, R70, R71, R83, R84: 10k; R_0603_1608Metric_Pad0.98x0.95mm_HandSolder
R79: 10; R_0603_1608Metric_Pad0.98x0.95mm_HandSolder
R80: TC33X-2-102E; Potentiometer_Bourns_TC33X_Vertical
R81, R82: 100; R_0603_1608Metric_Pad0.98x0.95mm_HandSolder
R85: 2.2k; R_0603_1608Metric_Pad0.98x0.95mm_HandSolder
TP9, TP10: TestPoint_Small; TestPoint_Pad_D1.0mm
U17: SFH617A-2; DIP-4_W7.62mm
U18, U21, U23: USBLC6-4SC6; SOT-23-6
U20: LM386; SOIC-8_3.9x4.9mm_P1.27mm
U24: USBLC6-2SC6; SOT-23-6
U26, U27, U28, U29: 100; R_Array_Convex_4x1206; part number RAVF164DJT100R
U30, U32: 74LVC1T45W6-7; SOT-23-6

Connections:
+3.3V: J14.5, J14.6, J18.4, JP12.1 (A), JP13.3 (B), R74.1, U18.5 (VBUS), U21.5 (VBUS), U23.5 (VBUS), U24.5 (VBUS), U30.1 (VCCA), U32.1 (VCCA); also elsewhere on the board
+5V: C48.1, C55.1, J14.1, J14.2, J15.1, JP11.1 (A), JP13.1 (A), Q8.1 (D), R78.2, R84.2, U20.6 (V+); also elsewhere on the board
+12V: D12.1 (K), D13.1 (K), D14.1 (K), J8.1, J9.2, J10.2; also elsewhere on the board
/Project Architecture/Peripherals and Connectors/ESD_PB12: J17.1, U23.1 (I/O1), U26.1
/Project Architecture/Peripherals and Connectors/ESD_PB13: J17.2, U23.3 (I/O2), U26.3
/Project Architecture/Peripherals and Connectors/ESD_PB14: J17.3, U23.4 (I/O3), U26.5
/Project Architecture/Peripherals and Connectors/ESD_PB15: J17.4, U23.6 (I/O4), U26.7
/Project Architecture/Peripherals and Connectors/ESD_PC6: J17.5, R82.1, U21.1 (I/O1)
/Project Architecture/Peripherals and Connectors/FAN1_FET_G: Q3.1 (G), R65.2, R69.1
/Project Architecture/Peripherals and Connectors/FAN1_MINUS: D12.2 (A), J8.2, Q3.3 (D)
/Project Architecture/Peripherals and Connectors/FAN2_FET_G: Q4.1 (G), R66.2, R70.1
/Project Architecture/Peripherals and Connectors/FAN2_MINUS: D13.2 (A), J9.1, Q4.3 (D)
/Project Architecture/Peripherals and Connectors/FAN3_FET_G: Q5.1 (G), R67.2, R71.1
/Project Architecture/Peripherals and Connectors/FAN3_MINUS: D14.2 (A), J10.1, Q5.3 (D)
/Project Architecture/Peripherals and Connectors/SOF_PWR_ESD: J18.3, U24.1 (I/O1)
/Project Architecture/Peripherals and Connectors/SOF_PWR_TVS: R81.1, U24.6 (I/O1)
/Project Architecture/Peripherals and Connectors/STLink_+3v3: J11.7, J11.8, JP12.2 (B)
/Project Architecture/Peripherals and Connectors/STLink_+5v: J11.9, J11.10, JP11.2 (B)
/Project Architecture/Peripherals and Connectors/nRST_ESD: J18.2, U24.3 (I/O2)
DOOR_SW: R74.2, U17.4
Fan1: R65.1
Fan2: R66.1
Fan3: R67.1
GND: C48.2, C51.2, C53.2, C55.2, D17.1 (K), H6.1 (1_1), H7.1 (1_1), H8.1 (1_1), H9.1 (1_1), H10.1 (1_1), J11.5, J11.6, J14.3, J14.4, J15.3, J18.1, J19.2, LS1.2, Q3.2 (S), Q4.2 (S), Q5.2 (S), R69.2, R70.2, R71.2, R79.2, R83.2, U17.2, U17.3, U18.2 (GND), U20.2 (-), U20.4 (GND), U21.2 (GND), U23.2 (GND), U24.2 (GND), U30.2 (GND), U30.5 (DIR), U32.2 (GND), U32.5 (DIR); also elsewhere on the board
GNDPWR: H5.1 (1_1); also elsewhere on the board
LCD_BL: U29.2
LCD_Backlight: J19.8, Q8.3 (S)
LCD_CS: U27.2
LCD_RS: U27.6
LCD_RST: U27.4
NRST_SW: J11.1, U18.1 (I/O1), U24.4 (I/O2); also elsewhere on the board
unnamed: C47.1, C49.1, TP9.1 (1_1), U20.5
unnamed: C47.2, LS1.1
unnamed: C49.2, R79.1
unnamed: C50.1, U20.8 (GAIN)
unnamed: C50.2, R80.2
unnamed: C52.1, C53.1, R85.1
unnamed: D17.2 (A), J12.1, U17.1
unnamed: J12.2, R78.1
unnamed: J19.3, U27.1
unnamed: J19.4, U27.3
unnamed: J19.5, U27.5
unnamed: J19.6, U27.7
unnamed: J19.7, U28.7
unnamed: J19.9, U28.5
unnamed: J19.10, U28.3
unnamed: J19.11, U28.1
unnamed: J19.12, U29.7
unnamed: J19.13, U29.5
unnamed: J19.14, U29.3
unnamed: Q8.2 (G), R84.1, U29.1
unnamed: R80.1, U20.1 (GAIN)
unnamed: C52.2, TP10.1 (1_1), U20.3 (+)
unnamed: C51.1, U20.7 (BYPASS)
unnamed: U28.6, U29.6, U30.4 (B)
unnamed: U29.4, U32.4 (B)
PB12: U26.2
PB13: U26.4
PB14: U26.6
PB15: U26.8
PC6: R82.2
RGB_Data: J15.2
SPI1_MISO: U30.3 (A); also elsewhere on the board
SPI1_MOSI: U27.8, U29.8; also elsewhere on the board
SPI1_SCK: U28.4, U28.8; also elsewhere on the board
SWDCLK: J11.2, U18.3 (I/O2); also elsewhere on the board
SWDIO: J11.4, U18.4 (I/O3); also elsewhere on the board
Soft_Power: R81.2, R83.1
Speaker_DAC: R85.2
Touch_CS: U28.2
Touch_IRQ: U32.3 (A)
VAA: J19.1, JP13.2 (C), U30.6 (VCCB), U32.6 (VCCB)

Notes on the sheet:
Enclosure Fans
External Power/Reset Buttons
STLink Programmer
1N5819HW-7-F Datasheet
Fan 2
JST XH
4.0" Touch LCD
WS2812B Strip
Expandability Headers
Limit Switch Connector
Spare GPIO
4Ω Loudspeaker
WS2812B LED Strip
STLink
Fan 1
Power & Reset
Fan 3
Power
Padless and Chassis ground holes near AC side. GND holes on LV side
Use M3 mounting screws to secure PCB to housing
[${#}] ${TITLE}

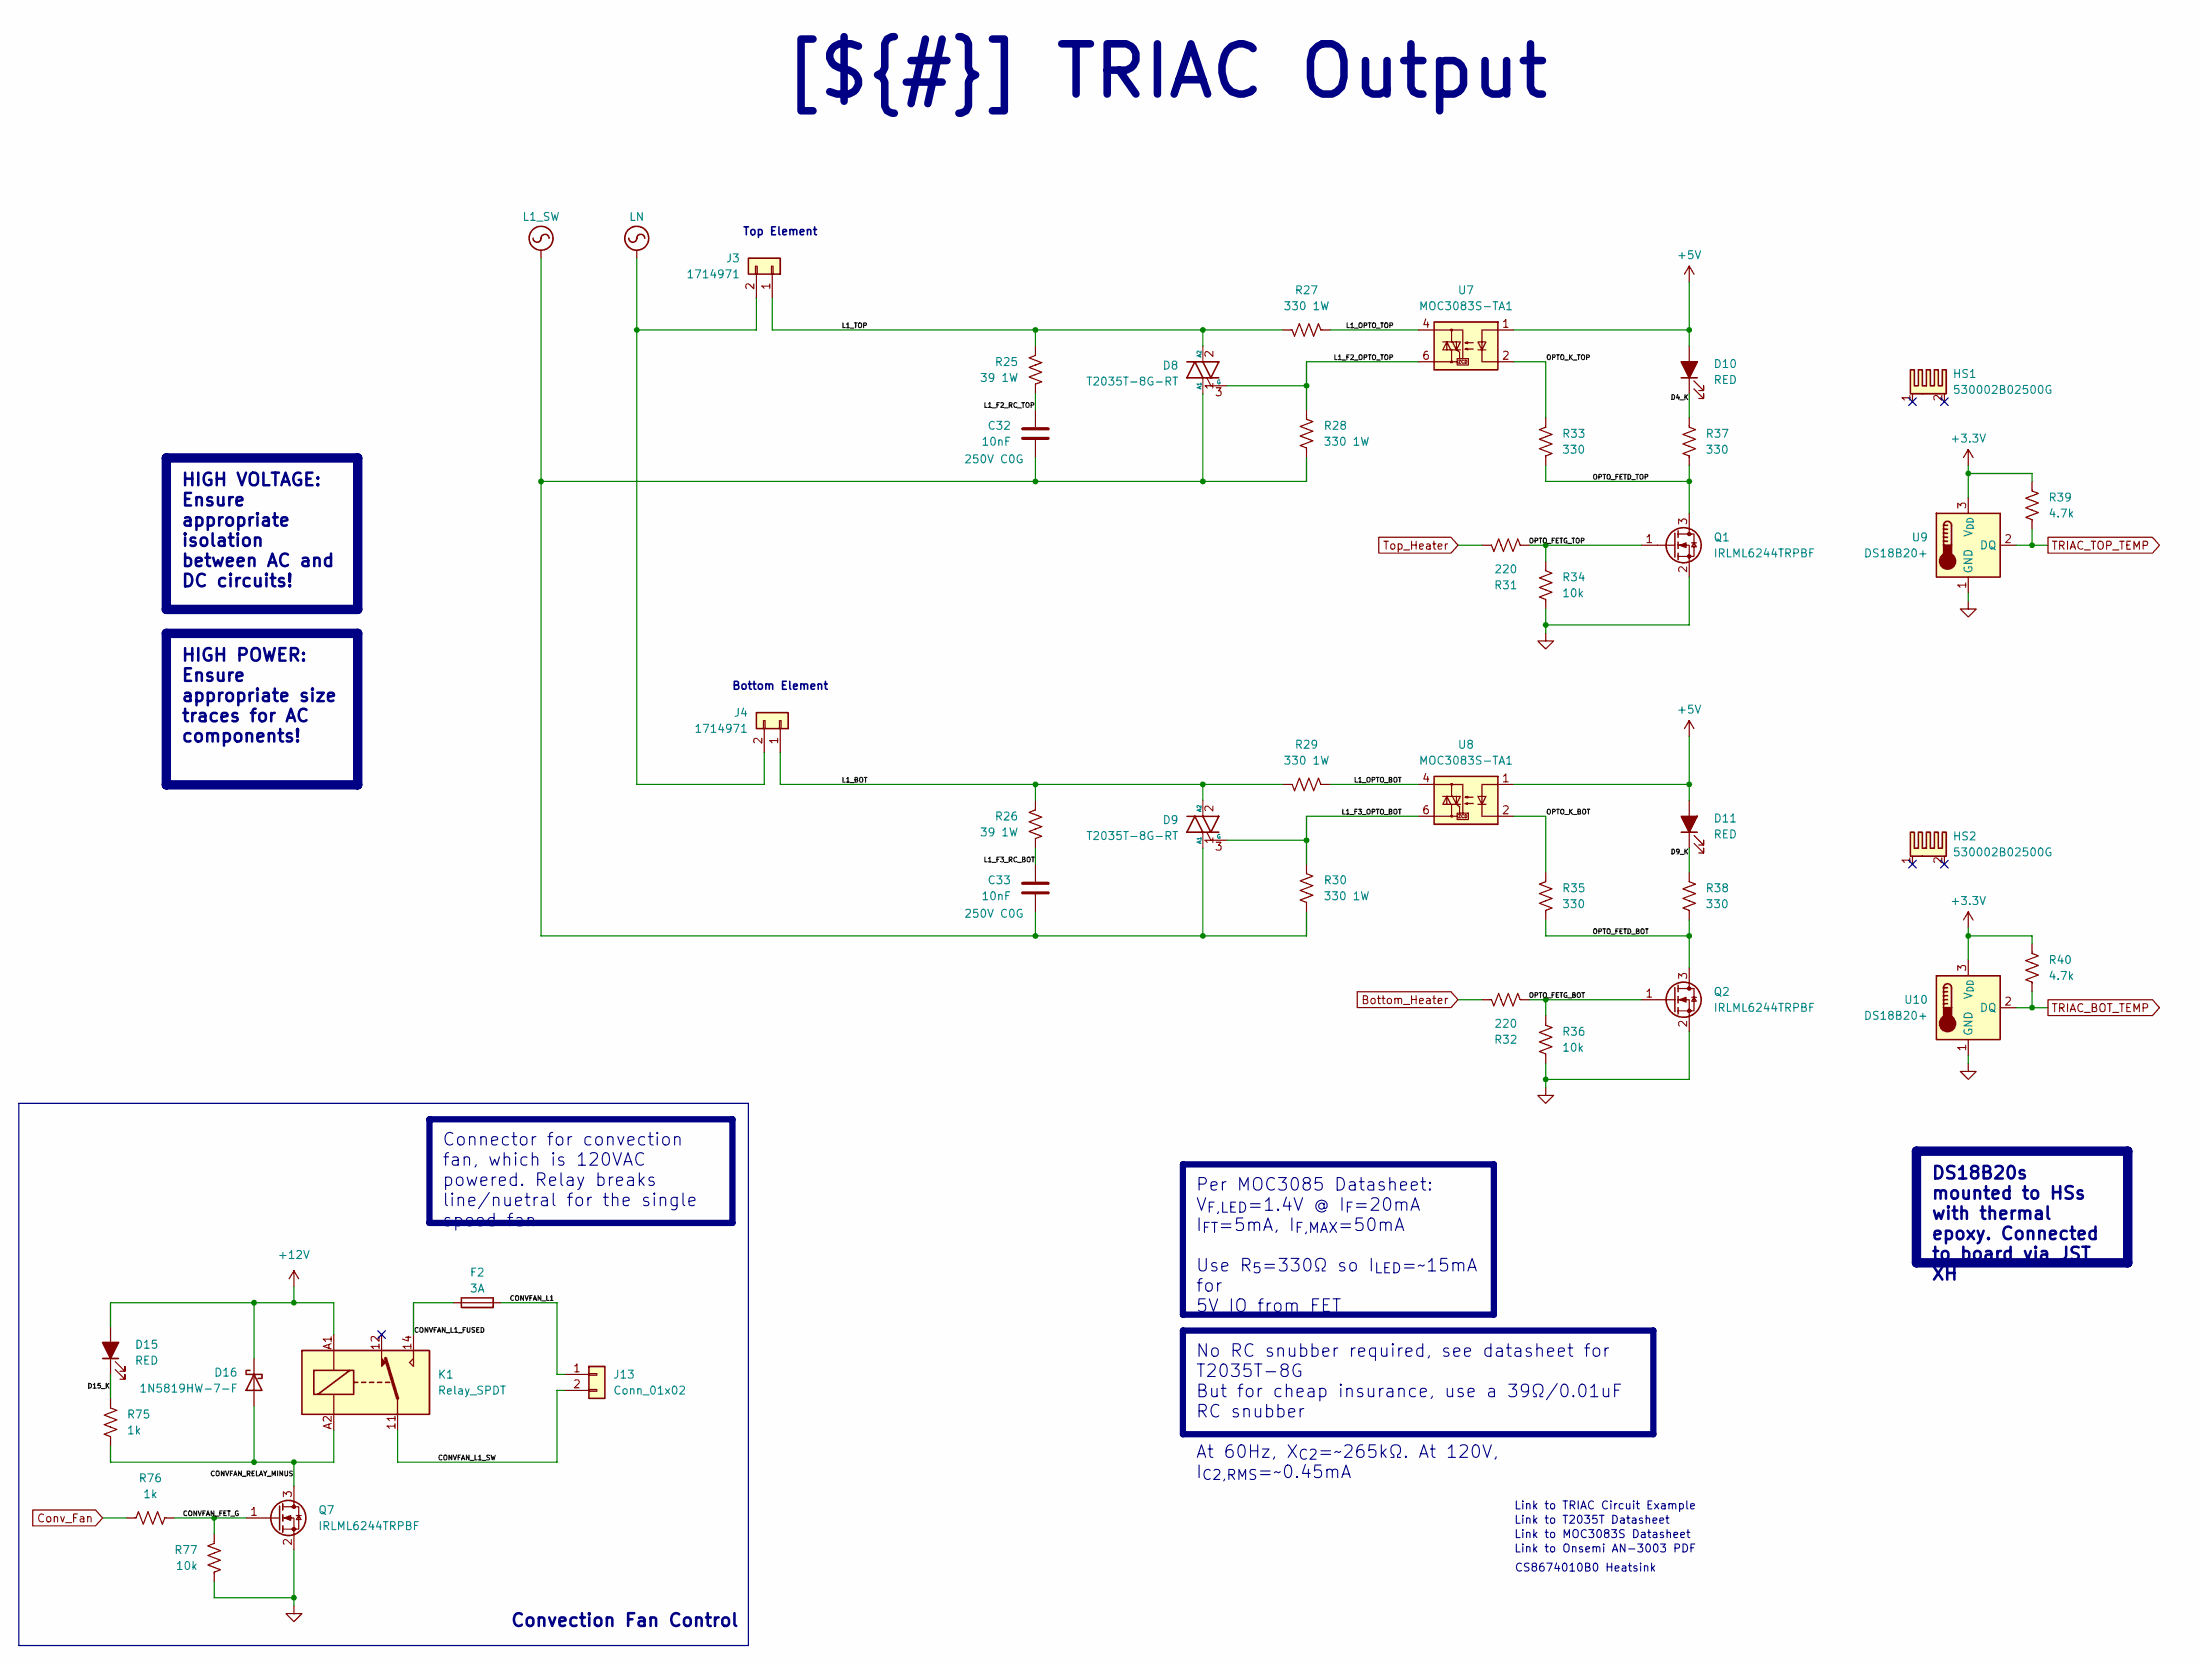
[picture p51: schematic triac.kicad_sch, TRIAC Output]

Parts:
C32, C33: 10nF; C_1812_4532Metric_Pad1.57x3.40mm_HandSolder
D8, D9: T2035T-8G-RT; TO-220-3_Vertical
D10, D11, D15: RED; LED_0603_1608Metric_Pad1.05x0.95mm_HandSolder
D16: 1N5819HW-7-F; D_SOD-123
F2: 3A; Fuseholder_Clip-5x20mm_Littelfuse_100_Inline_P20.50x4.60mm_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
HS1, HS2: 530002B02500G; 53002B02500G
J3, J4: 1714971; CONN_1714971_PXC
J13: Conn_01x02; CONN_1714971_PXC
K1: Relay_SPDT; Relay_SPDT_Finder_36.11
Q1, Q2, Q7: IRLML6244TRPBF; SOT-23
R25, R26: 39 1W; R_2512_6332Metric_Pad1.40x3.35mm_HandSolder
R27, R28, R29, R30: 330 1W; R_2512_6332Metric_Pad1.40x3.35mm_HandSolder
R31, R32: 220; R_0603_1608Metric_Pad0.98x0.95mm_HandSolder
R33, R35, R37, R38: 330; R_0603_1608Metric_Pad0.98x0.95mm_HandSolder
R34, R36, R77: 10k; R_0603_1608Metric_Pad0.98x0.95mm_HandSolder
R39, R40: 4.7k; R_0603_1608Metric_Pad0.98x0.95mm_HandSolder
R75, R76: 1k; R_0603_1608Metric_Pad0.98x0.95mm_HandSolder
U7, U8: MOC3083S-TA1; SMDIP-6_W9.53mm
U9, U10: DS18B20+; JST_XH_B3B-XH-A_1x03_P2.50mm_Vertical

Connections:
+3.3V: R39.1, R40.1, U9.3 (V_{DD}), U10.3 (V_{DD}); also elsewhere on the board
+5V: D10.2 (A), D11.2 (A), U7.1, U8.1; also elsewhere on the board
+12V: D15.2 (A), D16.1 (K), K1.A1; also elsewhere on the board
/Project Architecture/TRIAC/CONVFAN_FET_G: Q7.1 (G), R76.2, R77.1
/Project Architecture/TRIAC/CONVFAN_L1: F2.2, J13.1
/Project Architecture/TRIAC/CONVFAN_L1_FUSED: F2.1, K1.14
/Project Architecture/TRIAC/CONVFAN_L1_SW: J13.2, K1.11
/Project Architecture/TRIAC/CONVFAN_RELAY_MINUS: D16.2 (A), K1.A2, Q7.3 (D), R75.2
/Project Architecture/TRIAC/D4_K: D10.1 (K), R37.1
/Project Architecture/TRIAC/D9_K: D11.1 (K), R38.1
/Project Architecture/TRIAC/D15_K: D15.1 (K), R75.1
/Project Architecture/TRIAC/L1_BOT: D9.2 (A2), J4.1, R26.2, R29.2
/Project Architecture/TRIAC/L1_F2_OPTO_TOP: D8.3 (G), R28.2, U7.6
/Project Architecture/TRIAC/L1_F2_RC_TOP: C32.1, R25.1
/Project Architecture/TRIAC/L1_F3_OPTO_BOT: D9.3 (G), R30.2, U8.6
/Project Architecture/TRIAC/L1_F3_RC_BOT: C33.1, R26.1
/Project Architecture/TRIAC/L1_OPTO_BOT: R29.1, U8.4
/Project Architecture/TRIAC/L1_OPTO_TOP: R27.1, U7.4
/Project Architecture/TRIAC/L1_TOP: D8.2 (A2), J3.1, R25.2, R27.2
/Project Architecture/TRIAC/OPTO_FETD_BOT: Q2.3 (D), R35.2, R38.2
/Project Architecture/TRIAC/OPTO_FETD_TOP: Q1.3 (D), R33.2, R37.2
/Project Architecture/TRIAC/OPTO_FETG_BOT: Q2.1 (G), R32.2, R36.1
/Project Architecture/TRIAC/OPTO_FETG_TOP: Q1.1 (G), R31.2, R34.1
/Project Architecture/TRIAC/OPTO_K_BOT: R35.1, U8.2
/Project Architecture/TRIAC/OPTO_K_TOP: R33.1, U7.2
Bottom_Heater: R32.1
Conv_Fan: R76.1
GND: Q1.2 (S), Q2.2 (S), Q7.2 (S), R34.2, R36.2, R77.2, U9.1 (GND), U10.1 (GND); also elsewhere on the board
L1_SW: C32.2, C33.2, D8.1 (A1), D9.1 (A1), R28.1, R30.1; also elsewhere on the board
LN: J3.2, J4.2; also elsewhere on the board
TRIAC_BOT_TEMP: R40.2, U10.2 (DQ)
TRIAC_TOP_TEMP: R39.2, U9.2 (DQ)
Top_Heater: R31.1

Notes on the sheet:
Bottom Element
Link to T2035T Datasheet
Convection Fan Control
CS8674010B0 Heatsink
Link to Onsemi AN-3003 PDF
Top Element
Link to TRIAC Circuit Example
Link to MOC3083S Datasheet
HIGH POWER: Ensure appropriate size traces for AC components!
DS18B20s mounted to HSs with thermal epoxy. Connected to board via JST XH
[${#}] ${TITLE}
Connector for convection fan, which is 120VAC powered. Relay breaks line/nuetral for the single speed fan
HIGH VOLTAGE: Ensure appropriate isolation between AC and DC circuits!
No RC snubber required, see datasheet for T2035T-8G But for cheap insurance, use a 39Ω/0.01uF RC snubber At 60Hz, X_{C2}=~265kΩ. At 120V, I_{C2,RMS}=~0.45mA
Per MOC3085 Datasheet: V_{F,LED}=1.4V @ I_{F}=20mA I_{FT}=5mA, I_{F,MAX}=50mA Use R_{5}=330Ω so I_{LED}=~15mA for 5V IO from FET

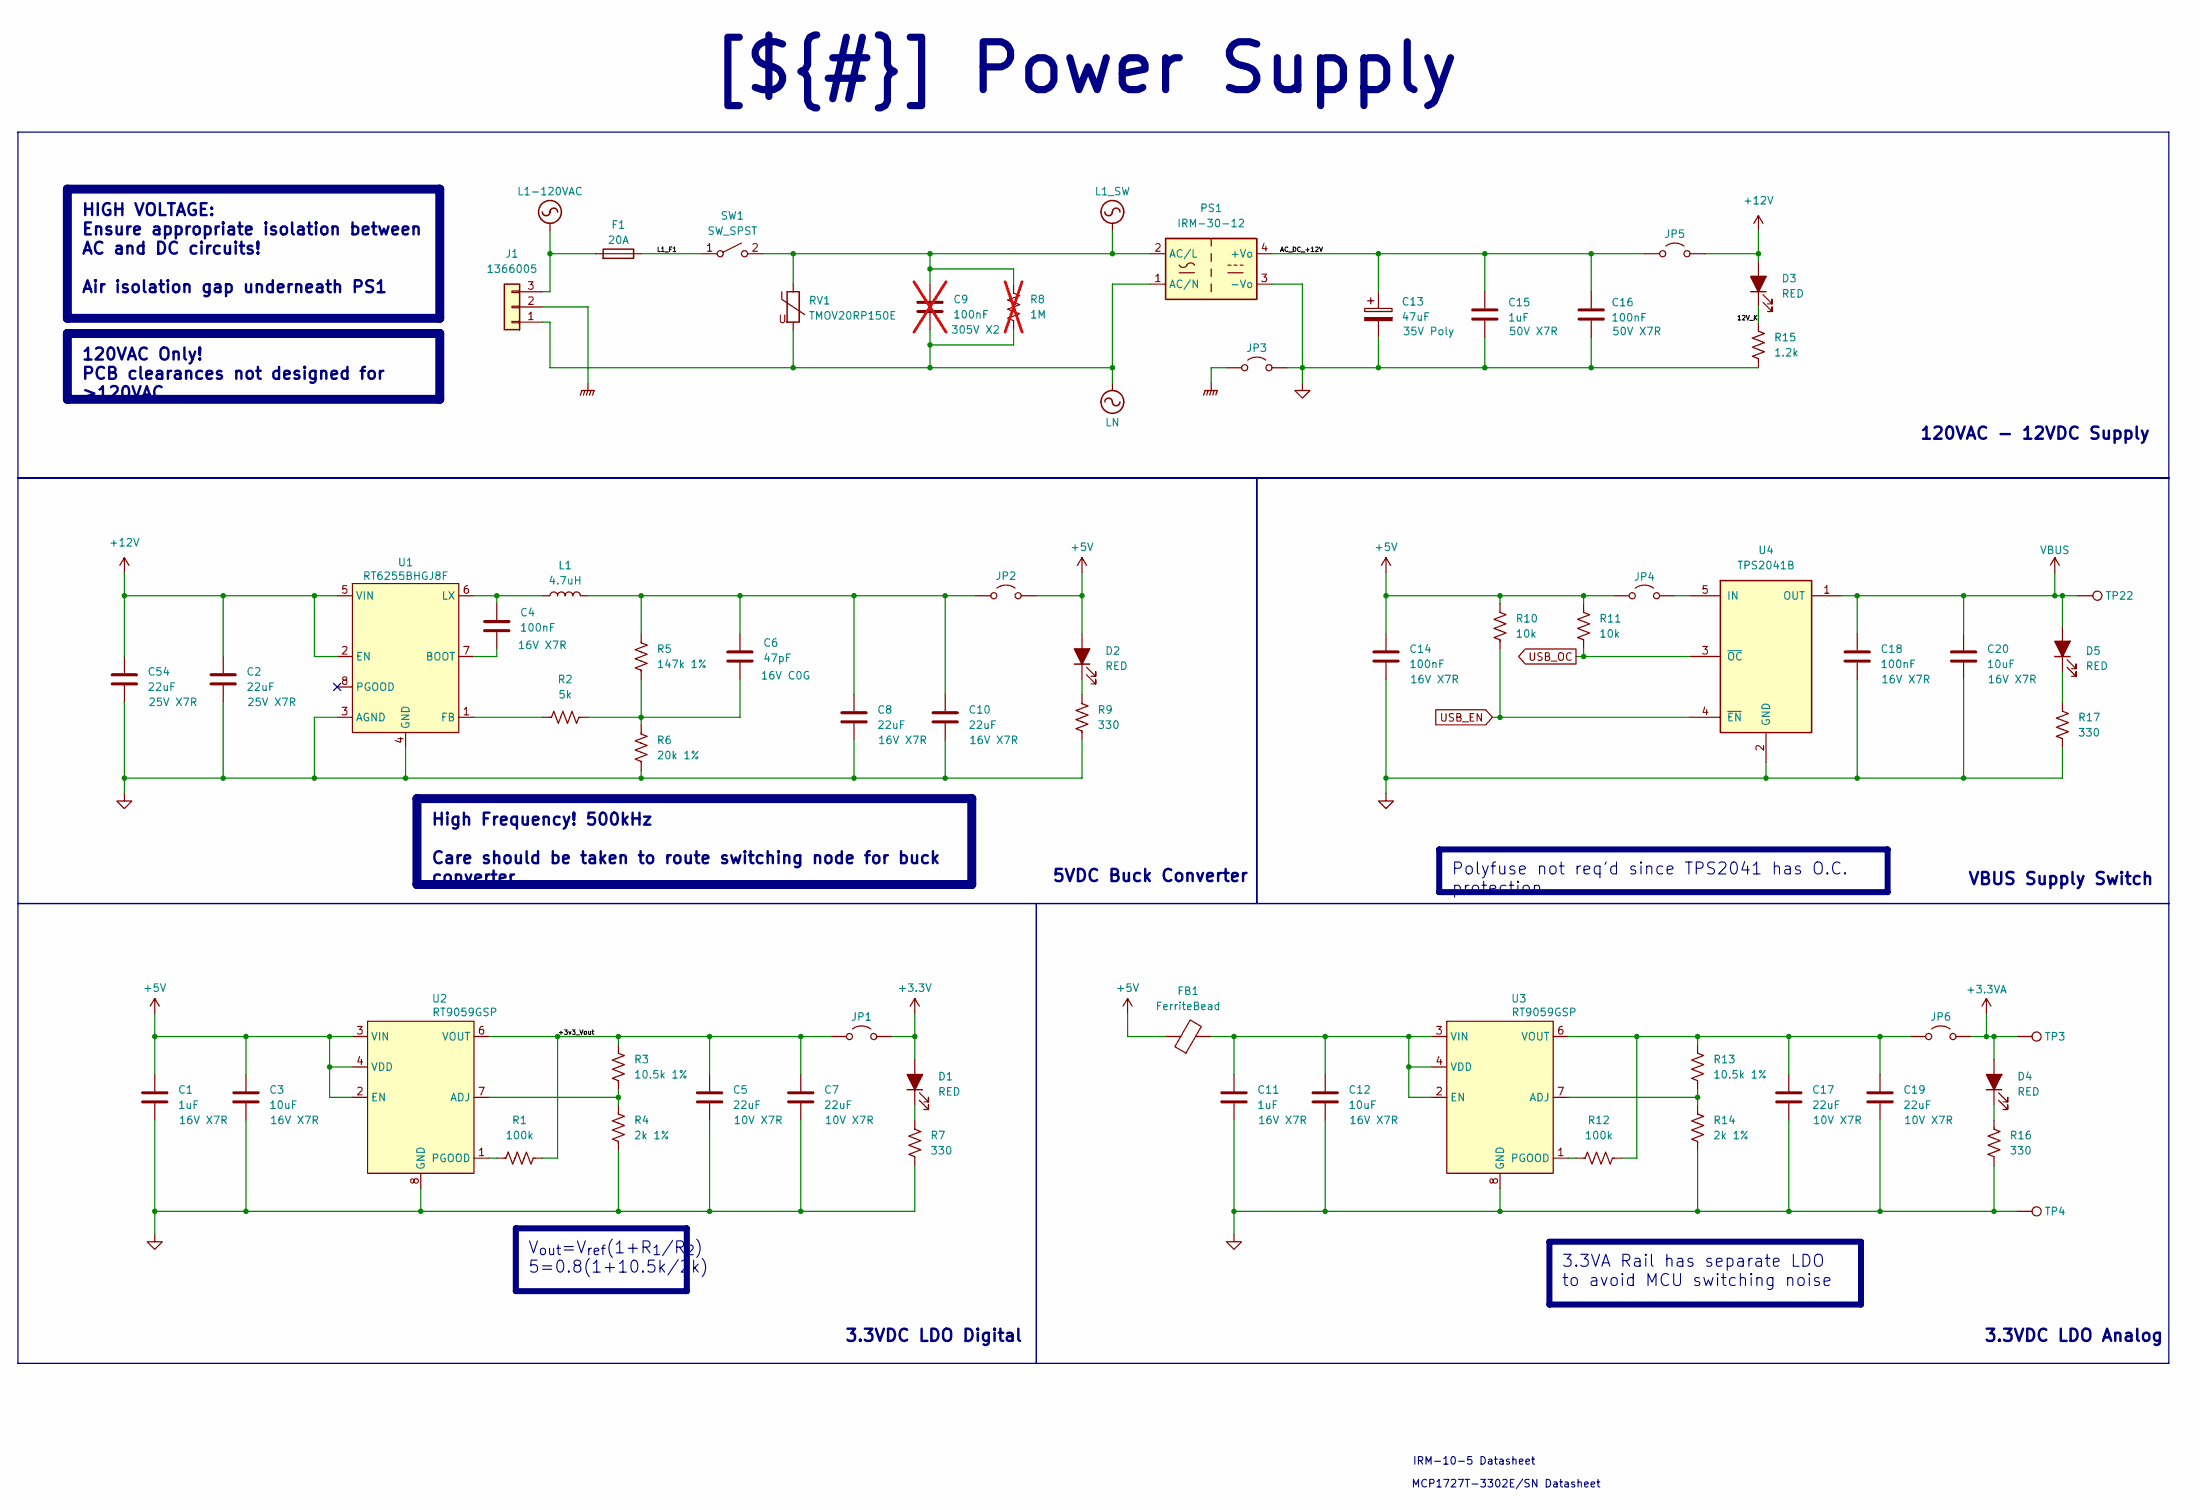
[picture p52: schematic powerSupply.kicad_sch, Power Supply]

Parts:
C1, C11: 1uF; C_0805_2012Metric_Pad1.18x1.45mm_HandSolder; part number CL31A226MOCLNNC
C2, C8, C10, C54: 22uF; C_1206_3216Metric_Pad1.33x1.80mm_HandSolder; part number CL31A226MOCLNNC
C3, C12: 10uF; C_0805_2012Metric_Pad1.18x1.45mm_HandSolder; part number CL31A226MOCLNNC
C4: 100nF; C_0402_1005Metric_Pad0.74x0.62mm_HandSolder
C5, C7, C17, C19: 22uF; C_0805_2012Metric_Pad1.18x1.45mm_HandSolder; part number CL31A226MOCLNNC
C6: 47pF; C_0603_1608Metric_Pad1.08x0.95mm_HandSolder
C9: 100nF; C_Rect_L18.0mm_W5.0mm_P15.00mm_FKS3_FKP3; part number B32922C3104M189; not fitted
C13: 47uF; C_Elec_6.3x5.8; part number A768EB476M1VLAE042
C14, C16, C18: 100nF; C_0603_1608Metric_Pad1.08x0.95mm_HandSolder
C15: 1uF; C_0805_2012Metric_Pad1.18x1.45mm_HandSolder; part number CL21B105KAFNNNE
C20: 10uF; C_0603_1608Metric_Pad1.08x0.95mm_HandSolder
D1, D2, D3, D4, D5: RED; LED_0603_1608Metric_Pad1.05x0.95mm_HandSolder
F1: 20A; Fuseholder_Clip-6.3x32mm_Littelfuse_122_Inline_P34.21x7.62m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
FB1: FerriteBead
J1: 1366005; CONN_1714984_PXC
JP1, JP2, JP4, JP5, JP6: Jumper_2_Open; PinHeader_1x02_P2.54mm_Vertical
JP3: Jumper_2_Open; SolderJumper-2_P1.3mm_Open_TrianglePad1.0x1.5mm
L1: 4.7uH; L_Coilcraft_XAL7030-472; part number 7440700047
PS1: IRM-30-12; IRM-30_MWU
R1, R12: 100k; R_0603_1608Metric_Pad0.98x0.95mm_HandSolder
R2: 5k; R_0603_1608Metric_Pad0.98x0.95mm_HandSolder
R3, R13: 10.5k 1%; R_0603_1608Metric_Pad0.98x0.95mm_HandSolder
R4, R14: 2k 1%; R_0603_1608Metric_Pad0.98x0.95mm_HandSolder
R5: 147k 1%; R_0603_1608Metric_Pad0.98x0.95mm_HandSolder
R6: 20k 1%; R_0603_1608Metric_Pad0.98x0.95mm_HandSolder
R7, R9, R16, R17: 330; R_0603_1608Metric_Pad0.98x0.95mm_HandSolder
R8: 1M; R_2512_6332Metric_Pad1.40x3.35mm_HandSolder; not fitted
R10, R11: 10k; R_0603_1608Metric_Pad0.98x0.95mm_HandSolder
R15: 1.2k; R_0603_1608Metric_Pad0.98x0.95mm_HandSolder
RV1: TMOV20RP150E
SW1: SW_SPST; CONN_1714971_PXC
TP3, TP4: TestPoint; TestPoint_Pad_4.0x4.0mm
TP22: TestPoint; TestPoint_Pad_D2.0mm
U1: RT6255BHGJ8F; TSOT-23-8
U2, U3: RT9059GSP; SOP-8-1EP_4.57x4.57mm_P1.27mm_EP4.57x4.45mm
U4: TPS2041B; SOT-23-5

Connections:
+3.3V: D1.2 (A), JP1.2 (B); also elsewhere on the board
+3.3VA: D4.2 (A), JP6.2 (B), TP3.1 (1_1); also elsewhere on the board
+5V: C1.1, C3.1, C14.1, D2.2 (A), FB1.1, JP2.2 (B), JP4.1 (A), R10.2, R11.2, U2.2 (EN), U2.3 (VIN), U2.4 (VDD); also elsewhere on the board
+12V: C2.1, C54.1, D3.2 (A), JP5.2 (B), U1.2 (EN), U1.5 (VIN); also elsewhere on the board
/Project Architecture/Power Supply/12V_K: D3.1 (K), R15.1
/Project Architecture/Power Supply/+3v3_Vout: C5.1, C7.1, JP1.1 (A), R1.2, R3.1, U2.6 (VOUT)
/Project Architecture/Power Supply/AC_DC_+12V: C13.1, C15.1, C16.1, JP5.1 (A), PS1.4 (+Vo)
/Project Architecture/Power Supply/L1_F1: F1.1, SW1.1 (A)
GND: C1.2, C2.2, C3.2, C5.2, C7.2, C8.2, C10.2, C11.2, C12.2, C13.2, C14.2, C15.2, C16.2, C17.2, C18.2, C19.2, C20.2, C54.2, JP3.2 (B), PS1.3 (-Vo), R4.2, R6.2, R7.2, R9.2, R14.2, R15.2, R16.2, R17.2, TP4.1 (1_1), U1.3 (AGND), U1.4 (GND), U2.8 (GND), U3.8 (GND), U4.2 (GND); also elsewhere on the board
GNDPWR: J1.2, JP3.1 (A); also elsewhere on the board
L1-120VAC: F1.2, J1.3
L1_SW: C9.1, PS1.2 (AC/L), R8.2, RV1.1, SW1.2 (B); also elsewhere on the board
LN: C9.2, J1.1, PS1.1 (AC/N), R8.1, RV1.2; also elsewhere on the board
unnamed: C6.2, R2.2, R5.2, R6.1
unnamed: D1.1 (K), R7.1
unnamed: D2.1 (K), R9.1
unnamed: D4.1 (K), R16.1
unnamed: D5.1 (K), R17.1
unnamed: C6.1, C8.1, C10.1, JP2.1 (A), L1.2, R5.1
unnamed: JP4.2 (B), U4.5 (IN)
unnamed: C17.1, C19.1, JP6.1 (A), R12.2, R13.1, U3.6 (VOUT)
unnamed: C4.2, U1.7 (BOOT)
unnamed: R2.1, U1.1 (FB)
unnamed: C4.1, L1.1, U1.6 (LX)
unnamed: R3.2, R4.1, U2.7 (ADJ)
unnamed: R1.1, U2.1 (PGOOD)
unnamed: R13.2, R14.1, U3.7 (ADJ)
unnamed: C11.1, C12.1, FB1.2, U3.2 (EN), U3.3 (VIN), U3.4 (VDD)
unnamed: R12.1, U3.1 (PGOOD)
USB_EN: R10.1, U4.4 (~EN)
USB_OC: R11.1, U4.3 (~OC)
VBUS: C18.1, C20.1, D5.2 (A), TP22.1 (1_1), U4.1 (OUT); also elsewhere on the board

Notes on the sheet:
3.3VDC LDO Analog
120VAC - 12VDC Supply
3.3VDC LDO Digital
VBUS Supply Switch
IRM-10-5 Datasheet
MCP1727T-3302E/SN Datasheet
5VDC Buck Converter
120VAC Only! PCB clearances not designed for >120VAC
[${#}] ${TITLE}
Polyfuse not req'd since TPS2041 has O.C. protection
High Frequency! 500kHz Care should be taken to route switching node for buck converter
HIGH VOLTAGE: Ensure appropriate isolation between AC and DC circuits! Air isolation gap underneath PS1
3.3VA Rail has separate LDO to avoid MCU switching noise
V_{out}=V_{ref}(1+R_{1}/R_{2}) 5=0.8(1+10.5k/2k)

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
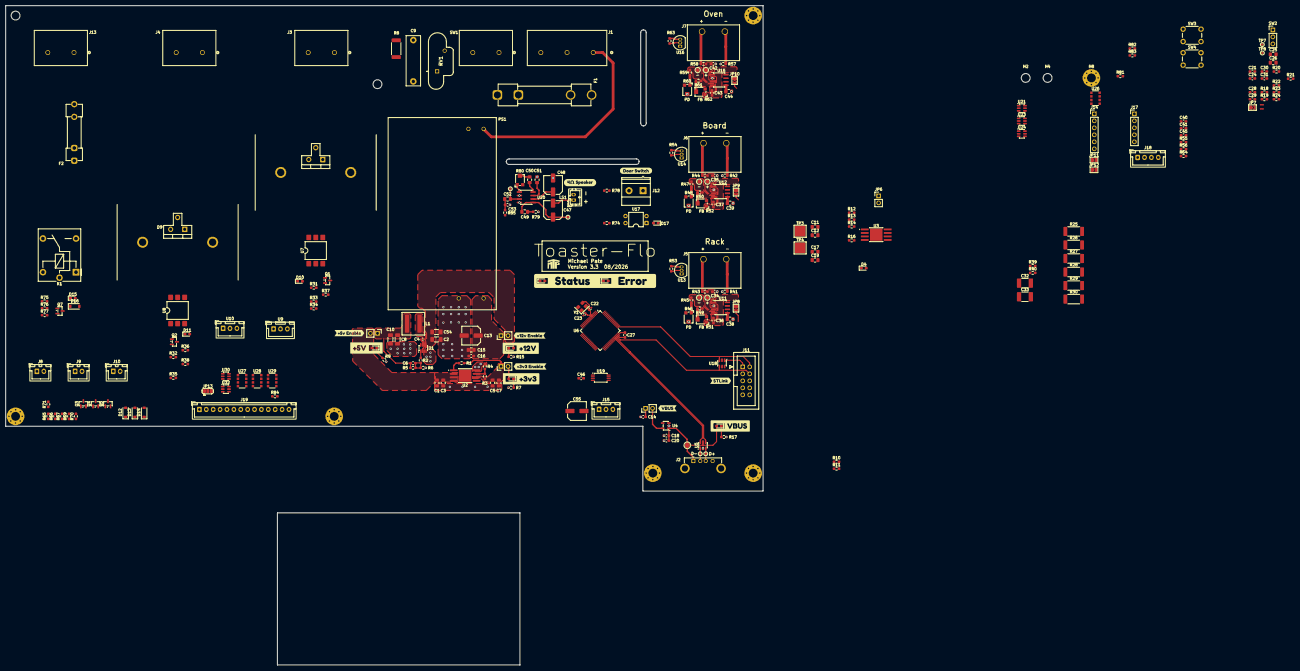
[picture p53: board mainBoard.kicad_pcb from above]

Board: 4 copper layers, 274.8 x 239.2 mm, 273 parts (1 on the bottom side), 158 nets.

Other parts of the board:
kobee-studio-6A7A4227: Kobee Studio; kobee-studio-6A7A4227
kobee-studio-6A78A6FA: Kobee Studio; kobee-studio-6A78A483
kobee-studio-6A78A34B: Kobee Studio; kobee-studio-6A788922
kobee-studio-6A78A548: Kobee Studio; kobee-studio-6A78A4EC
kobee-studio-6A78A618: Kobee Studio; kobee-studio-6A78A618
kobee-studio-6A78A703: Kobee Studio; kobee-studio-6A78A5D5
kobee-studio-6A78B9B1: Kobee Studio; kobee-studio-6A78B9B1
kobee-studio-6A78B988: Kobee Studio; kobee-studio-6A78B988
kobee-studio-6A7920CC: Kobee Studio; kobee-studio-6A7920CC
kobee-studio-6A79213B: Kobee Studio; kobee-studio-6A791FA5
kobee-studio-6A79225D: Kobee Studio; kobee-studio-6A791EC5
kobee-studio-6A788950: Kobee Studio; kobee-studio-6A788950
