MichaelPate/ToasterFlo/(commit log)

2026-06-10 Add revision 1 schematics
    [Block Diagram.kicad_sch, Power - Sequencing.kicad_sch, Project Architecture.kicad_sch, Revision History.kicad_sch, Section A - Title A.kicad_sch, Section B - TItle B.kicad_sch, connectors.kicad_sch, mainBoard.kicad_pcb]
2026-06-10 Update netclasses
    [mcu.kicad_sch]
2026-06-13 Add net colors and tweak MCU
    [mainBoard.kicad_pcb, mcu.kicad_sch]
2026-06-17 Schematic Capture should be complete, ready for PCB
    [connectors.kicad_sch, mainBoard.kicad_pcb, mcu.kicad_sch, powerSupply.kicad_sch, thermocouple.kicad_sch, triac.kicad_sch]
2026-06-18 tweak schematic for changes from 6-17-2026
    major structural changes, see daily note from obsidian
    [connectors.kicad_sch, mainBoard.kicad_pcb, mainBoard.kicad_sch, mcu.kicad_sch, powerSupply.kicad_sch, thermocouple.kicad_sch, triac.kicad_sch]
2026-06-20 work on pcb design
    [mainBoard.kicad_pcb, powerSupply.kicad_sch]
2026-06-20 working on pcb layout after bringing in work from laptop
    [connectors.kicad_sch, mainBoard.kicad_pcb, mcu.kicad_sch, powerSupply.kicad_sch, thermocouple.kicad_sch, triac.kicad_sch]
2026-06-20 update project to kicad 10
    [Block Diagram.kicad_sch, Power - Sequencing.kicad_sch, Project Architecture.kicad_sch, Revision History.kicad_sch, connectors.kicad_sch, mainBoard.kicad_pcb, mainBoard.kicad_sch, mcu.kicad_sch]
2026-06-23 board routing nearly complete
    [connectors.kicad_sch, mainBoard.kicad_pcb, mcu.kicad_sch, powerSupply.kicad_sch, thermocouple.kicad_sch]
2026-06-27 tweak board design more
    [bom.csv, designators.csv, mainBoard.kicad_pcb, mcu.kicad_sch, positions.csv]
2026-06-27 3d models added to PCB
    [mainBoard.kicad_pcb, mainBoard.kicad_sch, thermocouple.kicad_sch]
2026-06-29 board tweaked, sent for review
    [mainBoard.kicad_pcb, mcu.kicad_sch, powerSupply.kicad_sch]
2026-06-30 reworked AC switching and fusing
    [powerSupply.kicad_sch, triac.kicad_sch]
2026-06-30 change to C0G caps for thermocouple amps
    [thermocouple.kicad_sch]
2026-06-30 Add ESD protection to headers
    [connectors.kicad_sch]
2026-06-30 change to cheaper ESD TVS diodes
    [connectors.kicad_sch]
2026-06-30 Add pullup resistors to digital thermometers
    [connectors.kicad_sch, thermocouple.kicad_sch, triac.kicad_sch]
2026-07-22 Nearly finished with board after revisions
    [connectors.kicad_sch, mainBoard.kicad_pcb, mcu.kicad_sch, powerSupply.kicad_sch, thermocouple.kicad_sch, triac.kicad_sch]
2026-07-23 work on AC power side
    [connectors.kicad_sch, mainBoard.kicad_pcb, mcu.kicad_sch, powerSupply.kicad_sch, triac.kicad_sch]
2026-07-23 still arranging AC side
    [mainBoard.kicad_pcb, powerSupply.kicad_sch]
2026-07-23 swapped MT pins on opto triacs
    [mainBoard.kicad_pcb, triac.kicad_sch]
2026-07-28 fine tuning
    [mainBoard.kicad_pcb, triac.kicad_sch]
2026-07-29 add air gaps under triac pins
    [mainBoard.kicad_pcb]
2026-07-29 add spacing to heatsink pins
    [mainBoard.kicad_pcb]
2026-07-29 adjust pour for top heating element l1
    [mainBoard.kicad_pcb]
2026-07-30 working on pcb
    [mainBoard.kicad_pcb]
2026-07-30 final hcanges before review post
    [mainBoard.kicad_pcb, mainBoard.kicad_sch]
2026-08-05 add USB-A and change capacitors
    [connectors.kicad_sch, mcu.kicad_sch, powerSupply.kicad_sch]
2026-08-05 updating power supplies to richtek
    [mainBoard.kicad_pcb, powerSupply.kicad_sch]
2026-08-05 Finish changing to Richtek power supplies
2026-08-05 change to single 4" touchscreen for UI instead of keypad and buttons
    [connectors.kicad_sch, mainBoard.kicad_pcb, mcu.kicad_sch, powerSupply.kicad_sch, thermocouple.kicad_sch, triac.kicad_sch]
2026-08-05 change to stm32f413 and add a QSPI SRAM
    [connectors.kicad_sch, mcu.kicad_sch, powerSupply.kicad_sch, triac.kicad_sch]
2026-08-05 recreated a bunch of parts on the pcb layout
    [mainBoard.kicad_pcb]
2026-08-05 change to 48MHz crystal
    [mcu.kicad_sch]
2026-08-05 critical peripherals are placed
    Schematic is ready for rough layout. Non critical things like regular GPIO are not assigned yet, as their optimal pin is dependent on board layout
    [mcu.kicad_sch]
2026-08-07 replace piezo with actual speaker
    [connectors.kicad_sch, mainBoard.kicad_pcb, mcu.kicad_sch, powerSupply.kicad_sch]
2026-08-07 tweak schematic for readability
    [connectors.kicad_sch]
2026-08-10 working on layout
    [connectors.kicad_sch, mainBoard.kicad_pcb, powerSupply.kicad_sch, triac.kicad_sch]
2026-08-10 add ws2812 led header
    [connectors.kicad_sch]
2026-08-10 work on layout, change to larger inductor
    [mainBoard.kicad_pcb, powerSupply.kicad_sch]
2026-08-10 add to layout
    [mainBoard.kicad_pcb]
2026-08-13 generate step file for basic cad creation
    [toasterflo.step]
2026-08-24 changes from windows copy to ubuntu
    [connectors.kicad_sch, mainBoard.kicad_pcb]
